Yeriwyn/VoronUsers/printer_mods/BladeScraper-Designs/Horizontal-Spool-Holder/img/Holder-Real.jpg

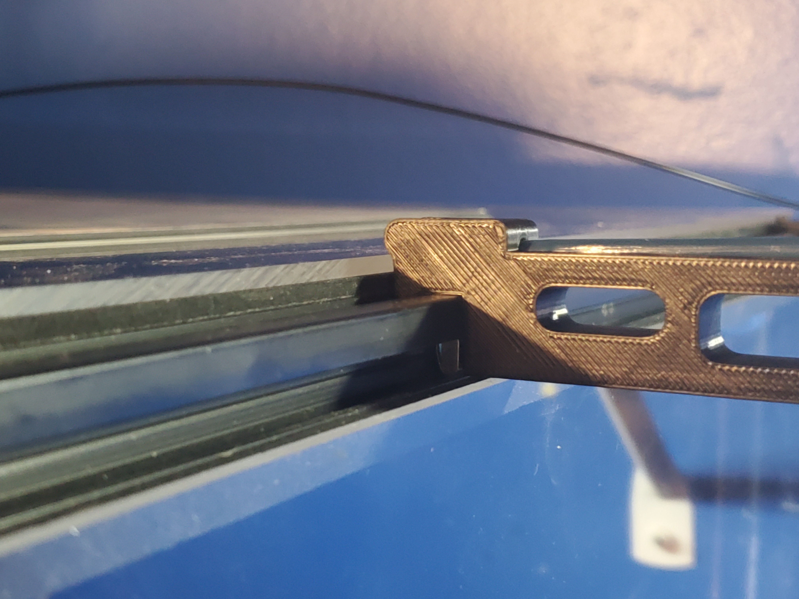
printer_mods/BladeScraper-Designs/Horizontal-Spool-Holder/img/Holder-Real.jpg
