Yeriwyn/VoronUsers/printer_mods/BladeScraper-Designs/Horizontal-Spool-Holder/img/Holder-with-spool.jpg

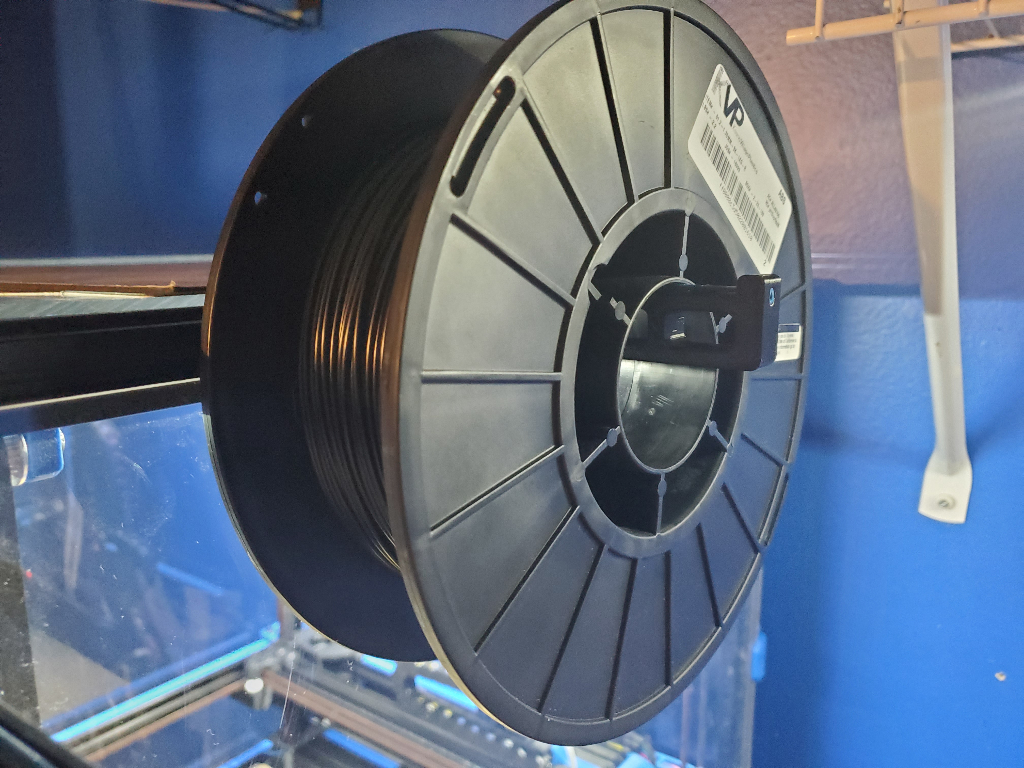
printer_mods/BladeScraper-Designs/Horizontal-Spool-Holder/img/Holder-with-spool.jpg
