Yeriwyn/VoronUsers/printer_mods/BladeScraper-Designs/Horizontal-Spool-Holder/img/Holder.png

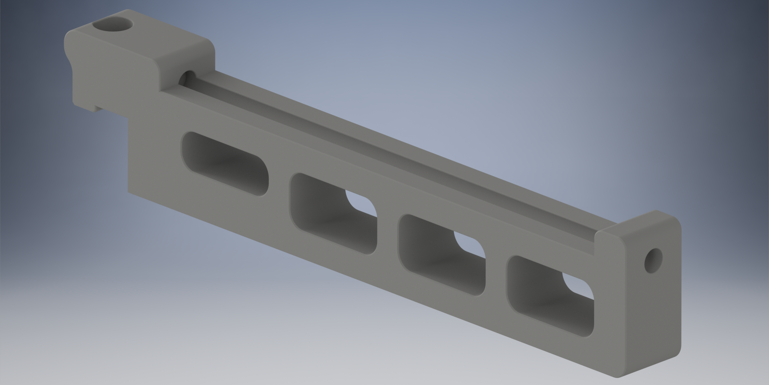
printer_mods/BladeScraper-Designs/Horizontal-Spool-Holder/img/Holder.png
