Yeriwyn/VoronUsers/printer_mods/BladeScraper-Designs/Horizontal-Spool-Holder/img/Holder_1.png

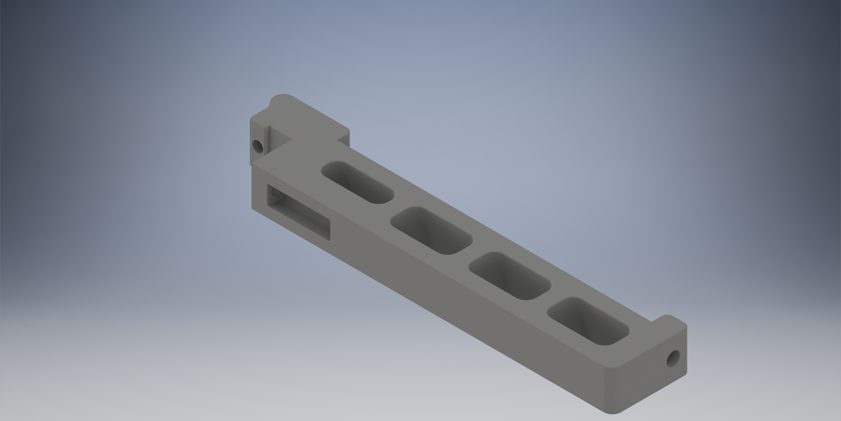
printer_mods/BladeScraper-Designs/Horizontal-Spool-Holder/img/Holder_1.png
