Yeriwyn/VoronUsers/printer_mods/JosAr/Klicky-Probe/Photos/AB_mount_components.jpg

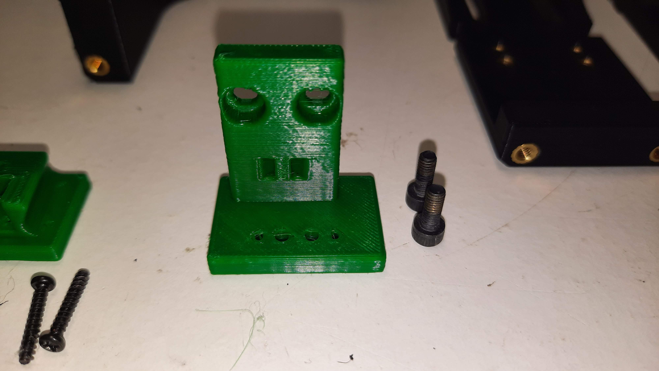
printer_mods/JosAr/Klicky-Probe/Photos/AB_mount_components.jpg
