Yeriwyn/VoronUsers/printer_mods/JosAr/Klicky-Probe/Photos/gantry_fixed_dock_mount_components.jpg

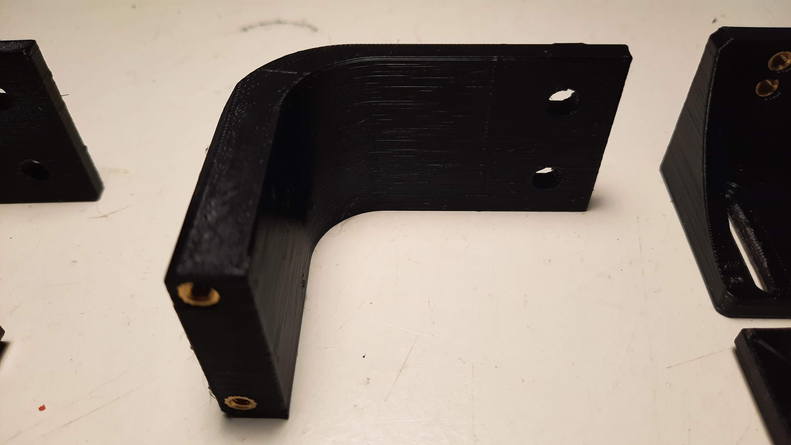
printer_mods/JosAr/Klicky-Probe/Photos/gantry_fixed_dock_mount_components.jpg
