Yeriwyn/VoronUsers/printer_mods/JosAr/Klicky-Probe/Photos/gantry_fixed_dock_sidemount_components.jpg

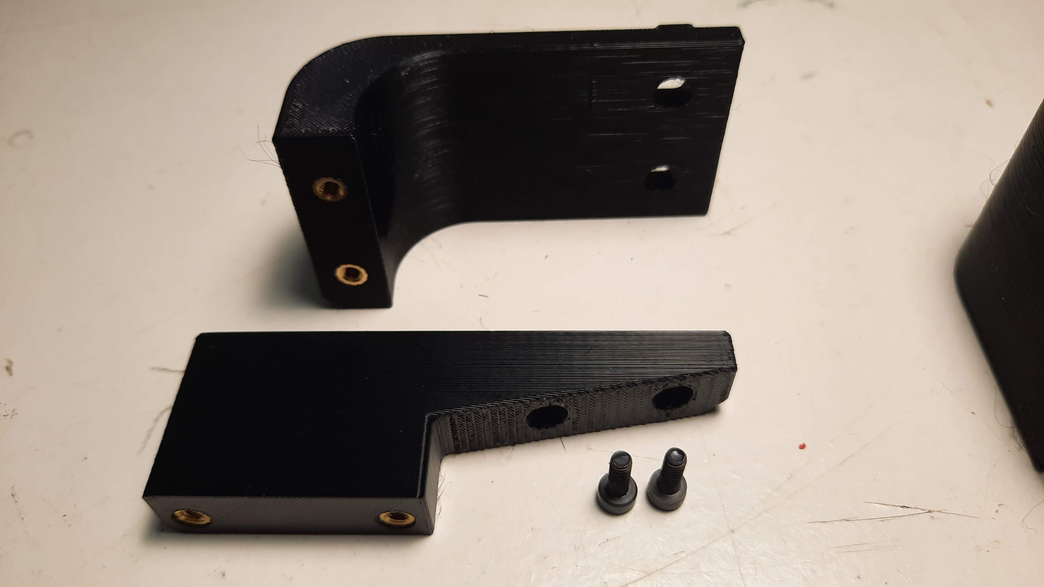
printer_mods/JosAr/Klicky-Probe/Photos/gantry_fixed_dock_sidemount_components.jpg
