Yeriwyn/VoronUsers/printer_mods/JosAr/Klicky-Probe/Photos/gantry_variable_dock_mount_components.jpg

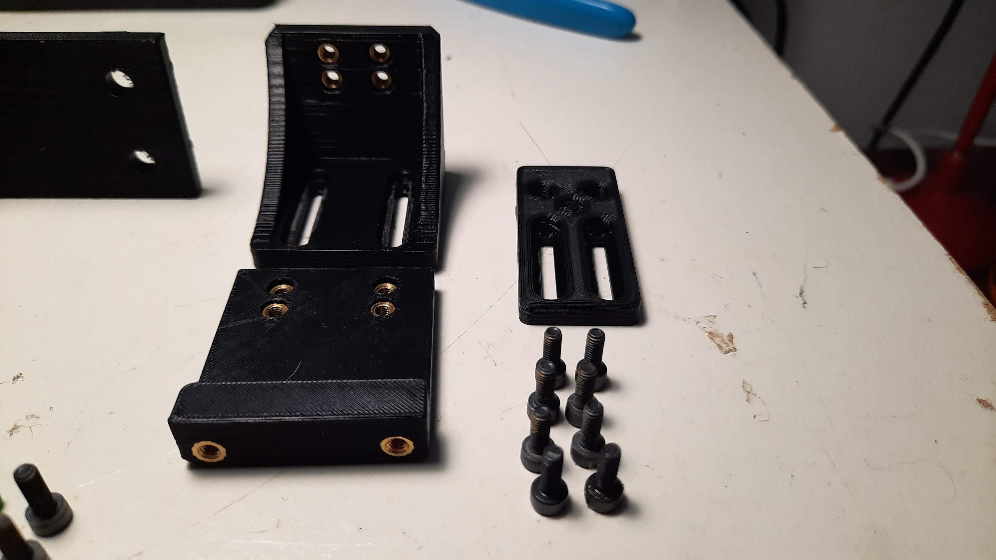
printer_mods/JosAr/Klicky-Probe/Photos/gantry_variable_dock_mount_components.jpg
