Yeriwyn/VoronUsers/printer_mods/Shteeeeeve/V01-LED-Tophat/STLs/LED-Tophat-Main-Body.stl

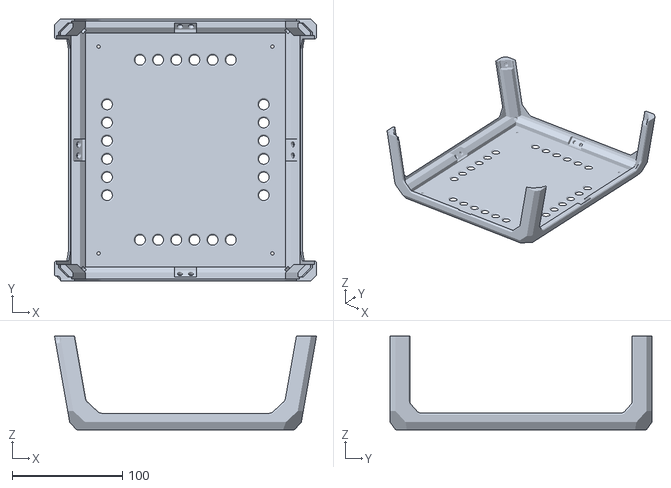
[picture p10: CAD file, 2021-07-27]
printer_mods/Shteeeeeve/V01-LED-Tophat/STLs/LED-Tophat-Main-Body.stl
238.0 x 238.0 x 85.0
