Yeriwyn/VoronUsers/printer_mods/alanho/BTT_PITFT50_v2_Mount/STLs/BTT-PITFT50-v2-Mount.stl

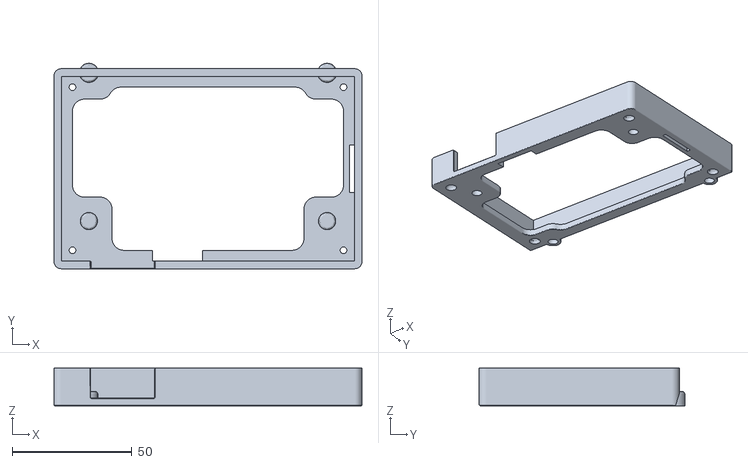
[picture p12: CAD file, 2021-06-30]
printer_mods/alanho/BTT_PITFT50_v2_Mount/STLs/BTT-PITFT50-v2-Mount.stl
128.4 x 85.7 x 15.7
