Yeriwyn/VoronUsers/printer_mods/Andre/Mini_Afterburner_ADXL345_Mount/STL/MiniAB_ADXL345_Mount.stl

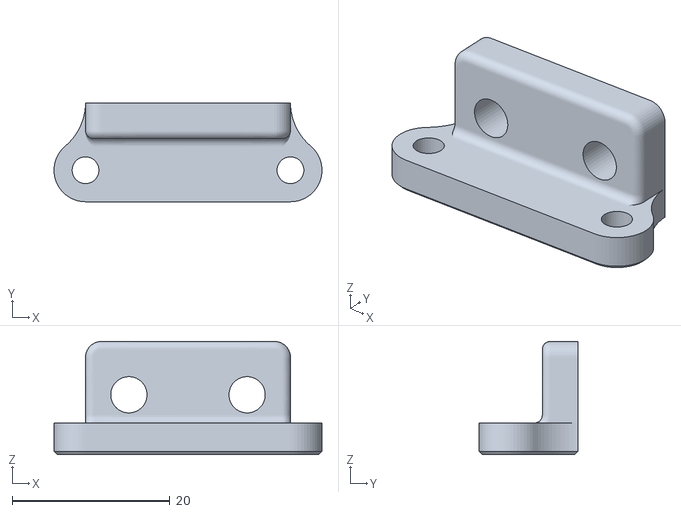
[picture p13: CAD file, 2021-06-30]
printer_mods/Andre/Mini_Afterburner_ADXL345_Mount/STL/MiniAB_ADXL345_Mount.stl
34.0 x 12.5 x 14.3
