Yeriwyn/VoronUsers/printer_mods/Andre/Mini_Afterburner_Strain_Relief/STL/Strain_Relief_Spacer_x2.stl

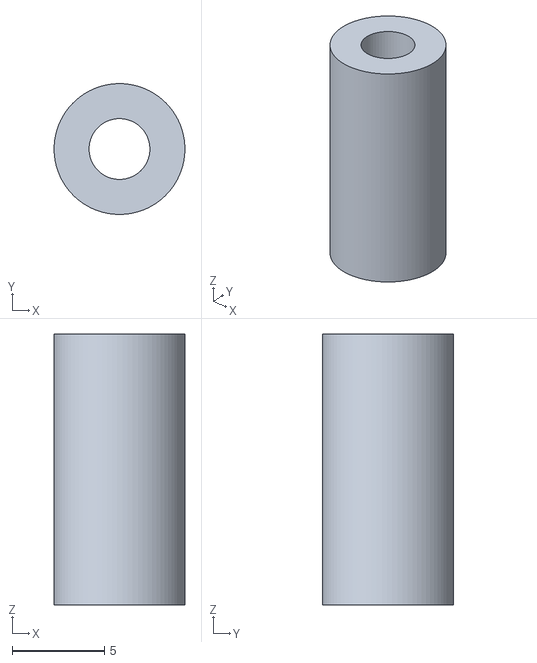
[picture p14: CAD file, 2021-06-30]
printer_mods/Andre/Mini_Afterburner_Strain_Relief/STL/Strain_Relief_Spacer_x2.stl
7.10 x 7.10 x 14.7
