Yeriwyn/VoronUsers/printer_mods/Andre/V0_Neopixel_Front_Bed_Mount/STL/Front_Bed_Mount_x1.stl

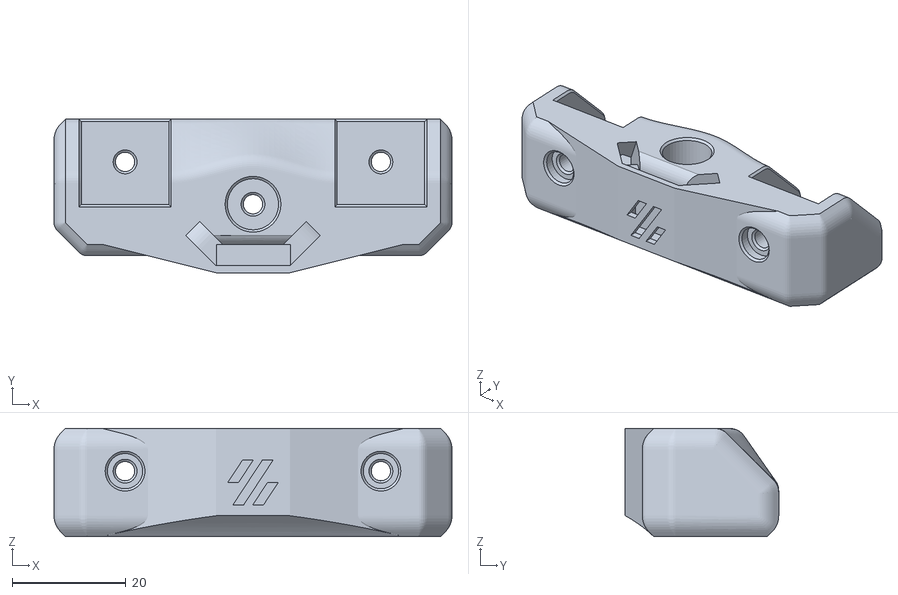
[picture p15: CAD file, 2021-06-30]
printer_mods/Andre/V0_Neopixel_Front_Bed_Mount/STL/Front_Bed_Mount_x1.stl
70.0 x 27.0 x 19.0
