Yeriwyn/VoronUsers/printer_mods/BladeScraper-Designs/Horizontal-Spool-Holder/Holder.stp

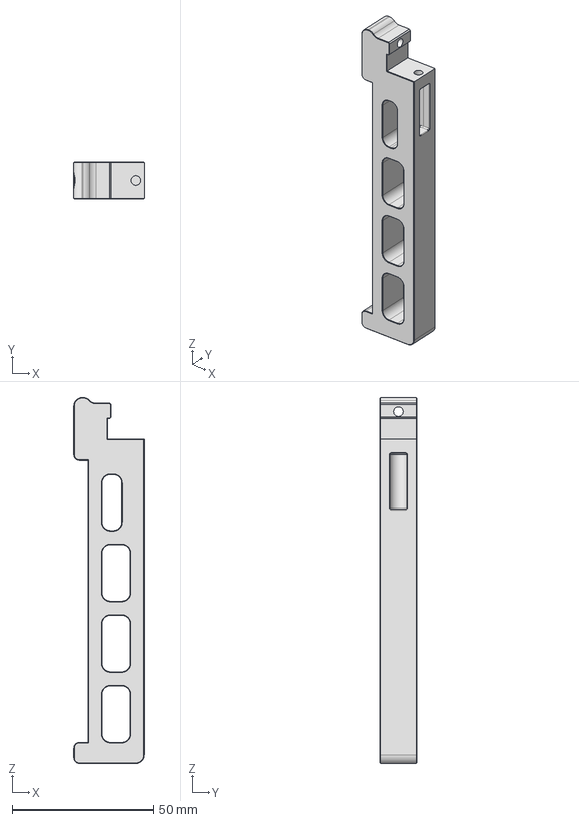
[picture p16: CAD file, 2021-06-30]
printer_mods/BladeScraper-Designs/Horizontal-Spool-Holder/Holder.stp
25.0 x 13.0 x 129.8 mm
