Yeriwyn/VoronUsers/printer_mods/buzzdalf/ytension/STL/hexnut.stl

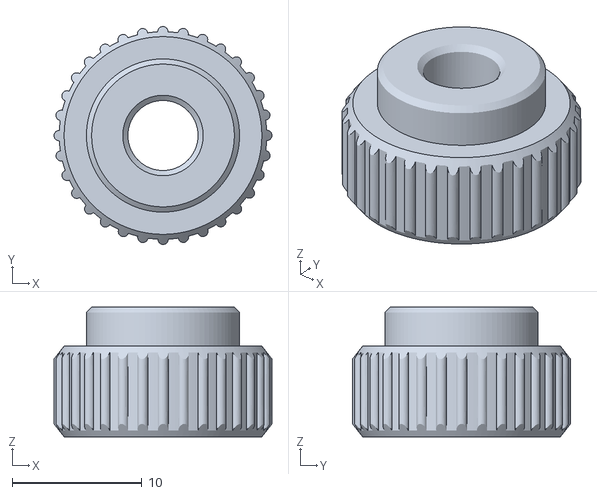
[picture p17: CAD file, 2021-06-30]
printer_mods/buzzdalf/ytension/STL/hexnut.stl
16.8 x 16.8 x 10.0
