Yeriwyn/VoronUsers/printer_mods/Ch4rlesB/V0_Handles_Slim/V0_Handles_Slim_3_Panel_x2.stl

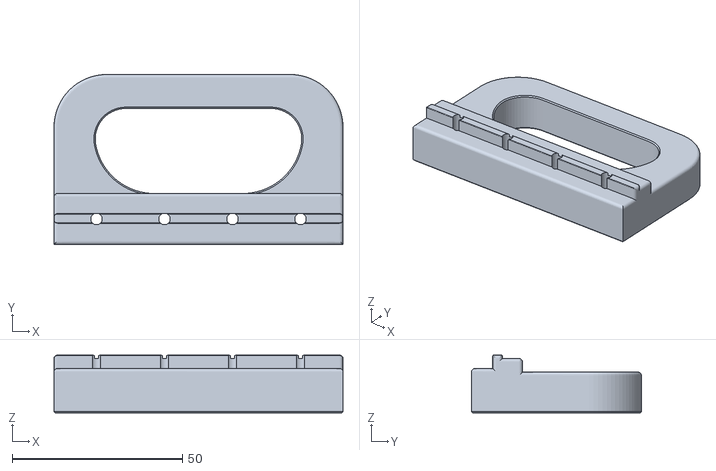
[picture p18: CAD file, 2021-06-30]
printer_mods/Ch4rlesB/V0_Handles_Slim/V0_Handles_Slim_3_Panel_x2.stl
85.0 x 50.0 x 17.0
