Yeriwyn/VoronUsers/printer_mods/DaGlo/Voron_V0_Duet_2_WiFi_Mounting_Brackets/Duet2Wifi_Mounting_Bracket_with_RPi.stl

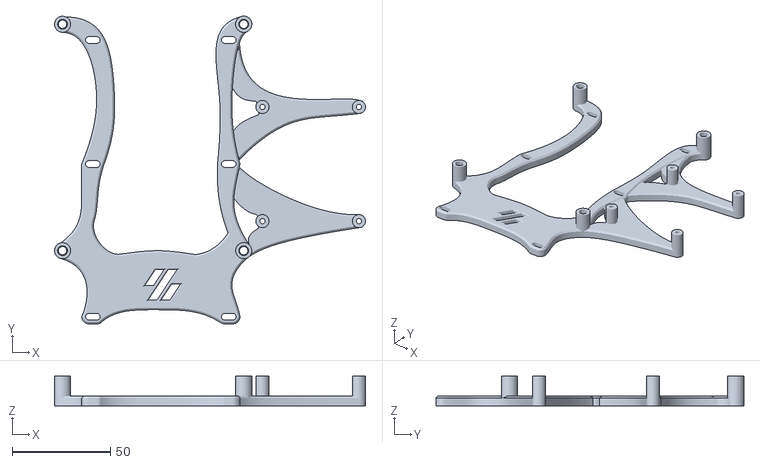
[picture p20: CAD file, 2021-06-30]
printer_mods/DaGlo/Voron_V0_Duet_2_WiFi_Mounting_Brackets/Duet2Wifi_Mounting_Bracket_with_RPi.stl
157.9 x 156.4 x 15.0
