Yeriwyn/VoronUsers/printer_mods/DaGlo/Voron_V0_MW_PS_Bracket/Voron_V0_MW_PS_Bracket.stl

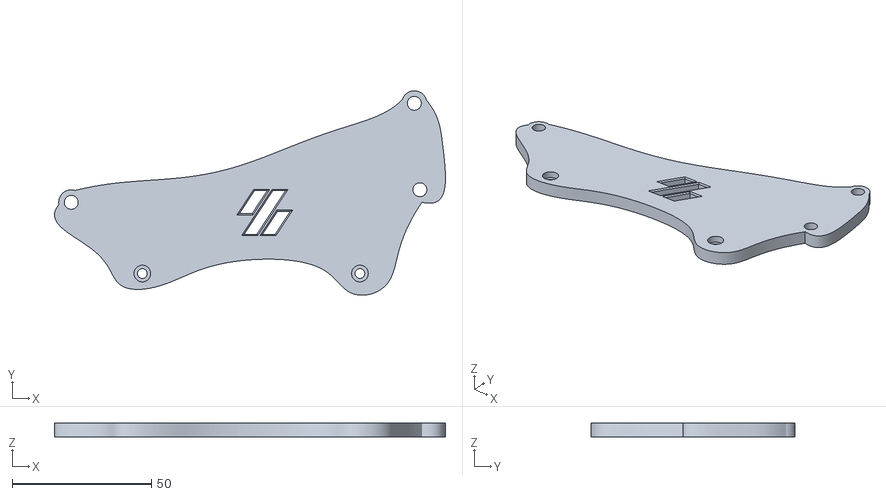
[picture p21: CAD file, 2021-06-30]
printer_mods/DaGlo/Voron_V0_MW_PS_Bracket/Voron_V0_MW_PS_Bracket.stl
140.2 x 73.3 x 5.00
