Yeriwyn/VoronUsers/printer_mods/DaGlo/Voron_V0_SSR_Mount/Voron_V0_SSR_Mount.stl

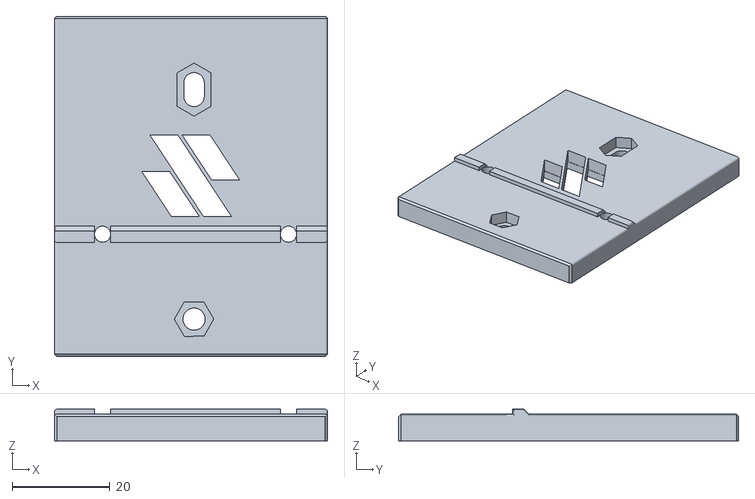
[picture p22: CAD file, 2021-06-30]
printer_mods/DaGlo/Voron_V0_SSR_Mount/Voron_V0_SSR_Mount.stl
55.8 x 69.5 x 6.45
