Yeriwyn/VoronUsers/printer_mods/DoubleT/afterburner_triple_bowden/STLs/Bowden_Triple_Adapter_front_b.stl

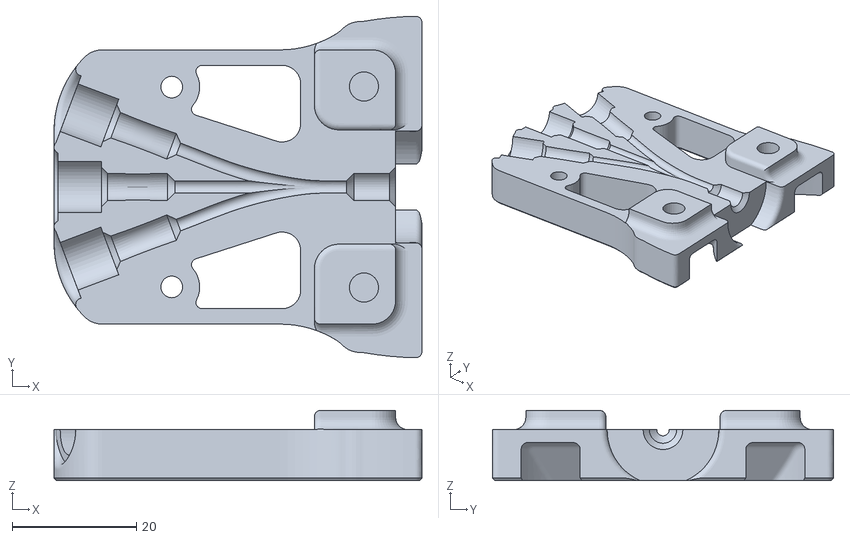
[picture p23: CAD file, 2021-06-30]
printer_mods/DoubleT/afterburner_triple_bowden/STLs/Bowden_Triple_Adapter_front_b.stl
59.3 x 55.0 x 11.3
