Yeriwyn/VoronUsers/printer_mods/DoubleT/fysetc_spider_mount_extrusion/STLs/spider_mount.stl

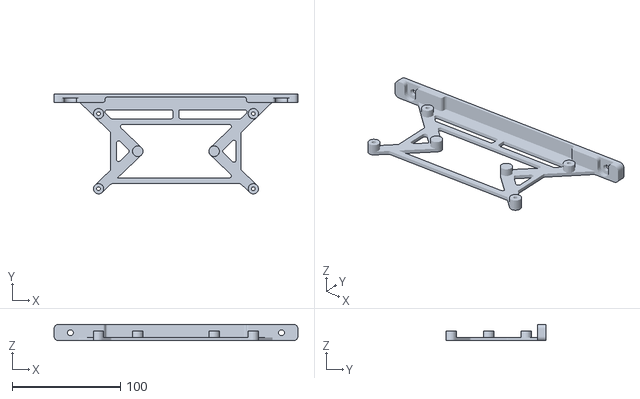
[picture p24: CAD file, 2021-06-30]
printer_mods/DoubleT/fysetc_spider_mount_extrusion/STLs/spider_mount.stl
225.1 x 92.1 x 15.0
