Yeriwyn/VoronUsers/printer_mods/DoubleT/switchwire_tft_display/STLs/Display_Front_Plate.stl

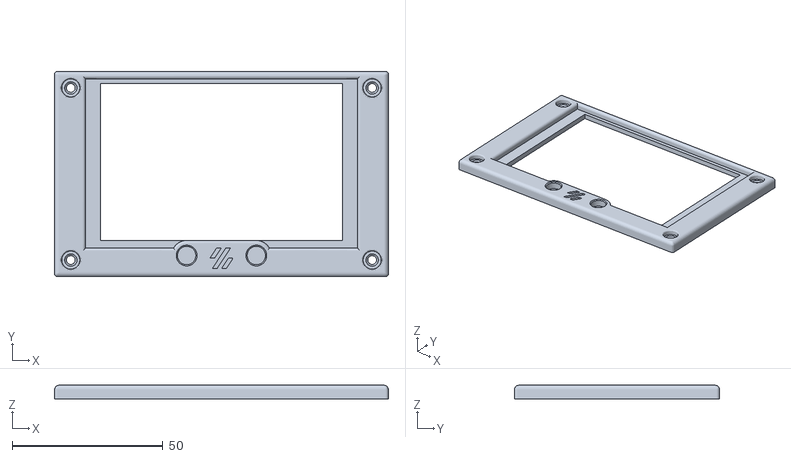
[picture p26: CAD file, 2021-06-30]
printer_mods/DoubleT/switchwire_tft_display/STLs/Display_Front_Plate.stl
110.6 x 68.0 x 4.50
