Yeriwyn/VoronUsers/printer_mods/geoffreyyoung/spider_bracket/STLs/spider_bracket.stl

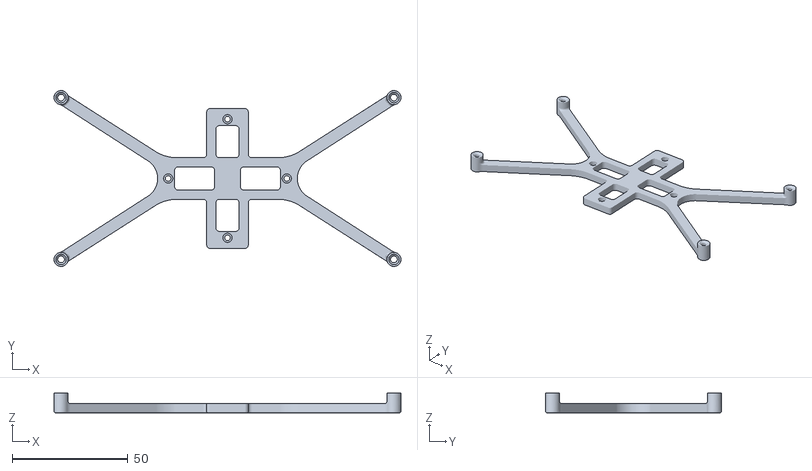
[picture p28: CAD file, 2021-06-30]
printer_mods/geoffreyyoung/spider_bracket/STLs/spider_bracket.stl
150.1 x 76.1 x 8.50
