Yeriwyn/VoronUsers/printer_mods/hartk1213/Voron0_MGN9C_X_Axis/STLs/x_carriage_miniaftb-MGN9C_x1.stl

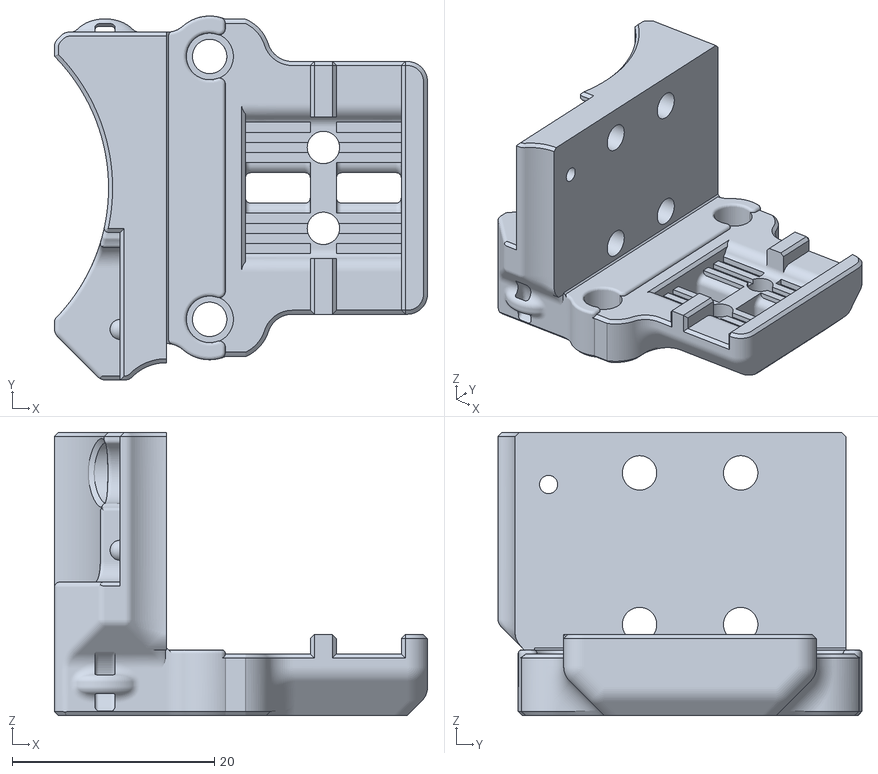
[picture p29: CAD file, 2021-06-30]
printer_mods/hartk1213/Voron0_MGN9C_X_Axis/STLs/x_carriage_miniaftb-MGN9C_x1.stl
36.9 x 36.0 x 28.0
