Yeriwyn/VoronUsers/printer_mods/JosAr/Klicky-Probe/CAD/KlickyProbe_v0_2.step

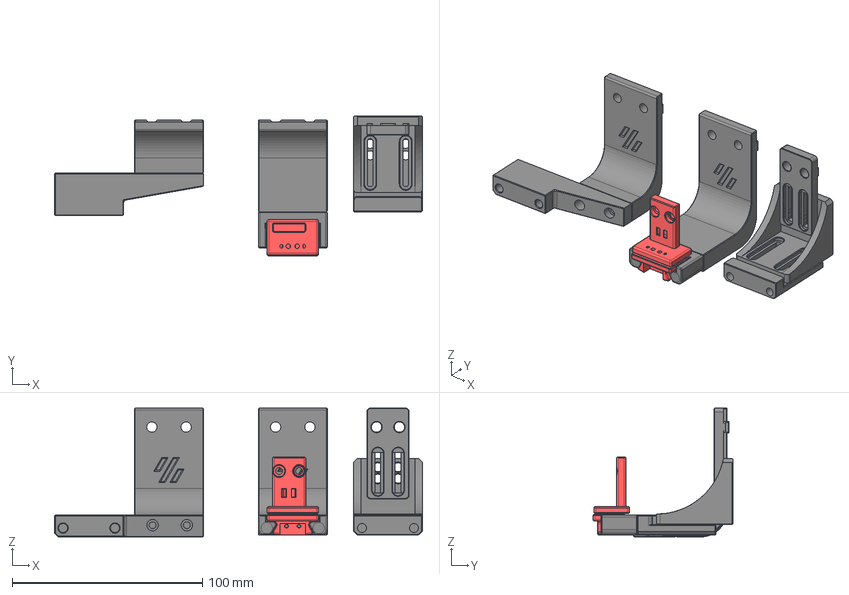
[picture p30: CAD file, 2021-06-30]
printer_mods/JosAr/Klicky-Probe/CAD/KlickyProbe_v0_2.step
193.3 x 73.5 x 67.7 mm
AB mount
Dock Mount variable Assembly
Dock Mount fixed
Dock Sidemount fixed
Probe Dock v0.2
Probe v0.2
