Yeriwyn/VoronUsers/printer_mods/JosAr/Klicky-Probe/STL/KlickyProbe_Dock_Mount_Variable_pt3.stl

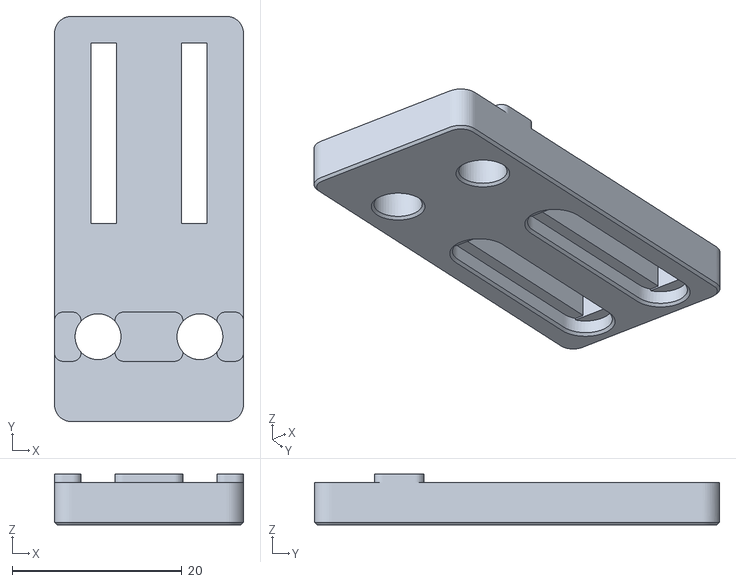
[picture p31: CAD file, 2021-06-30]
printer_mods/JosAr/Klicky-Probe/STL/KlickyProbe_Dock_Mount_Variable_pt3.stl
22.3 x 47.7 x 5.98
