Yeriwyn/VoronUsers/printer_mods/JosAr/Klicky-Probe/Usermods/oc_geek/oc_geek.step

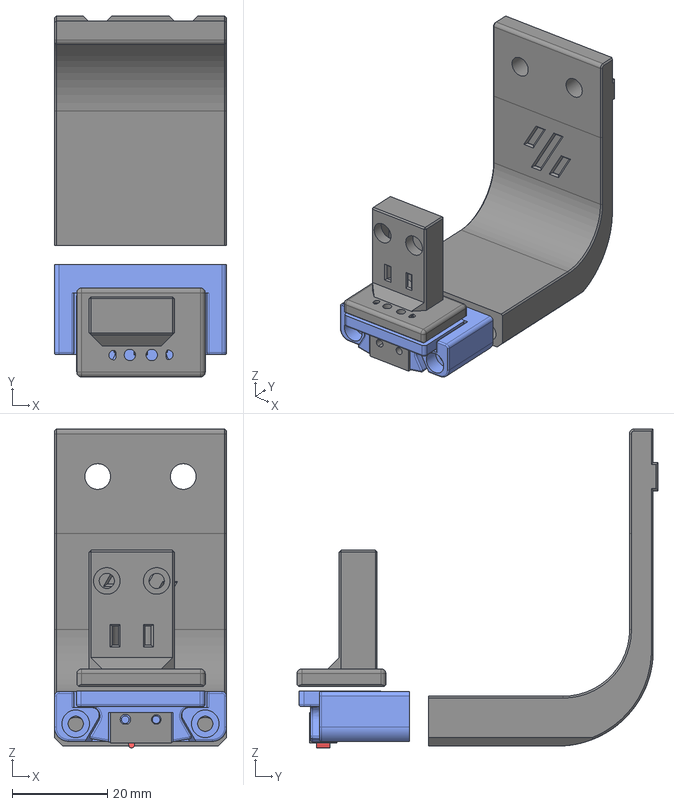
[picture p32: CAD file, 2021-06-30]
printer_mods/JosAr/Klicky-Probe/Usermods/oc_geek/oc_geek.step
36.3 x 76.0 x 67.1 mm
AB mount
Probe Dock v2
Dock Mount fixed
D2F_BASE (1)
D2F_ACTUATOR (1)
