Yeriwyn/VoronUsers/printer_mods/KevinAkaSam/VEFACH/STL_CAD/0_filterdummy_dont_print.stl

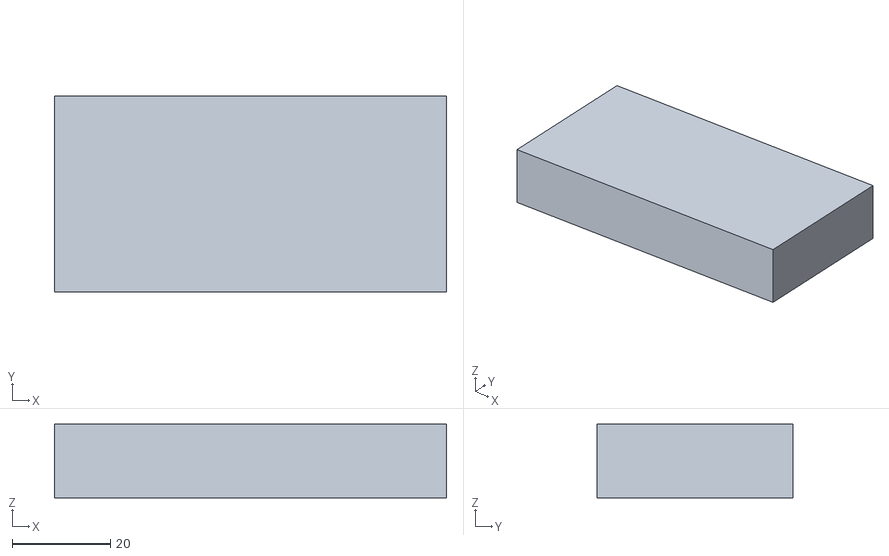
[picture p33: CAD file, 2021-06-30]
printer_mods/KevinAkaSam/VEFACH/STL_CAD/0_filterdummy_dont_print.stl
80.0 x 40.0 x 15.0
