Yeriwyn/VoronUsers/printer_mods/khay/micro_backplate/microback_left.stl

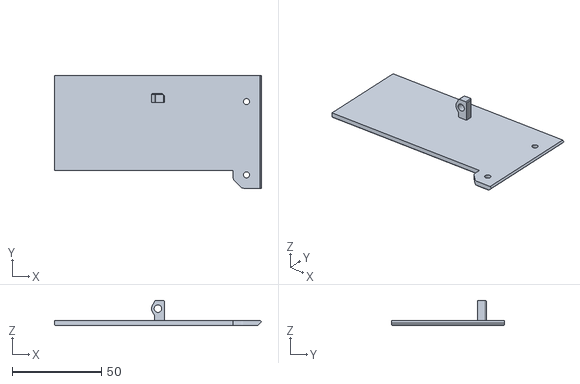
[picture p34: CAD file, 2021-07-27]
printer_mods/khay/micro_backplate/microback_left.stl
115.9 x 63.0 x 14.2
