Yeriwyn/VoronUsers/printer_mods/LoCoCNC/ssr_strap/SSR_STRAP.stl

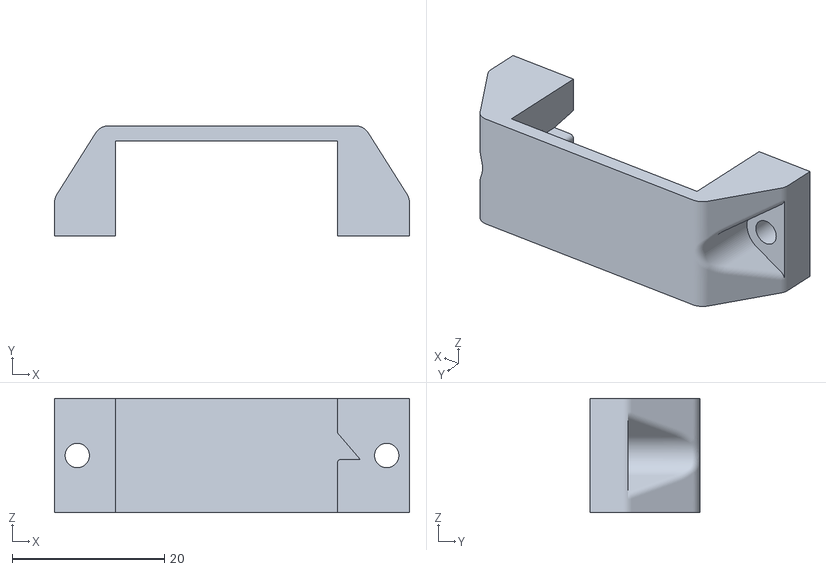
[picture p35: CAD file, 2021-06-30]
printer_mods/LoCoCNC/ssr_strap/SSR_STRAP.stl
46.7 x 14.5 x 15.0
