Yeriwyn/VoronUsers/printer_mods/LoCoCNC/Strain_Relief_w_Microfit/Strain_Relief_Body_MF10_x1.stl

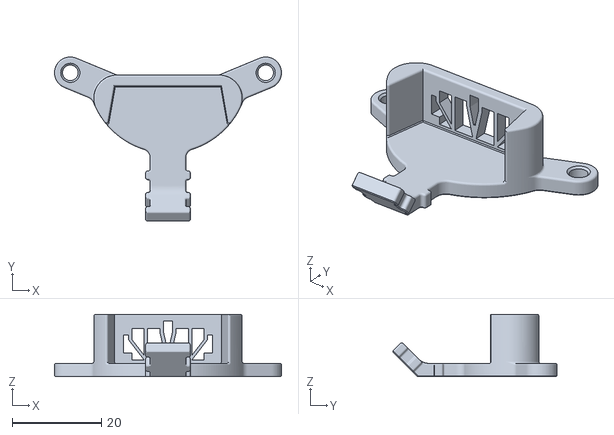
[picture p36: CAD file, 2021-06-30]
printer_mods/LoCoCNC/Strain_Relief_w_Microfit/Strain_Relief_Body_MF10_x1.stl
50.9 x 36.8 x 14.0
