Yeriwyn/VoronUsers/printer_mods/Majarspeed/Hartk_Mount_Galileo/Hartk_optional_spacer_X2.stl

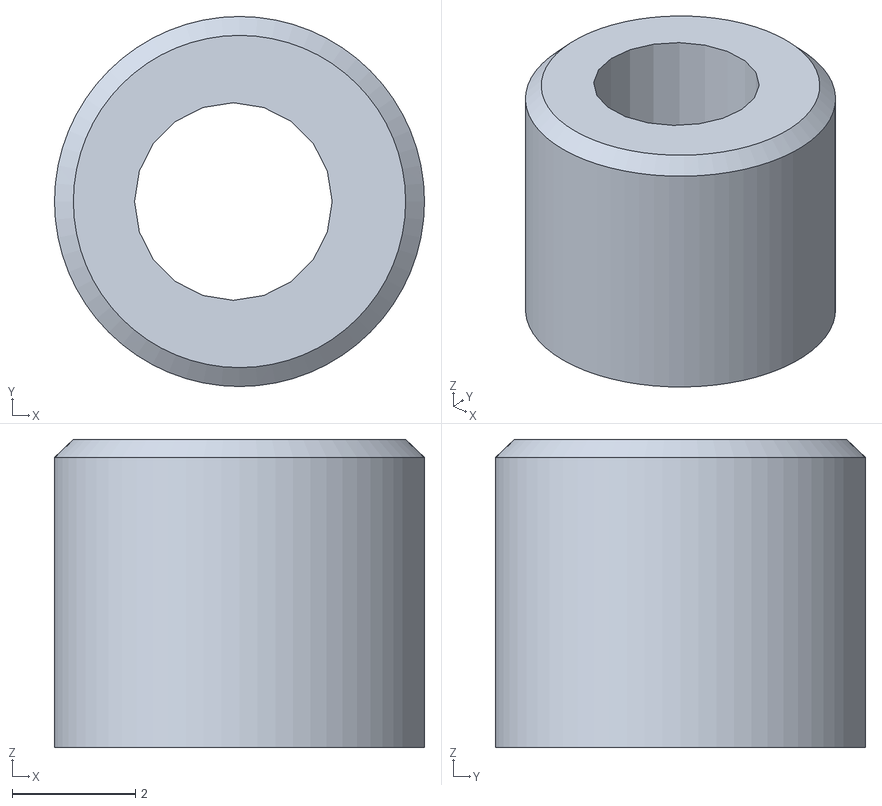
[picture p37: CAD file, 2021-06-30]
printer_mods/Majarspeed/Hartk_Mount_Galileo/Hartk_optional_spacer_X2.stl
6.00 x 6.00 x 5.00
