Yeriwyn/VoronUsers/printer_mods/MathematicalPotato/v0.1_belted_z_drive/STL/V0-zbelt-BEDMOUNT_MODIFIED_V0.1.stl

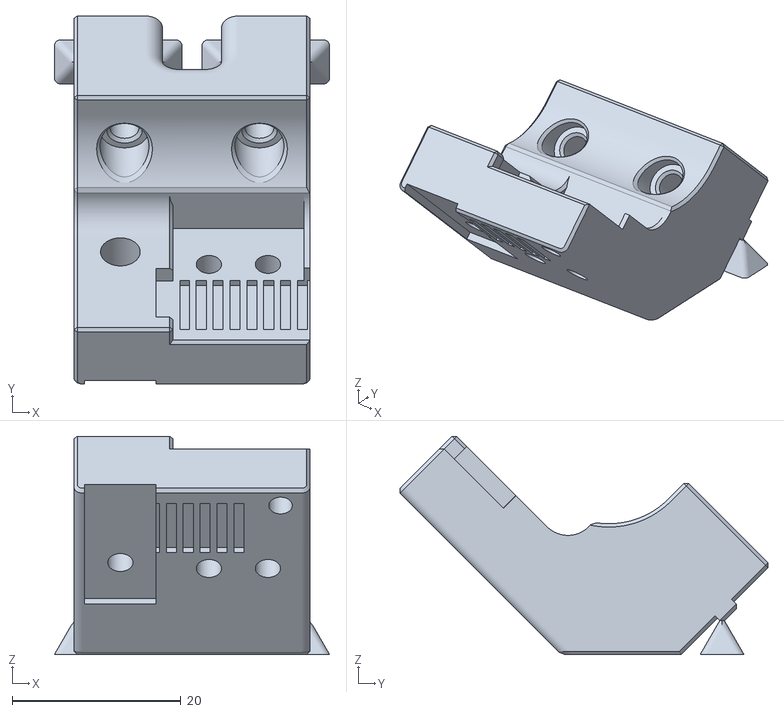
[picture p38: CAD file, 2021-06-30]
printer_mods/MathematicalPotato/v0.1_belted_z_drive/STL/V0-zbelt-BEDMOUNT_MODIFIED_V0.1.stl
32.7 x 43.6 x 25.9
