Yeriwyn/VoronUsers/printer_mods/mpfl/V0.1_skirt_OLED/v0.1-skirt-oled.stl

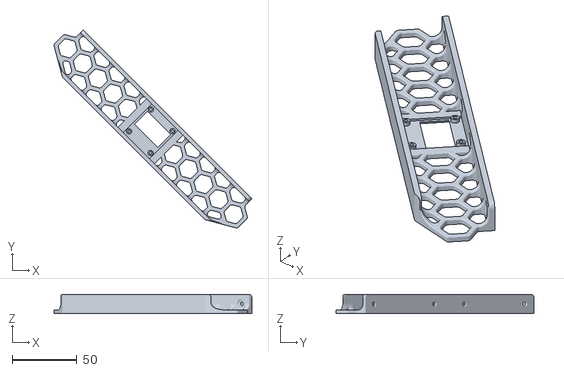
[picture p39: CAD file, 2021-07-27]
printer_mods/mpfl/V0.1_skirt_OLED/v0.1-skirt-oled.stl
152.4 x 152.4 x 15.0
