Yeriwyn/VoronUsers/printer_mods/oxno/rbp_zero_braket/rbp_zero_bracket.stl

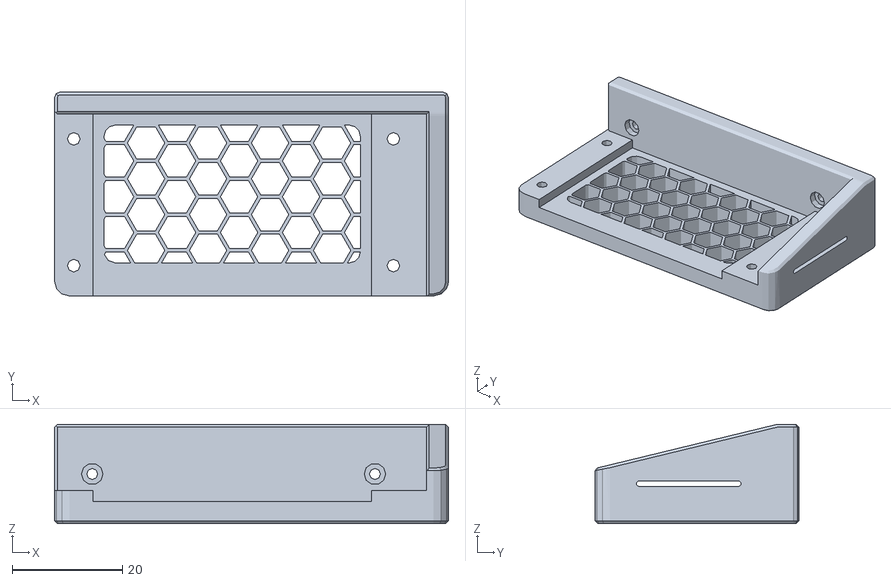
[picture p40: CAD file, 2021-06-30]
printer_mods/oxno/rbp_zero_braket/rbp_zero_bracket.stl
71.5 x 37.0 x 18.0
