Yeriwyn/VoronUsers/printer_mods/Phalanx/Other-V2-Idlers/CAD/Other_Idler_V2.step

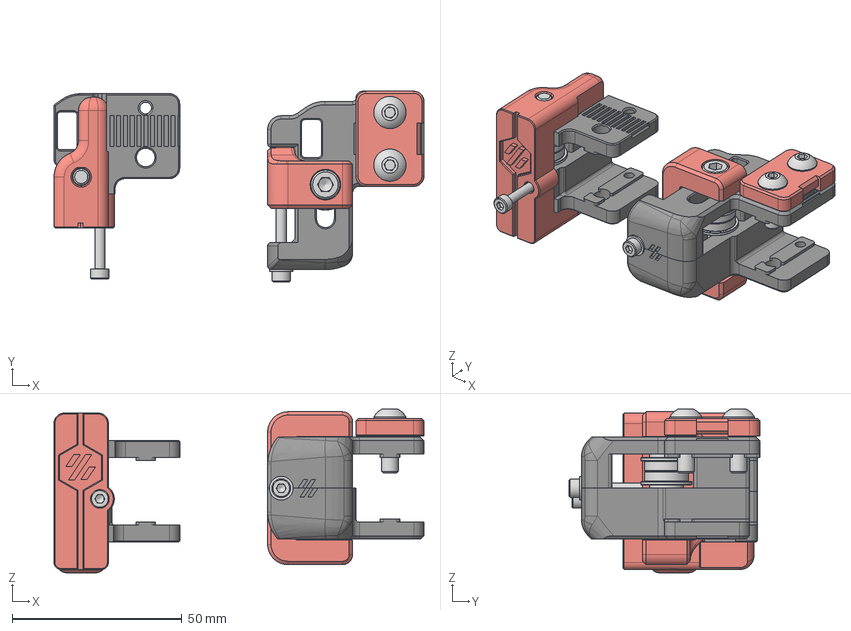
[picture p41: CAD file, 2021-07-27]
printer_mods/Phalanx/Other-V2-Idlers/CAD/Other_Idler_V2.step
108.9 x 56.1 x 48.1 mm
M5 1mm Spacer (1) (1) x 2
F695 ZZ (1) (1) x 2
Front Idler A Bottom (1) (1) (1)
Front Idler A Top (1) (1)
5mmx45mm pin
Idler_Carrier
M5x16 BHCS (1) (1) (1) x 2
Z Belt Clamp Upper (1) (1)
M5x40 SHCS (1)
M5 Hexnut (1)
M5 1mm Spacer (1) (1) (1) x 2
F695 ZZ (1) (1) (1) x 2
M3 Threaded Insert (1)
M3x40 SHCS (1) (1) x 2
M3 Washer (1) (1)
Front Idler A Bottom (1) (1) (1) (1)
Front Idler A Top (1) (1) (1)
M3 Threaded Insert (1) (1)
