Yeriwyn/VoronUsers/printer_mods/Phalanx/Other-V2-Idlers/STL/[a]_Idler_Carrierx2.stl

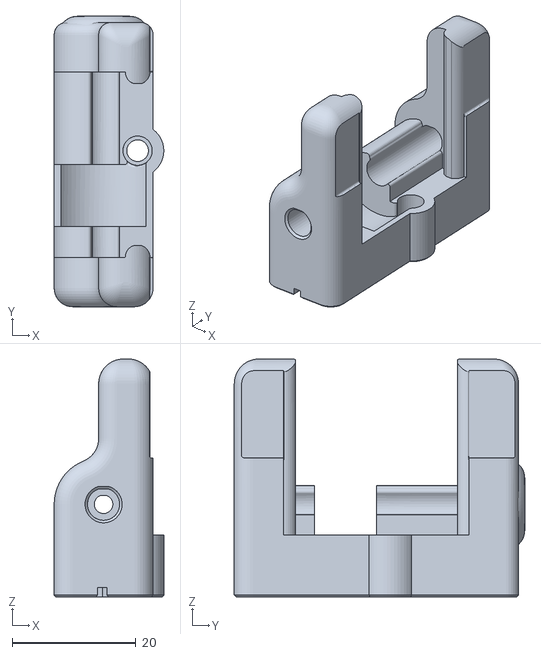
[picture p42: CAD file, 2021-07-27]
printer_mods/Phalanx/Other-V2-Idlers/STL/[a]_Idler_Carrierx2.stl
17.8 x 47.0 x 38.5
