Yeriwyn/VoronUsers/printer_mods/Printopal/Magnetic_top_panel/STEP/350_top_skirt_320.stp

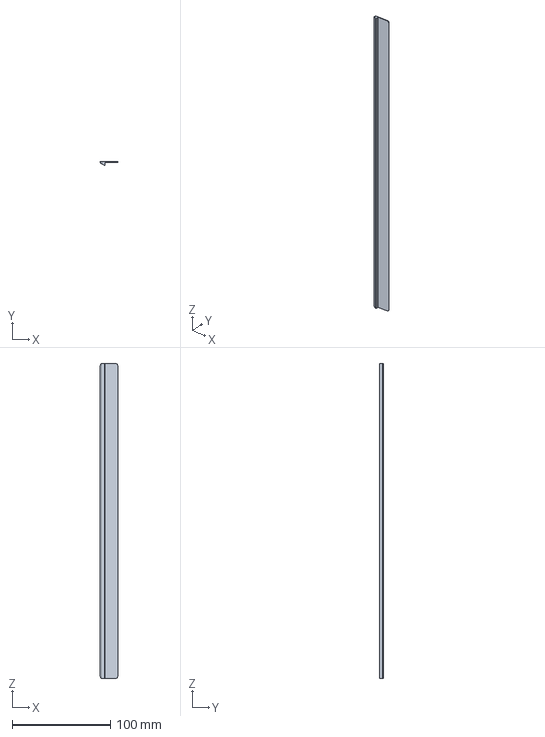
[picture p43: CAD file, 2021-07-27]
printer_mods/Printopal/Magnetic_top_panel/STEP/350_top_skirt_320.stp
17.8 x 4.40 x 320.0 mm
