Yeriwyn/VoronUsers/printer_mods/revnull/rpi_7in_display_mount/STL/swing_arm_lg_a.stl

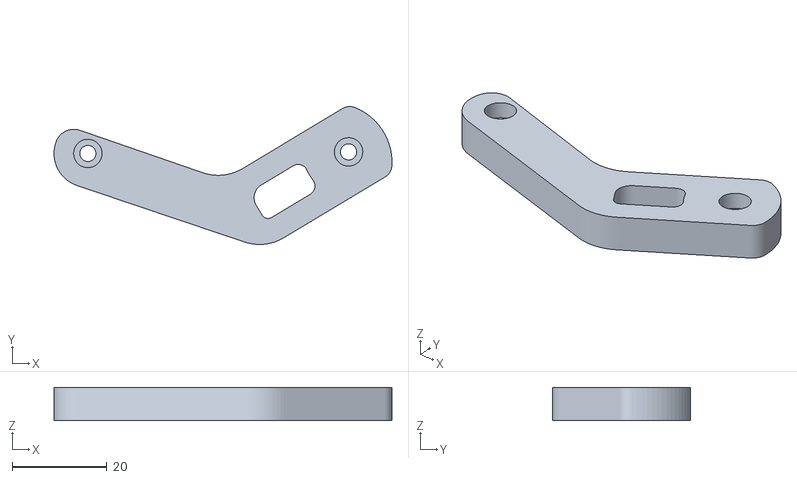
[picture p44: CAD file, 2021-07-27]
printer_mods/revnull/rpi_7in_display_mount/STL/swing_arm_lg_a.stl
71.3 x 29.1 x 7.00
