Yeriwyn/VoronUsers/printer_mods/rsheng118/BTT_octopus_DIN_vertical_mount/STEP/spacer.stp

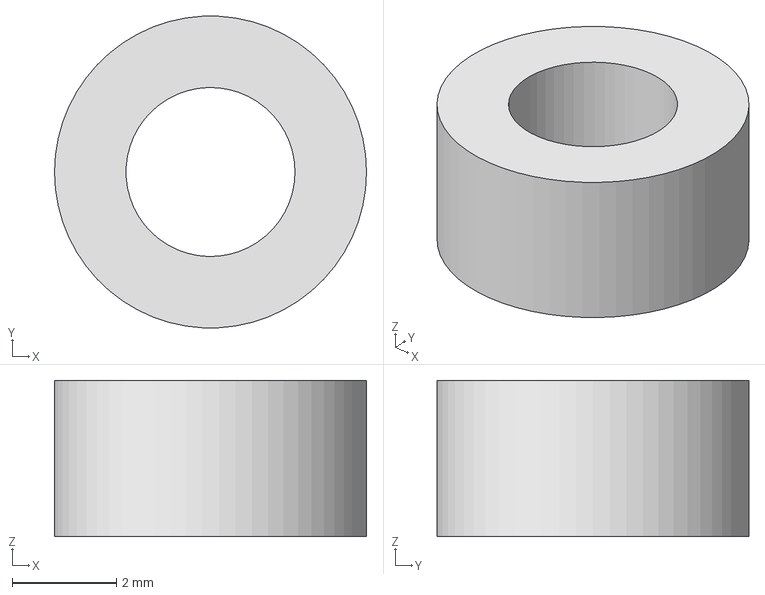
[picture p45: CAD file, 2021-07-27]
printer_mods/rsheng118/BTT_octopus_DIN_vertical_mount/STEP/spacer.stp
6.00 x 5.99 x 3.00 mm
