Yeriwyn/VoronUsers/printer_mods/Shteeeeeve/V01-LED-Tophat/STEP/V01-LED-Tophat.step

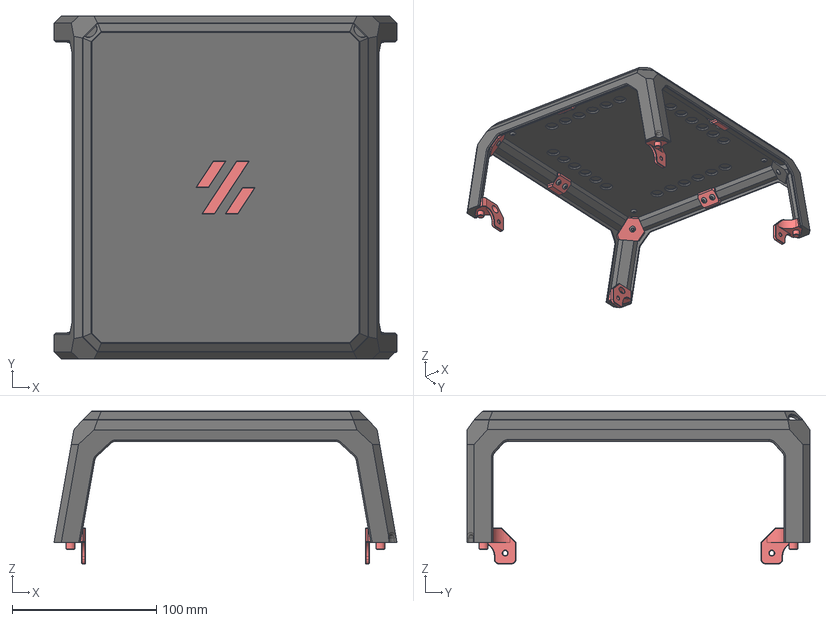
[picture p46: CAD file, 2021-07-27]
printer_mods/Shteeeeeve/V01-LED-Tophat/STEP/V01-LED-Tophat.step
238.0 x 238.0 x 106.0 mm
Tophat (1)
M3x8 BHCS-1 x 8
M3 Threaded Insert x 16
M3x12 BHCS x 8
LED Tophat - Top Cover
LED Tophat - Main Body
LED Tophat - Logo Insert
M3 Threaded Insert (1) x 4
M3x6 BHCS-1 (1) x 4
