Yeriwyn/VoronUsers/printer_mods/sse018/Octopus_DIN_Rail_bracket/STL/Octopus_DIN_bracket_x2.stl

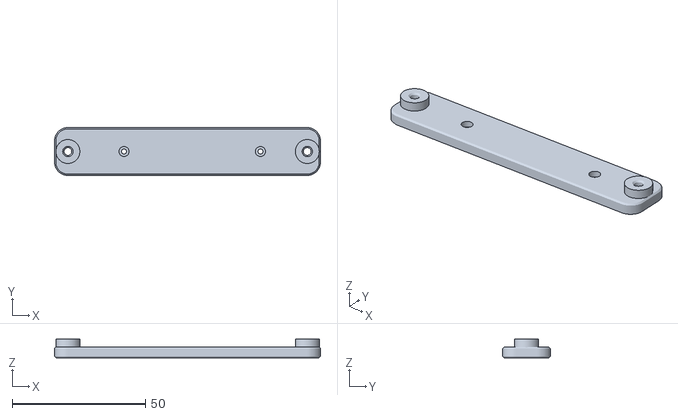
[picture p47: CAD file, 2021-07-27]
printer_mods/sse018/Octopus_DIN_Rail_bracket/STL/Octopus_DIN_bracket_x2.stl
100.0 x 18.0 x 7.00
