Yeriwyn/VoronUsers/printer_mods/Triano/Ender_3Pro_Switchwire/STL/Deck/[a]_deck_y_chain_anchor.stl

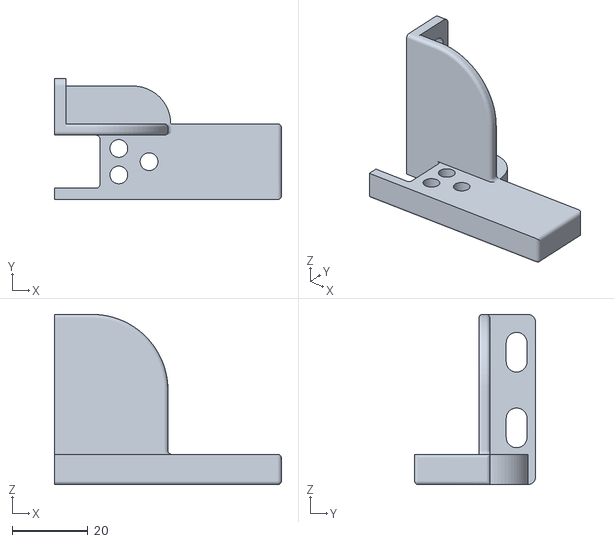
[picture p48: CAD file, 2021-06-30]
printer_mods/Triano/Ender_3Pro_Switchwire/STL/Deck/[a]_deck_y_chain_anchor.stl
60.0 x 32.0 x 45.0
