Yeriwyn/VoronUsers/printer_mods/Triano/Ender_3Pro_Switchwire/STL/Electronics/[a]_ps_hanger.stl

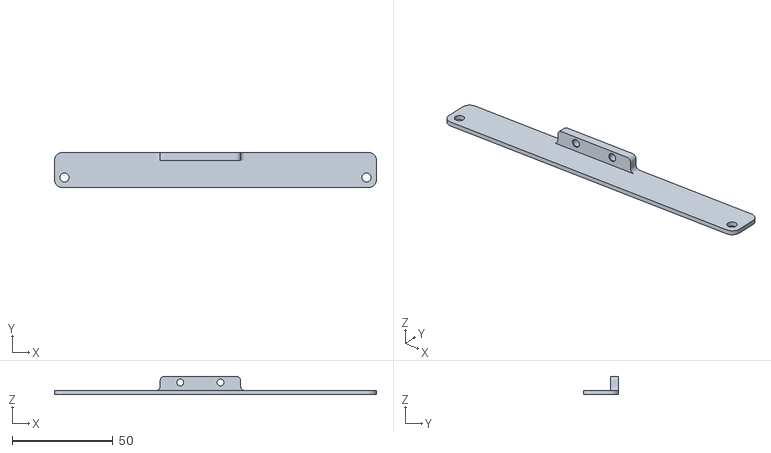
[picture p49: CAD file, 2021-06-30]
printer_mods/Triano/Ender_3Pro_Switchwire/STL/Electronics/[a]_ps_hanger.stl
160.0 x 17.5 x 9.00
