Yeriwyn/VoronUsers/printer_mods/Triano/Ender_3Pro_Switchwire/STL/Grill/[a]_grill_endcap_x4.stl

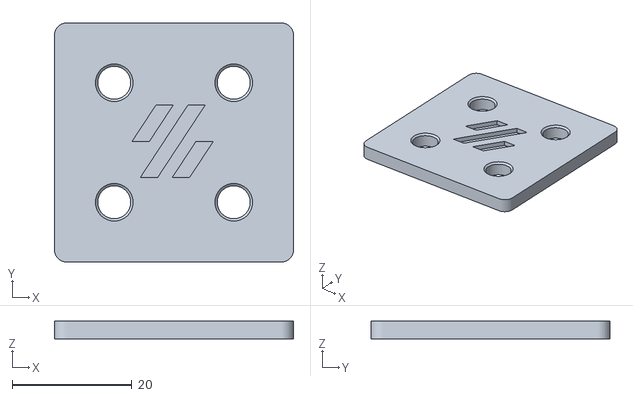
[picture p50: CAD file, 2021-06-30]
printer_mods/Triano/Ender_3Pro_Switchwire/STL/Grill/[a]_grill_endcap_x4.stl
40.0 x 40.0 x 3.00
