Yeriwyn/VoronUsers/printer_mods/Triano/Ender_3Pro_Switchwire/STL/Misc/4040_rail_tool.stl

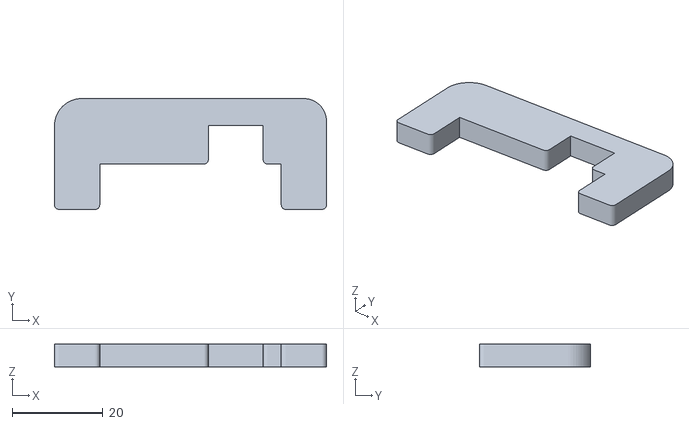
[picture p51: CAD file, 2021-06-30]
printer_mods/Triano/Ender_3Pro_Switchwire/STL/Misc/4040_rail_tool.stl
60.1 x 24.5 x 5.00
