Yeriwyn/VoronUsers/printer_mods/Triano/Ender_3Pro_Switchwire/STL/XZ-Axis/xz_block_right_b.stl

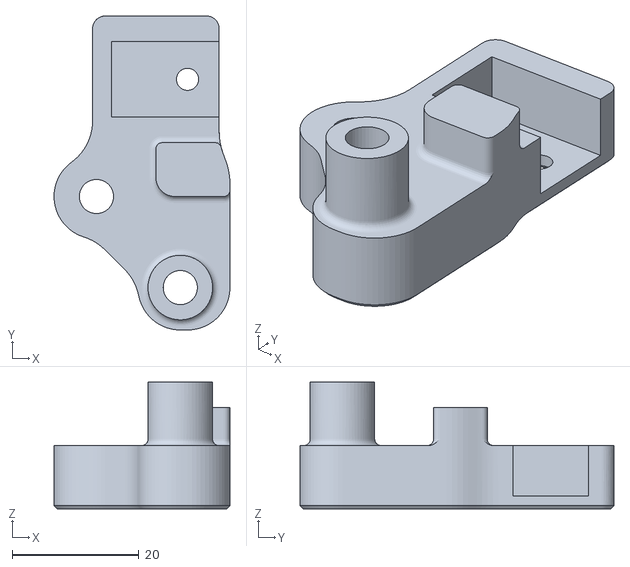
[picture p52: CAD file, 2021-06-30]
printer_mods/Triano/Ender_3Pro_Switchwire/STL/XZ-Axis/xz_block_right_b.stl
27.8 x 49.6 x 20.0
