Yeriwyn/VoronUsers/printer_mods/Triano/Ender_3Pro_Switchwire/STL/Y-Axis/[a]_y_motor_mount_b.stl

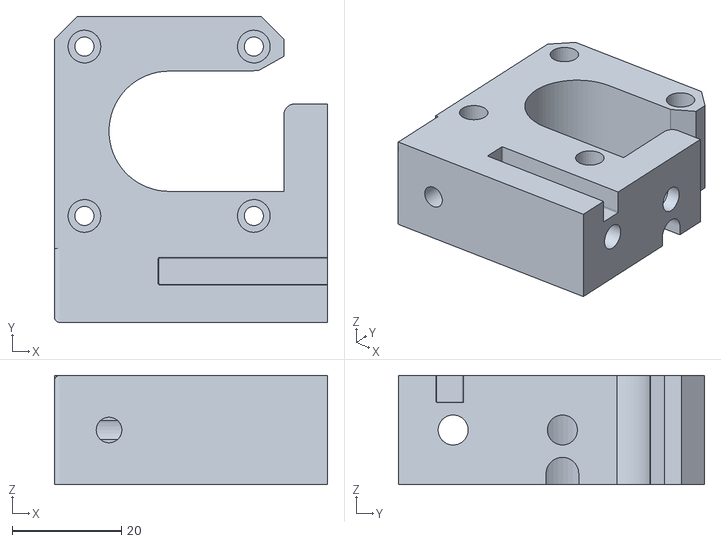
[picture p53: CAD file, 2021-06-30]
printer_mods/Triano/Ender_3Pro_Switchwire/STL/Y-Axis/[a]_y_motor_mount_b.stl
50.0 x 56.0 x 20.0
