Yeriwyn/VoronUsers/printer_mods/Ultrawaffles/Ender_3_to_SW/DXF/left_deck.dxf

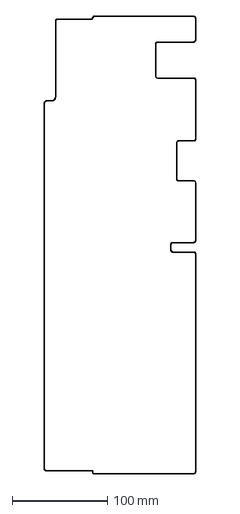
[picture p54: CAD file, 2021-07-27]
printer_mods/Ultrawaffles/Ender_3_to_SW/DXF/left_deck.dxf
159.0 x 481.0 mm
