Yeriwyn/VoronUsers/printer_mods/Ultrawaffles/Ender_3_to_SW/STLs/Electronics/psu_2060_mount_x2_b.stl

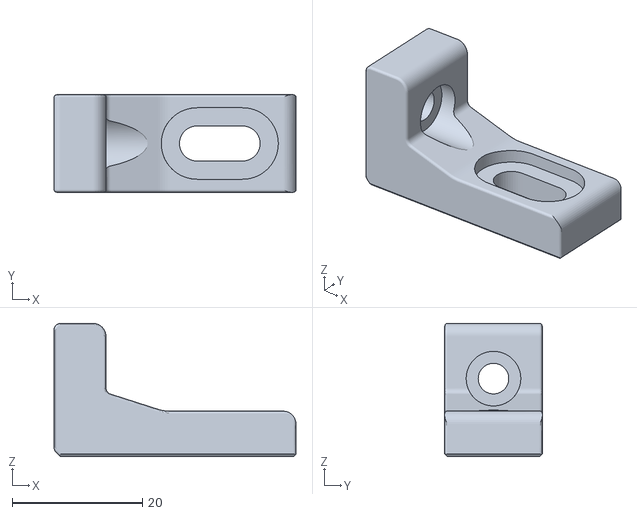
[picture p55: CAD file, 2021-07-27]
printer_mods/Ultrawaffles/Ender_3_to_SW/STLs/Electronics/psu_2060_mount_x2_b.stl
37.2 x 15.0 x 20.5
