Yeriwyn/VoronUsers/printer_mods/Ultrawaffles/Ender_3_to_SW/STLs/Electronics/screen_(ender3_original)_wip/screen_rear.stl

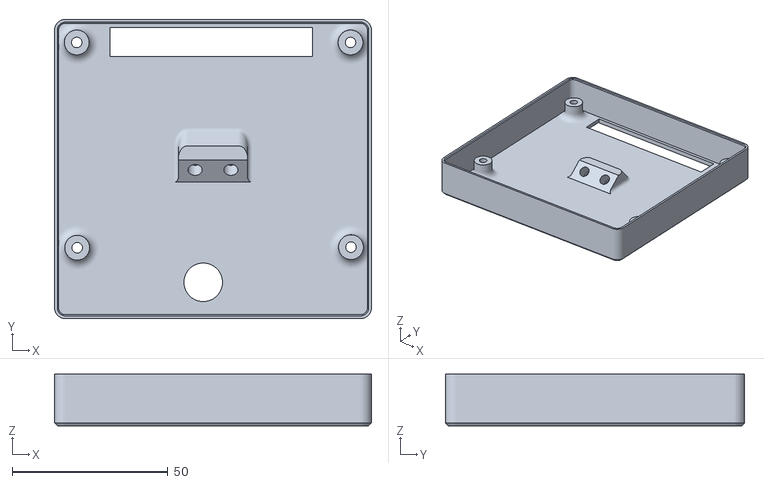
[picture p56: CAD file, 2021-07-27]
printer_mods/Ultrawaffles/Ender_3_to_SW/STLs/Electronics/screen_(ender3_original)_wip/screen_rear.stl
101.9 x 96.2 x 16.7
