Yeriwyn/VoronUsers/printer_mods/Ultrawaffles/Ender_3_to_SW/STLs/Gantry/2040_Alignment_tool_x2.stl

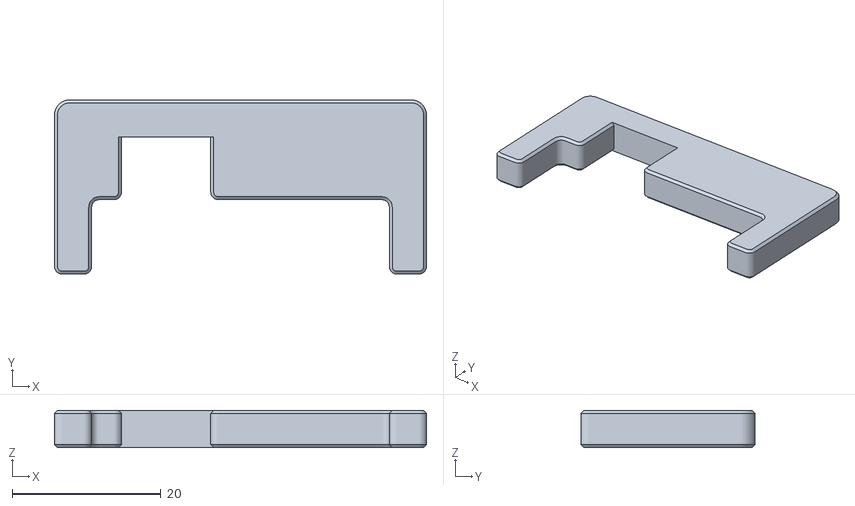
[picture p57: CAD file, 2021-07-27]
printer_mods/Ultrawaffles/Ender_3_to_SW/STLs/Gantry/2040_Alignment_tool_x2.stl
50.0 x 23.4 x 5.00
