Yeriwyn/VoronUsers/printer_mods/Ultrawaffles/Ender_3_to_SW/STLs/Gantry/XZ_axis/[a]_upper_idler_support_b_left.stl

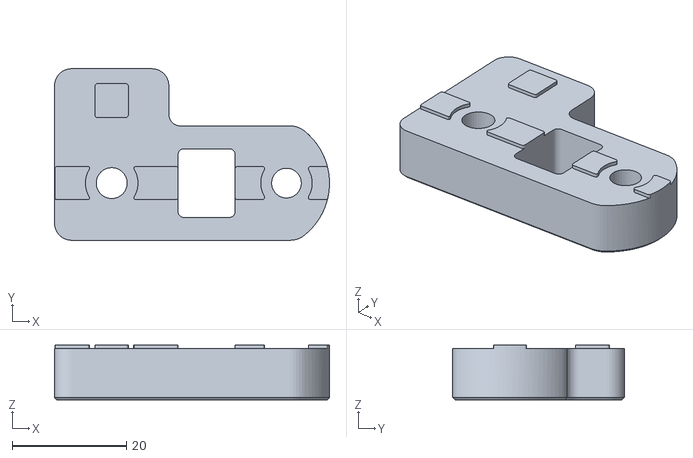
[picture p58: CAD file, 2021-07-27]
printer_mods/Ultrawaffles/Ender_3_to_SW/STLs/Gantry/XZ_axis/[a]_upper_idler_support_b_left.stl
48.1 x 30.0 x 9.60
