Yeriwyn/VoronUsers/printer_mods/Ultrawaffles/Ender_3_to_SW/STLs/Gantry/XZ_axis/x_carriage/x_carriage_frame_right.stl

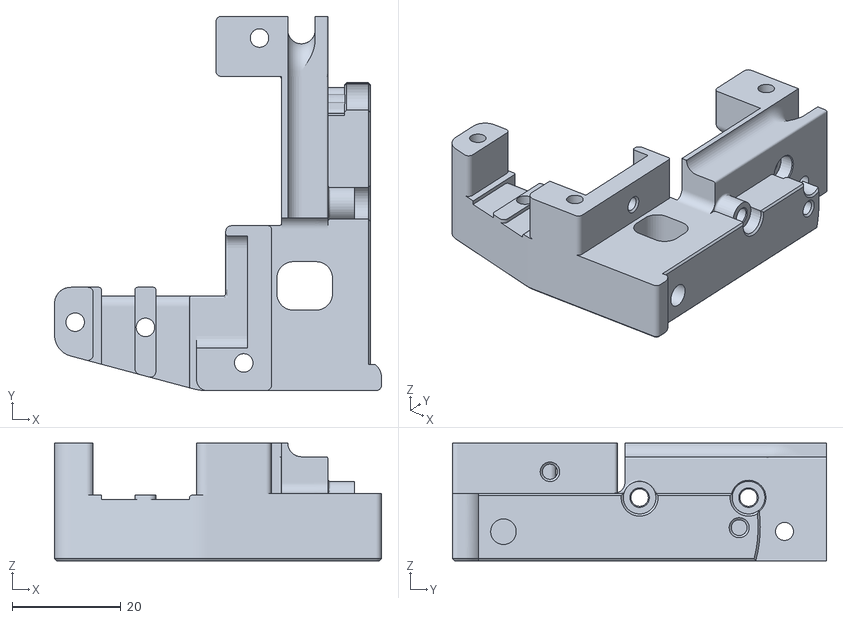
[picture p59: CAD file, 2021-07-27]
printer_mods/Ultrawaffles/Ender_3_to_SW/STLs/Gantry/XZ_axis/x_carriage/x_carriage_frame_right.stl
60.0 x 68.8 x 21.6
