Yeriwyn/VoronUsers/printer_mods/Ultrawaffles/Ender_3_to_SW/STLs/Gantry/Y_axis/[a]_y_chain_frame_mount.stl

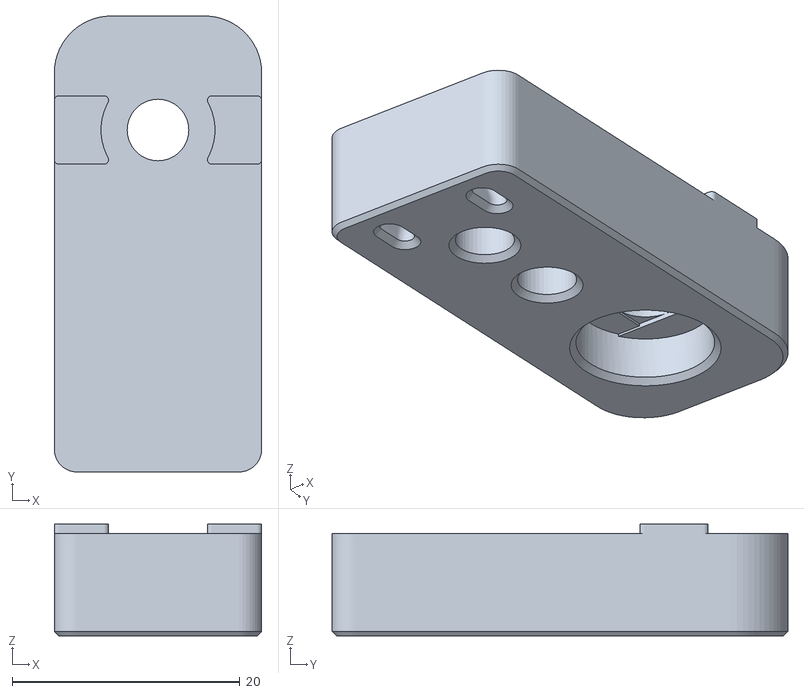
[picture p60: CAD file, 2021-07-27]
printer_mods/Ultrawaffles/Ender_3_to_SW/STLs/Gantry/Y_axis/[a]_y_chain_frame_mount.stl
18.2 x 40.0 x 9.80
