Yeriwyn/VoronUsers/printer_mods/Ultrawaffles/Ender_3_to_SW/STLs/Grill/grill_front_middle.stl

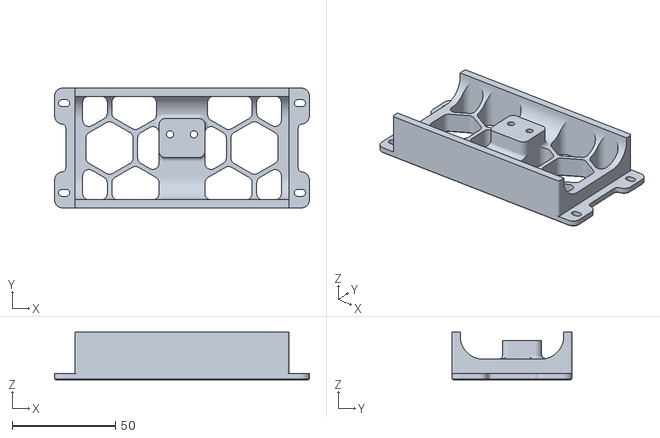
[picture p61: CAD file, 2021-07-27]
printer_mods/Ultrawaffles/Ender_3_to_SW/STLs/Grill/grill_front_middle.stl
123.2 x 58.0 x 23.0
