Yeriwyn/VoronUsers/printer_mods/Ultrawaffles/Ender_3_to_SW/STLs/Panel_Mounting/panel_clip_x10.stl

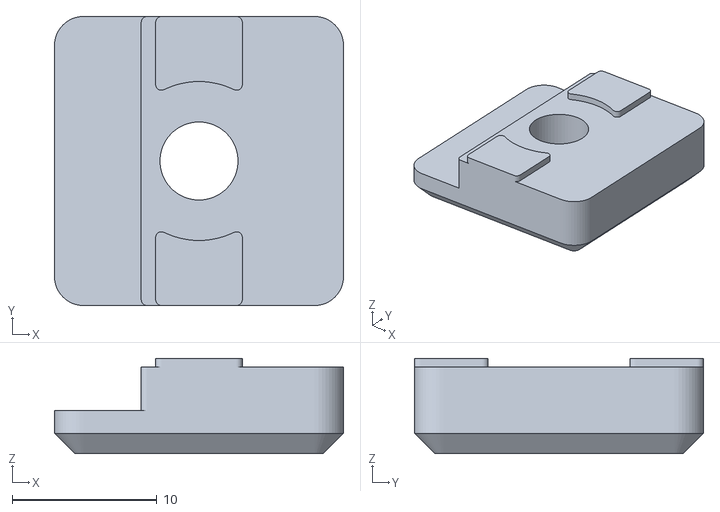
[picture p62: CAD file, 2021-07-27]
printer_mods/Ultrawaffles/Ender_3_to_SW/STLs/Panel_Mounting/panel_clip_x10.stl
20.0 x 20.0 x 6.60
