Yeriwyn/VoronUsers/printer_mods/Ultrawaffles/Ender_3_to_SW/STLs/TPU_FEET_x4.stl

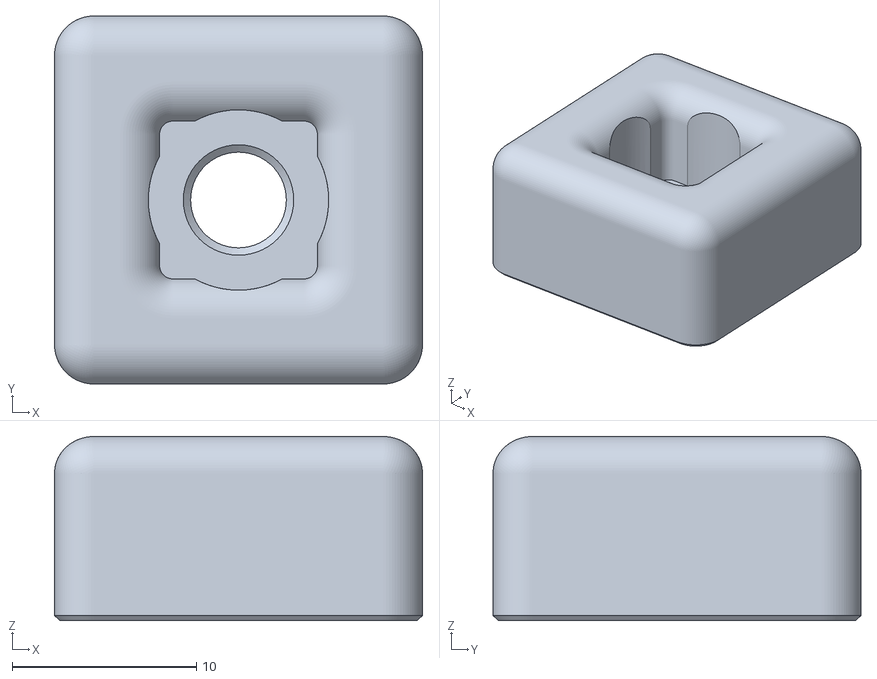
[picture p63: CAD file, 2021-07-27]
printer_mods/Ultrawaffles/Ender_3_to_SW/STLs/TPU_FEET_x4.stl
20.0 x 20.0 x 10.0
