Yeriwyn/VoronUsers/printer_mods/wile-e1/Deck_Panel_Support_Clips/wile.e-deck_panel_support_lower_4mm.stp

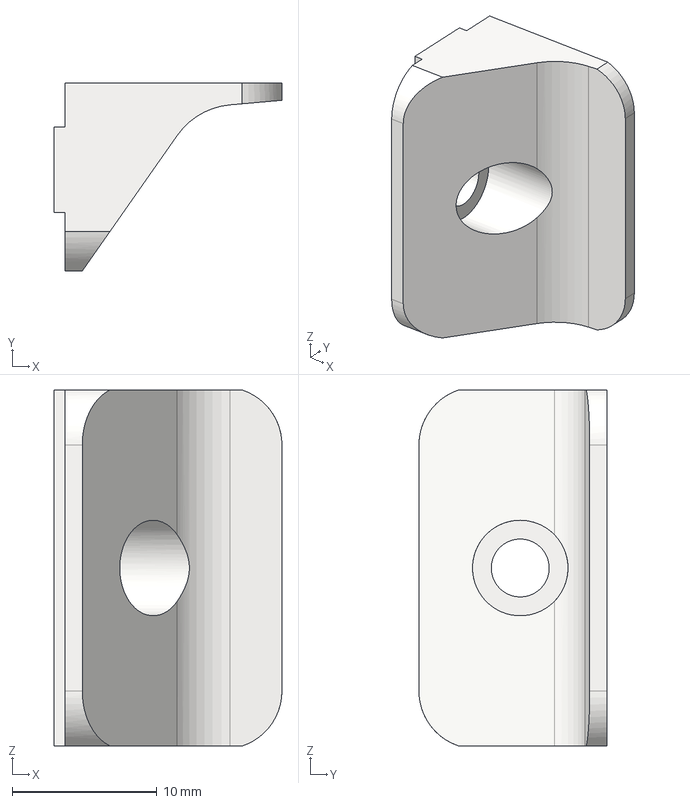
[picture p64: CAD file, 2021-06-30]
printer_mods/wile-e1/Deck_Panel_Support_Clips/wile.e-deck_panel_support_lower_4mm.stp
15.8 x 13.0 x 24.6 mm
