Yeriwyn/VoronUsers/printer_mods/wrez/astrodyne-inlet/CAD/power-inlet-astrodyne.step

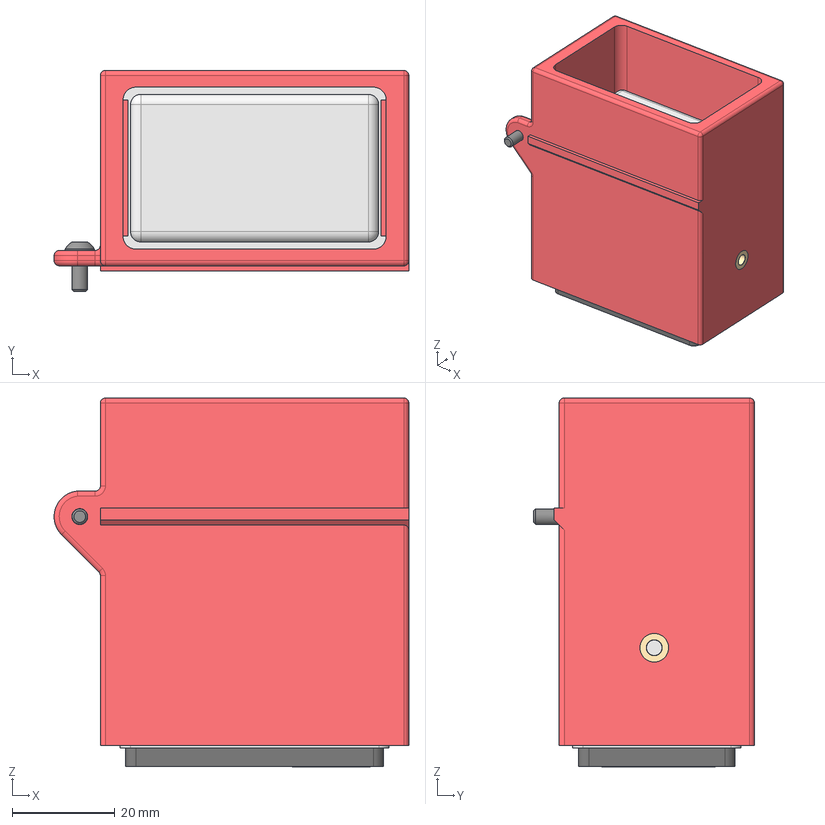
[picture p65: CAD file, 2021-06-30]
printer_mods/wrez/astrodyne-inlet/CAD/power-inlet-astrodyne.step
69.0 x 43.0 x 71.8 mm
case
M3 Threaded Insert.step (1)
M3x8 BHCS-1.step (1)
