Yeriwyn/VoronUsers/printer_mods/wrez/astrodyne-inlet/STLs/astrodyne-inlet.stl

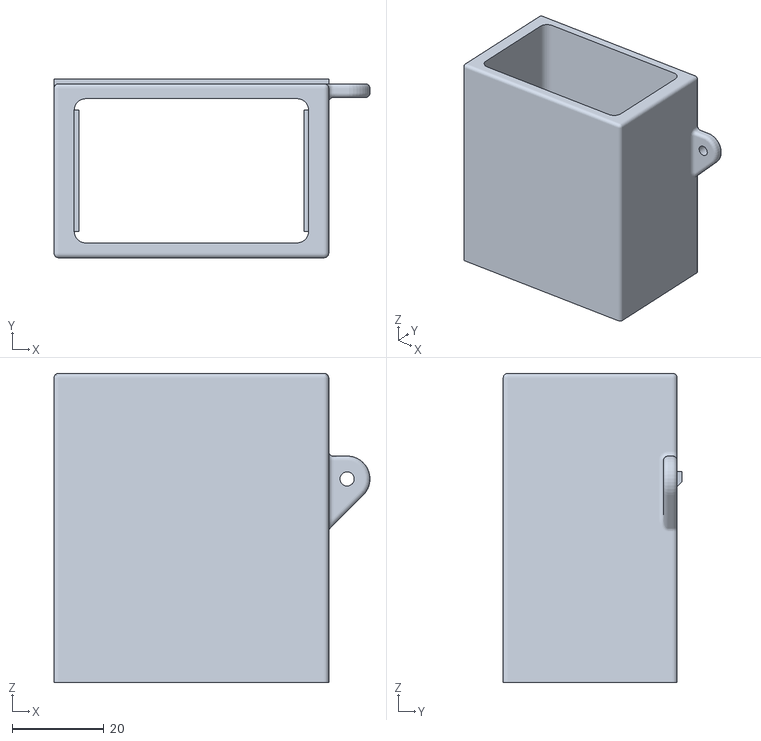
[picture p66: CAD file, 2021-06-30]
printer_mods/wrez/astrodyne-inlet/STLs/astrodyne-inlet.stl
69.0 x 39.0 x 67.6
