Yeriwyn/VoronUsers/printer_mods/yeri/V0_Magnetic_Panels/Mounting_Plate_v2.stl

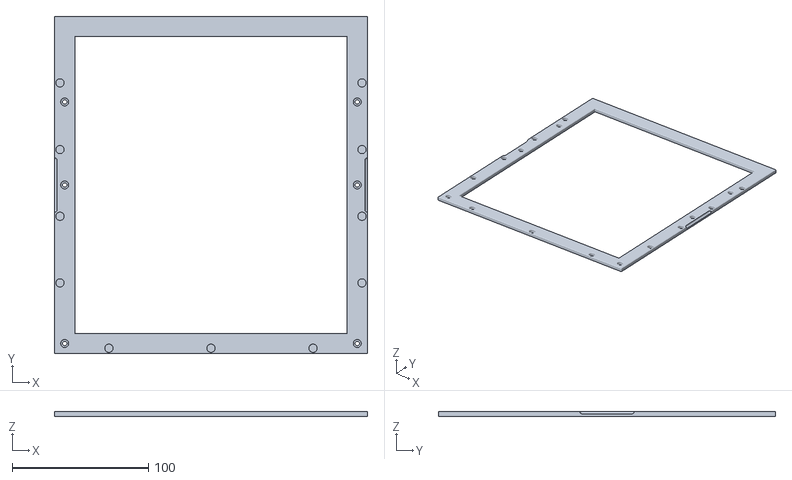
[picture p67: CAD file, 2021-06-30]
printer_mods/yeri/V0_Magnetic_Panels/Mounting_Plate_v2.stl
230.0 x 248.0 x 4.00
