Yeriwyn/VoronUsers/printer_mods/yeri/V0_Magnetic_Panels/STL/Split/Plate_Horizontal_Middle_x5.stl

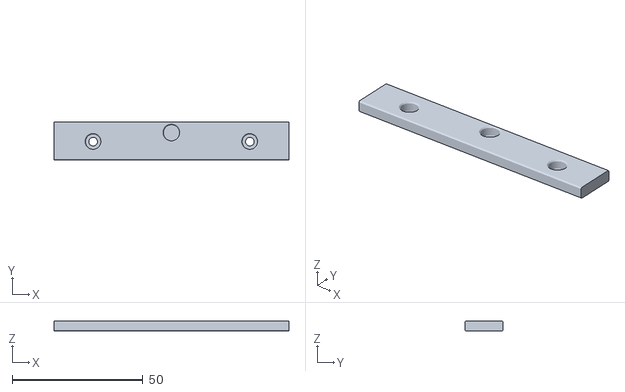
[picture p68: CAD file, 2021-05-28]
printer_mods/yeri/V0_Magnetic_Panels/STL/Split/Plate_Horizontal_Middle_x5.stl
90.0 x 14.5 x 4.00
