Yeriwyn/VoronUsers/printer_mods/yeri/V1_V2_Magnetic_Panels/STL/V1/300/Side_Panel/Top_Right_and_Bottom_Left_x2_Side_Panel.stl

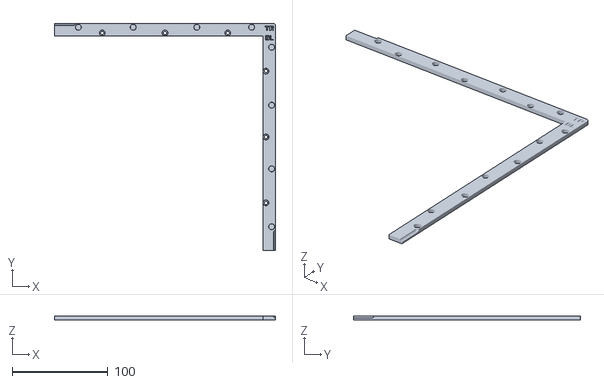
[picture p69: CAD file, 2021-06-30]
printer_mods/yeri/V1_V2_Magnetic_Panels/STL/V1/300/Side_Panel/Top_Right_and_Bottom_Left_x2_Side_Panel.stl
231.4 x 238.0 x 4.00
