Yeriwyn/VoronUsers/printer_mods/yeri/V1_V2_Magnetic_Panels/STL/V1/300/Top_Panel/Top_Right_and_Bottom_Left_x2.stl

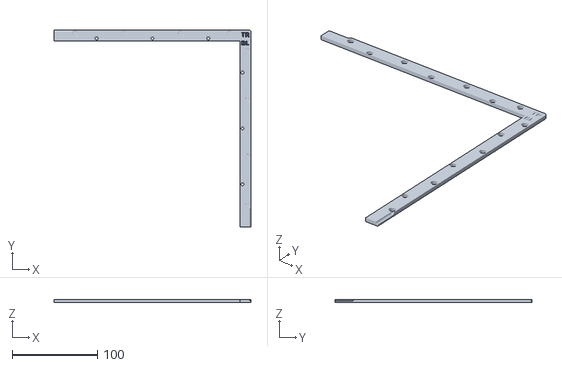
[picture p70: CAD file, 2021-06-30]
printer_mods/yeri/V1_V2_Magnetic_Panels/STL/V1/300/Top_Panel/Top_Right_and_Bottom_Left_x2.stl
231.4 x 231.4 x 4.00
