Yeriwyn/VoronUsers/printer_mods/yeri/V1_V2_Magnetic_Panels/STL/V1/300/Top_Panel_for_Handle_Mod/Panel_Top_Left_and_Bottom_Right_x2.stl

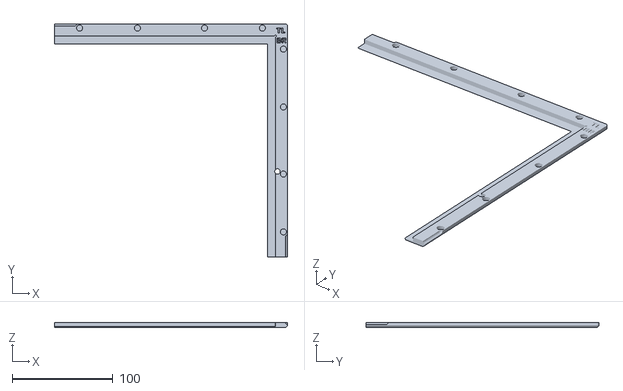
[picture p71: CAD file, 2021-06-30]
printer_mods/yeri/V1_V2_Magnetic_Panels/STL/V1/300/Top_Panel_for_Handle_Mod/Panel_Top_Left_and_Bottom_Right_x2.stl
231.4 x 231.4 x 5.00
