Yeriwyn/VoronUsers/printer_mods/Andre/Mini_Afterburner_Strain_Relief/STL/Strain_Relief_Body_x1.stl

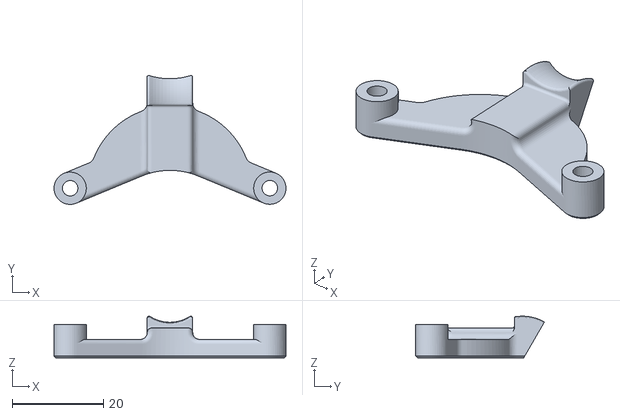
[picture p72: CAD file, 2021-06-30]
printer_mods/Andre/Mini_Afterburner_Strain_Relief/STL/Strain_Relief_Body_x1.stl
50.9 x 28.3 x 9.15
