Yeriwyn/VoronUsers/printer_mods/Andre/V0_Neopixel_Front_Bed_Mount/STL/Diffuser_x1.stl

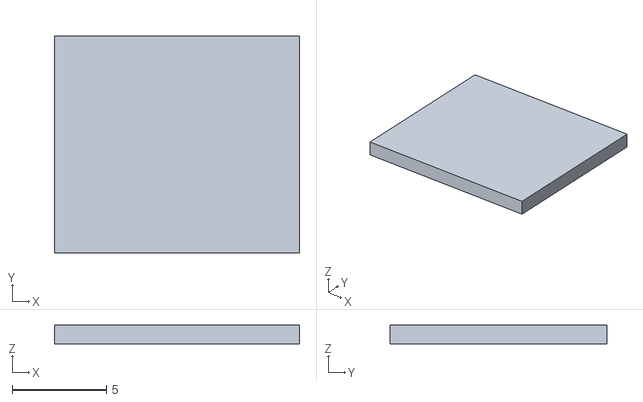
[picture p73: CAD file, 2021-06-30]
printer_mods/Andre/V0_Neopixel_Front_Bed_Mount/STL/Diffuser_x1.stl
13.0 x 11.5 x 1.00
