Yeriwyn/VoronUsers/printer_mods/DaGlo/Voron_V0_Duet_2_WiFi_Mounting_Brackets/Duet2Wifi_Mounting_Bracket.stl

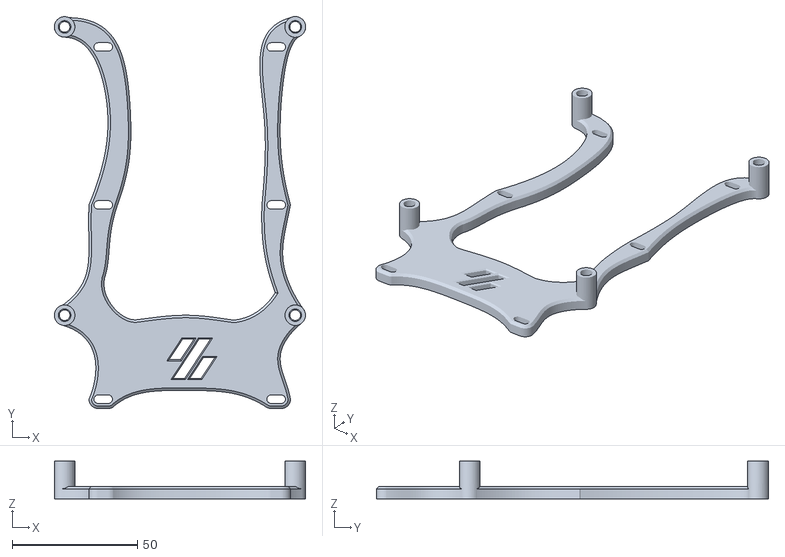
[picture p74: CAD file, 2021-06-30]
printer_mods/DaGlo/Voron_V0_Duet_2_WiFi_Mounting_Brackets/Duet2Wifi_Mounting_Bracket.stl
100.2 x 156.4 x 15.0
