Yeriwyn/VoronUsers/printer_mods/DoubleT/afterburner_triple_bowden/STLs/Bowden_Triple_Adapter_generic.stl

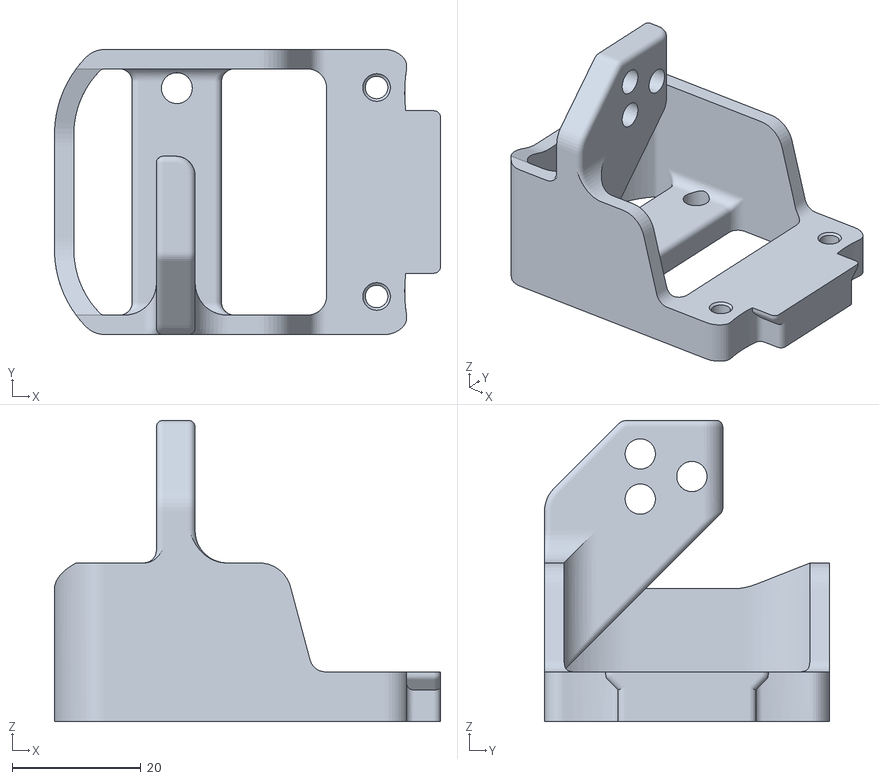
[picture p75: CAD file, 2021-06-30]
printer_mods/DoubleT/afterburner_triple_bowden/STLs/Bowden_Triple_Adapter_generic.stl
59.9 x 44.2 x 46.7
