Yeriwyn/VoronUsers/printer_mods/DoubleT/switchwire_tft_display/STLs/Display_Body.stl

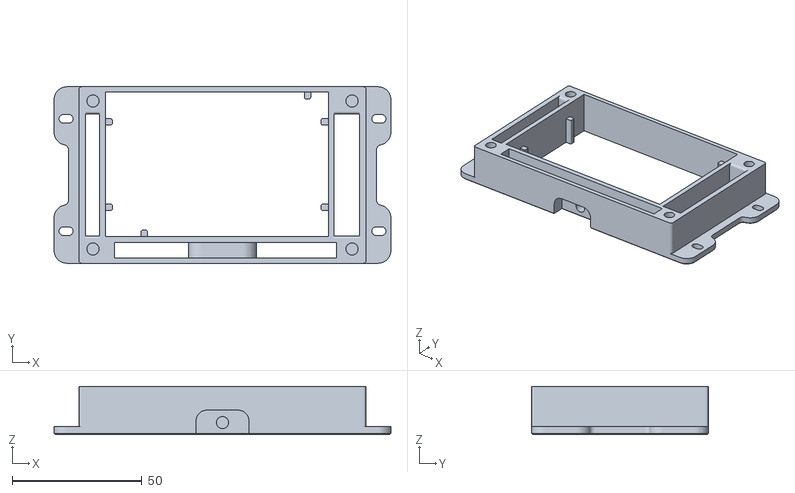
[picture p76: CAD file, 2021-06-30]
printer_mods/DoubleT/switchwire_tft_display/STLs/Display_Body.stl
129.8 x 68.0 x 18.5
