Yeriwyn/VoronUsers/printer_mods/hartk1213/Voron0_MGN9C_X_Axis/STLs/MGN9_1515_rail_guide_x2.stl

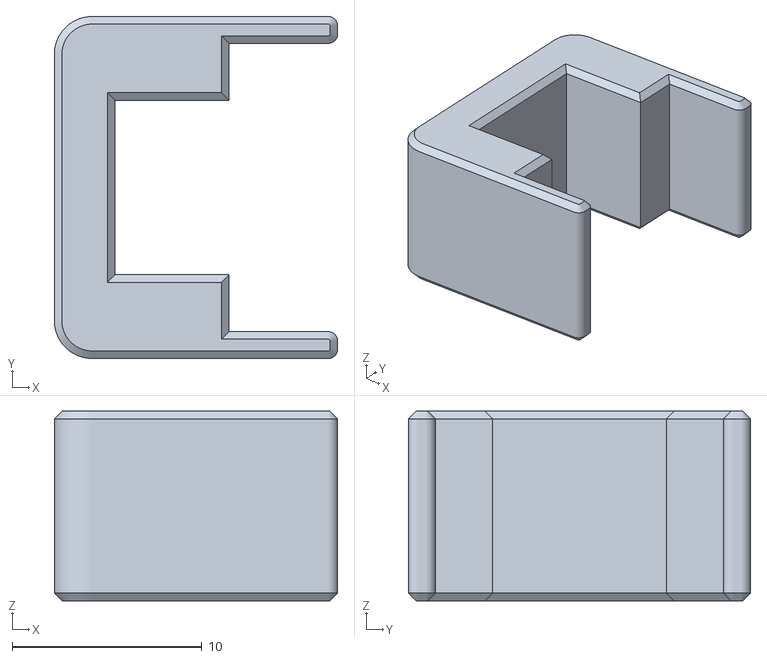
[picture p77: CAD file, 2021-06-30]
printer_mods/hartk1213/Voron0_MGN9C_X_Axis/STLs/MGN9_1515_rail_guide_x2.stl
14.9 x 18.0 x 10.0
