Yeriwyn/VoronUsers/printer_mods/JosAr/Klicky-Probe/STL/KlickyProbe_Dock_Side_Mount_Fixed_pt2.stl

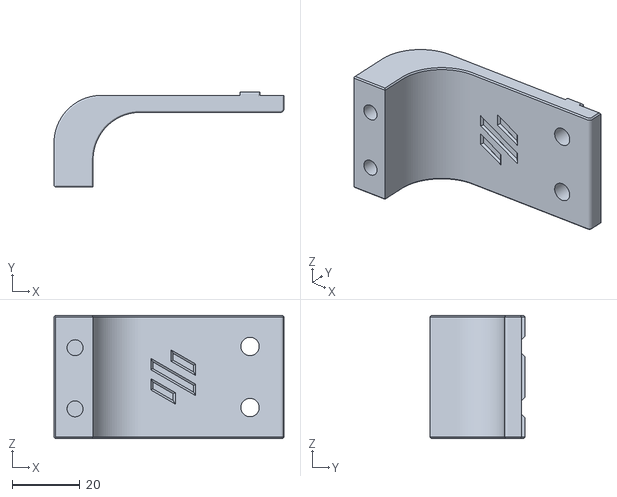
[picture p78: CAD file, 2021-06-30]
printer_mods/JosAr/Klicky-Probe/STL/KlickyProbe_Dock_Side_Mount_Fixed_pt2.stl
67.7 x 28.0 x 36.3
