Yeriwyn/VoronUsers/printer_mods/JosAr/Klicky-Probe/Usermods/oc_geek/Robust_AB_mount.stl

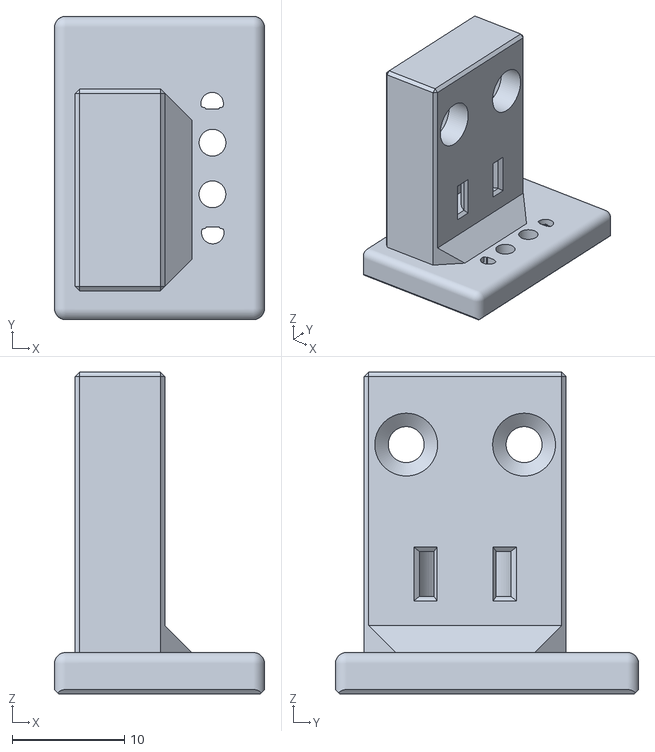
[picture p79: CAD file, 2021-06-30]
printer_mods/JosAr/Klicky-Probe/Usermods/oc_geek/Robust_AB_mount.stl
18.7 x 27.0 x 28.7
