Yeriwyn/VoronUsers/printer_mods/Majarspeed/Hartk_Mount_Galileo/Hartk_board_mount_galileo.stl

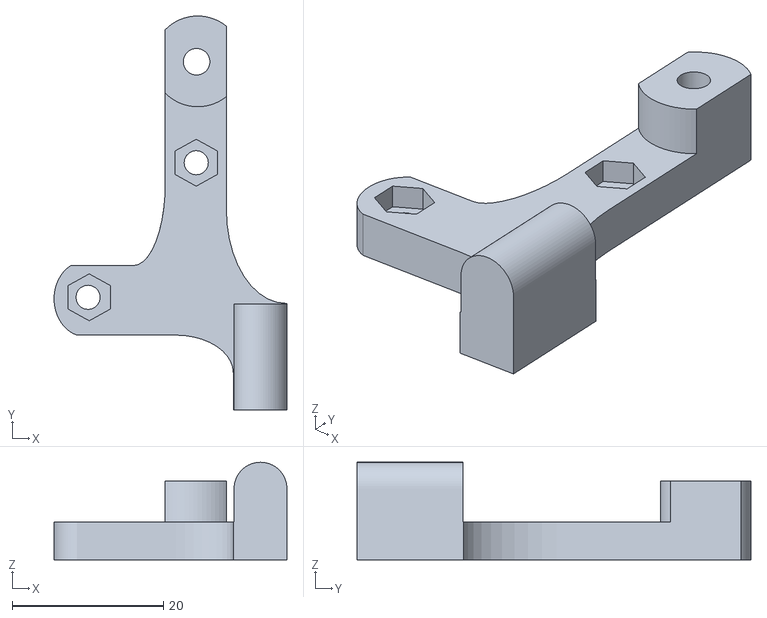
[picture p81: CAD file, 2021-06-30]
printer_mods/Majarspeed/Hartk_Mount_Galileo/Hartk_board_mount_galileo.stl
30.8 x 52.1 x 12.9
