Yeriwyn/VoronUsers/printer_mods/MathematicalPotato/v0.1_belted_z_drive/STL/V0-ZBelt-Pancake-Stepper-Bracket.stl

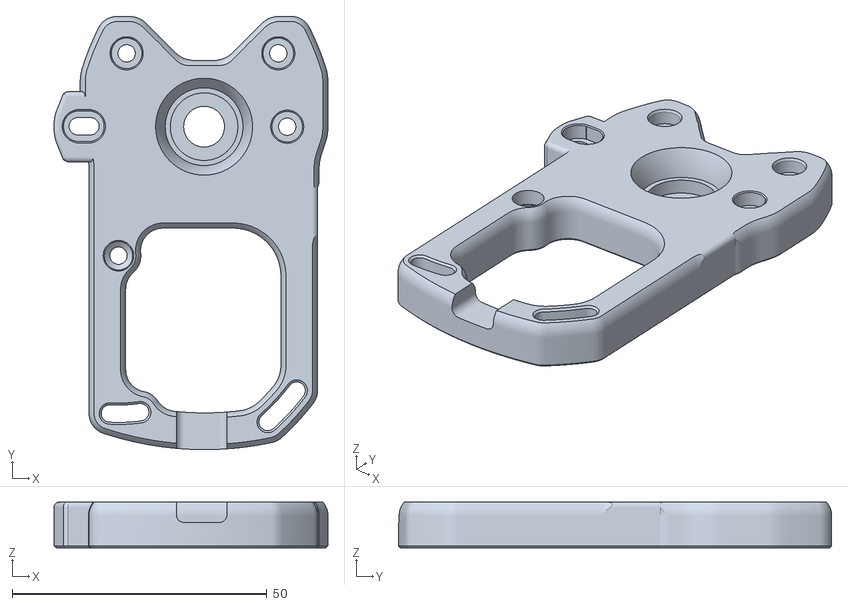
[picture p82: CAD file, 2021-06-30]
printer_mods/MathematicalPotato/v0.1_belted_z_drive/STL/V0-ZBelt-Pancake-Stepper-Bracket.stl
53.7 x 85.0 x 9.00
