Yeriwyn/VoronUsers/printer_mods/Phalanx/Other-V2-Idlers/STL/Front_Idler_Bottomx2.stl

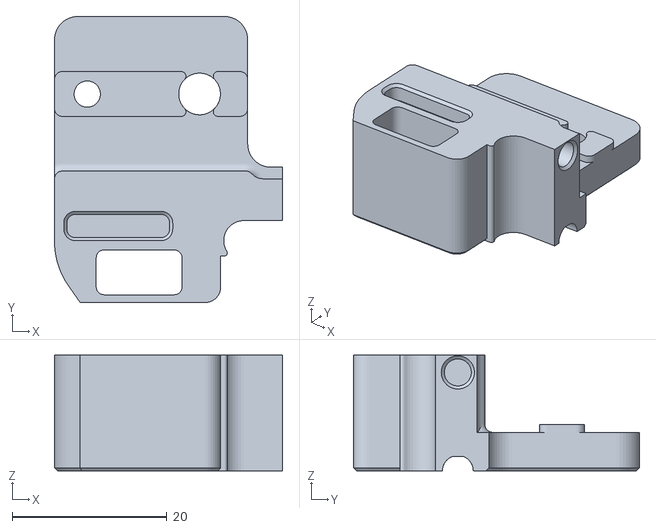
[picture p83: CAD file, 2021-07-27]
printer_mods/Phalanx/Other-V2-Idlers/STL/Front_Idler_Bottomx2.stl
29.5 x 37.0 x 15.0
