Yeriwyn/VoronUsers/printer_mods/Printopal/Magnetic_top_panel/STEP/250_top_skirt_220.stp

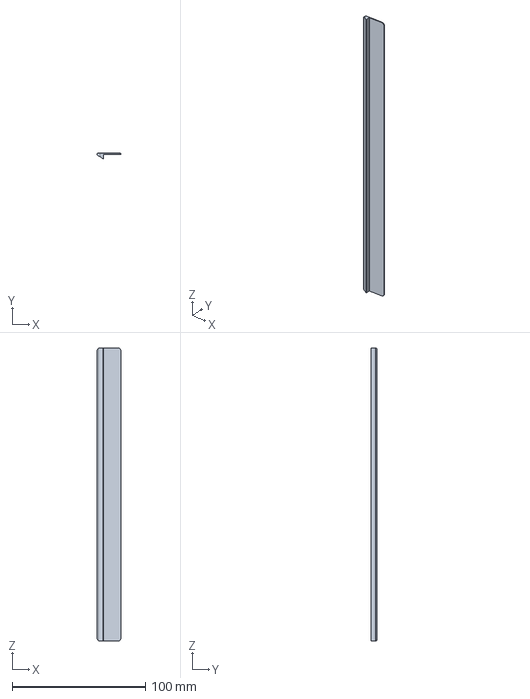
[picture p84: CAD file, 2021-07-27]
printer_mods/Printopal/Magnetic_top_panel/STEP/250_top_skirt_220.stp
17.8 x 4.40 x 220.0 mm
