Yeriwyn/VoronUsers/printer_mods/revnull/rpi_7in_display_mount/STL/voron_2.4_7in_pi_base.stl

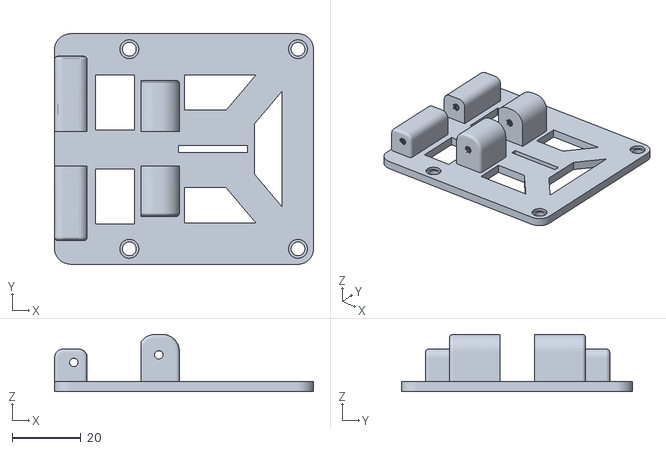
[picture p85: CAD file, 2021-07-27]
printer_mods/revnull/rpi_7in_display_mount/STL/voron_2.4_7in_pi_base.stl
75.2 x 67.0 x 16.7
