Yeriwyn/VoronUsers/printer_mods/rsheng118/BTT_octopus_DIN_vertical_mount/STEP/BTT_octopus_DIN_mount_B.stp

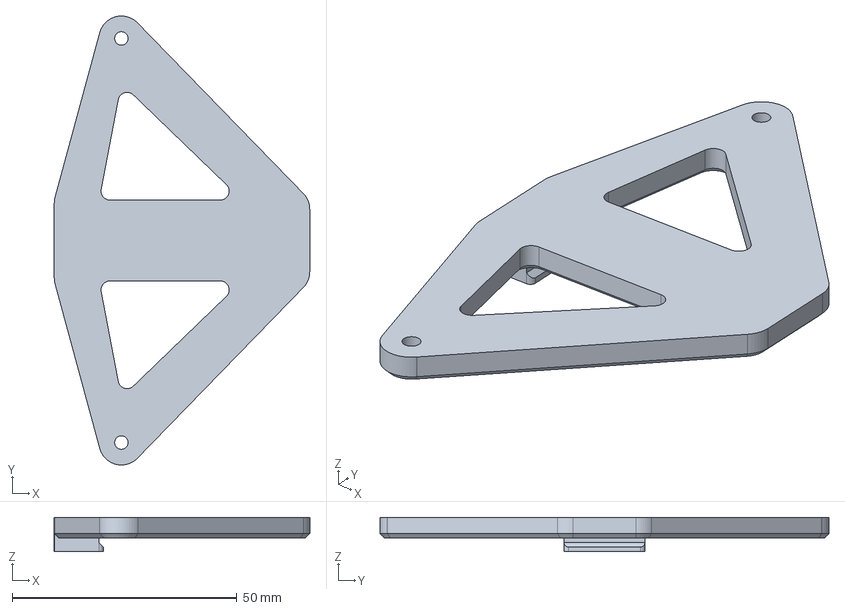
[picture p86: CAD file, 2021-07-27]
printer_mods/rsheng118/BTT_octopus_DIN_vertical_mount/STEP/BTT_octopus_DIN_mount_B.stp
56.9 x 100.0 x 7.60 mm
