Yeriwyn/VoronUsers/printer_mods/Shteeeeeve/V01-LED-Tophat/STLs/LED-Tophat-Logo-Insert.stl

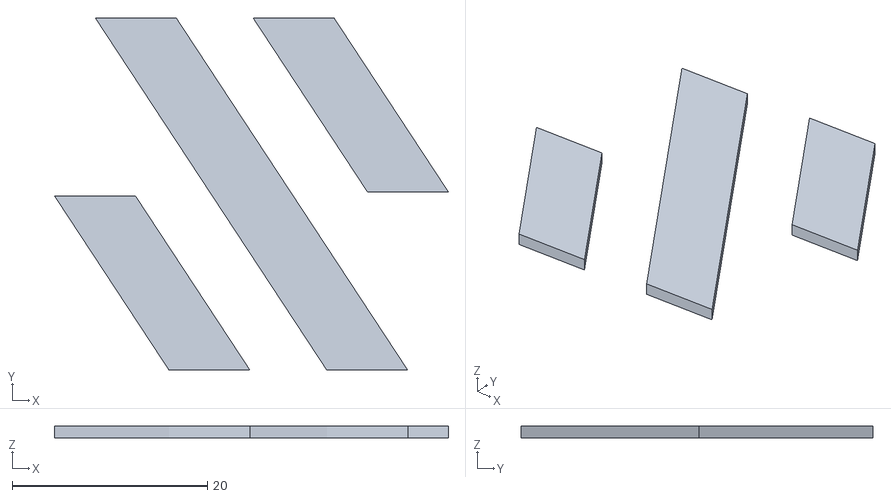
[picture p87: CAD file, 2021-07-27]
printer_mods/Shteeeeeve/V01-LED-Tophat/STLs/LED-Tophat-Logo-Insert.stl
40.4 x 36.1 x 1.20
