Yeriwyn/VoronUsers/printer_mods/Triano/Ender_3Pro_Switchwire/STL/Deck/deck_rear_left.stl

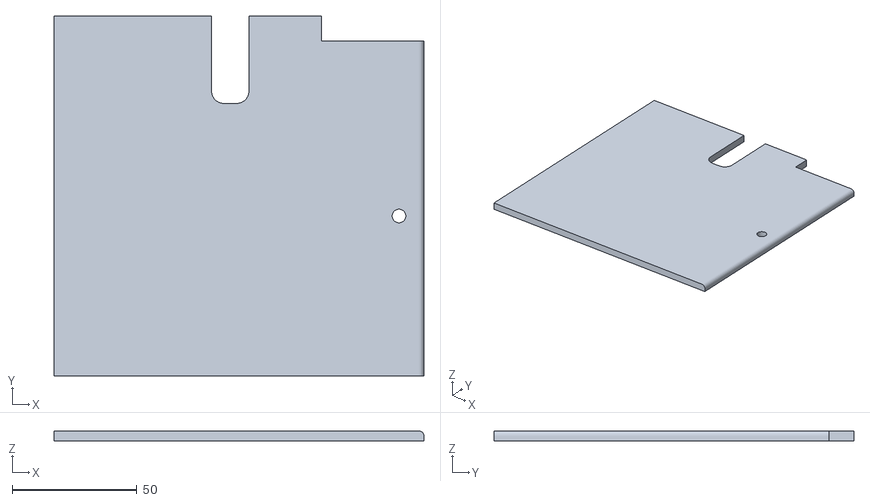
[picture p88: CAD file, 2021-06-30]
printer_mods/Triano/Ender_3Pro_Switchwire/STL/Deck/deck_rear_left.stl
148.0 x 144.0 x 4.00
