Yeriwyn/VoronUsers/printer_mods/Triano/Ender_3Pro_Switchwire/STL/Electronics/[a]_rpi3_shelf.stl

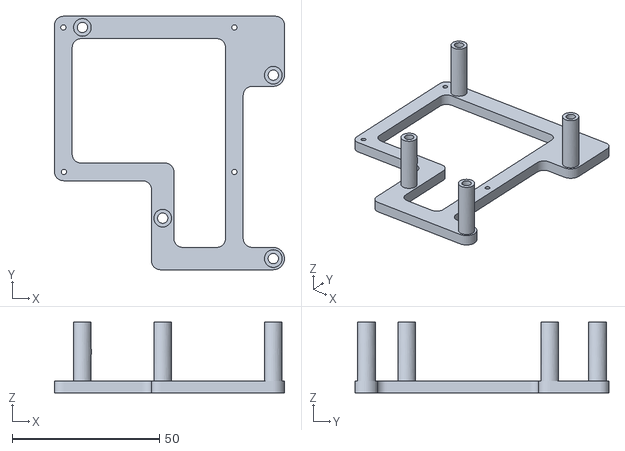
[picture p89: CAD file, 2021-06-30]
printer_mods/Triano/Ender_3Pro_Switchwire/STL/Electronics/[a]_rpi3_shelf.stl
78.0 x 86.0 x 24.0
