Yeriwyn/VoronUsers/printer_mods/Triano/Ender_3Pro_Switchwire/STL/XZ-Axis/z_bearing_block_right_generic.stl

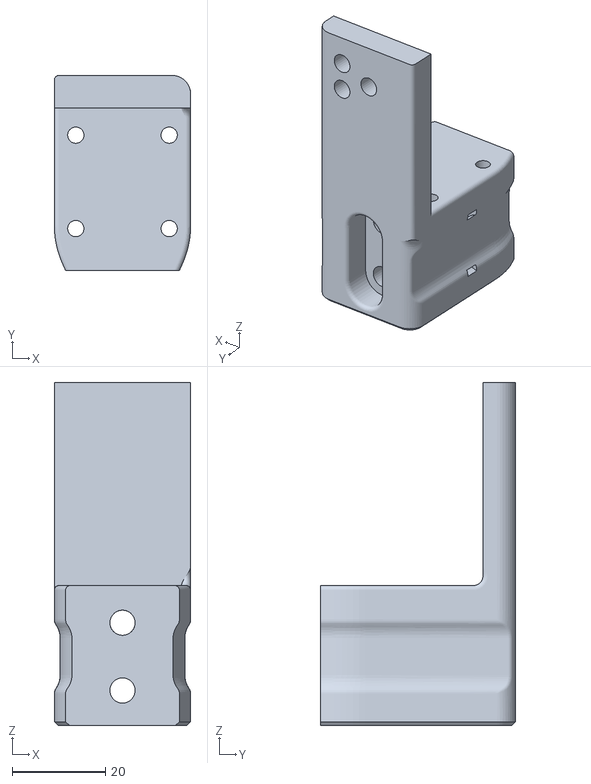
[picture p91: CAD file, 2021-06-30]
printer_mods/Triano/Ender_3Pro_Switchwire/STL/XZ-Axis/z_bearing_block_right_generic.stl
29.2 x 41.8 x 73.4
