Yeriwyn/VoronUsers/printer_mods/Triano/Ender_3Pro_Switchwire/STL/Y-Axis/[a]_y_front_belt_slider.stl

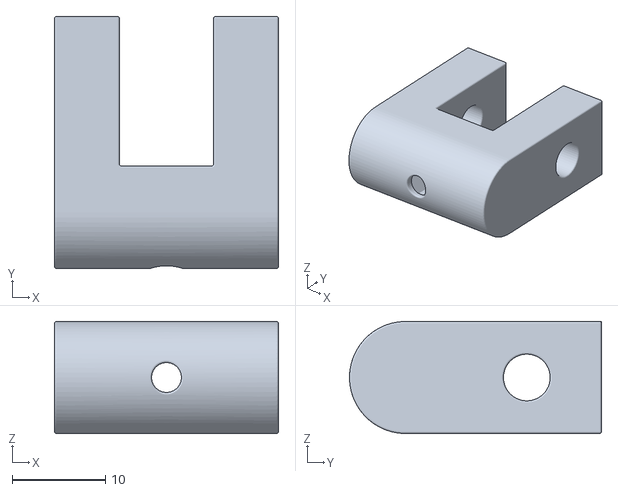
[picture p92: CAD file, 2021-06-30]
printer_mods/Triano/Ender_3Pro_Switchwire/STL/Y-Axis/[a]_y_front_belt_slider.stl
24.0 x 27.0 x 12.0
