Yeriwyn/VoronUsers/printer_mods/Ultrawaffles/Ender_3_to_SW/DXF/top_panel.dxf

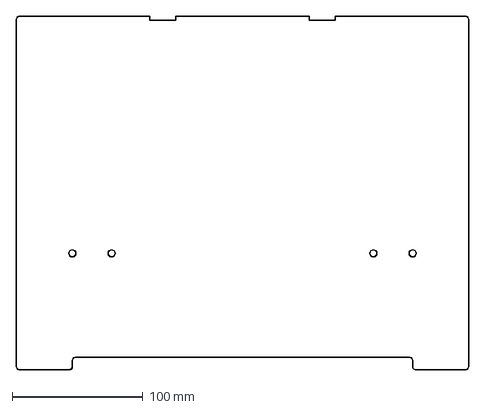
[picture p93: CAD file, 2021-07-27]
printer_mods/Ultrawaffles/Ender_3_to_SW/DXF/top_panel.dxf
346.0 x 270.0 mm
