Yeriwyn/VoronUsers/printer_mods/Ultrawaffles/Ender_3_to_SW/STLs/Electronics/psu_2060_mount_x2_a.stl

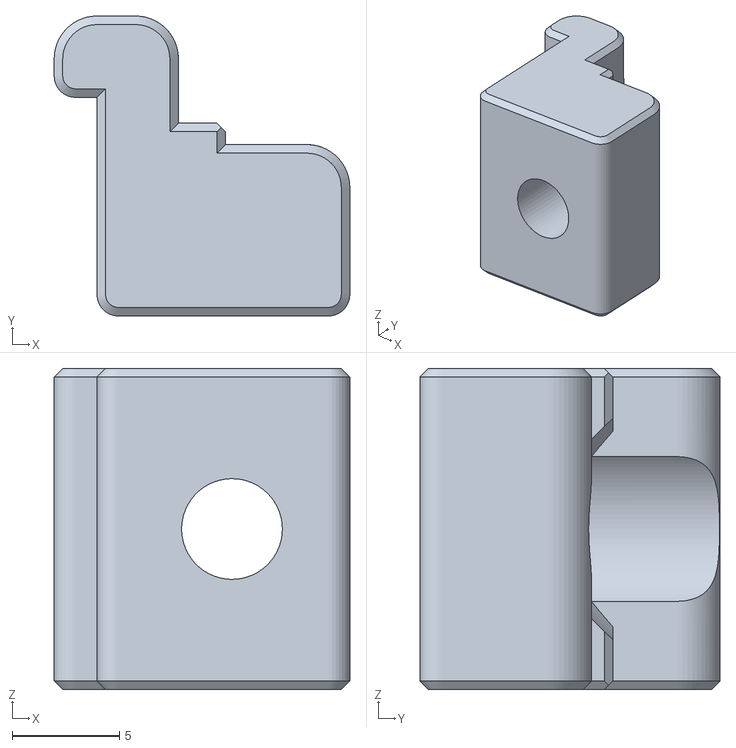
[picture p94: CAD file, 2021-07-27]
printer_mods/Ultrawaffles/Ender_3_to_SW/STLs/Electronics/psu_2060_mount_x2_a.stl
13.8 x 14.0 x 15.0
