Yeriwyn/VoronUsers/printer_mods/Ultrawaffles/Ender_3_to_SW/STLs/Electronics/screen_(ender3_original)_wip/peg.stl

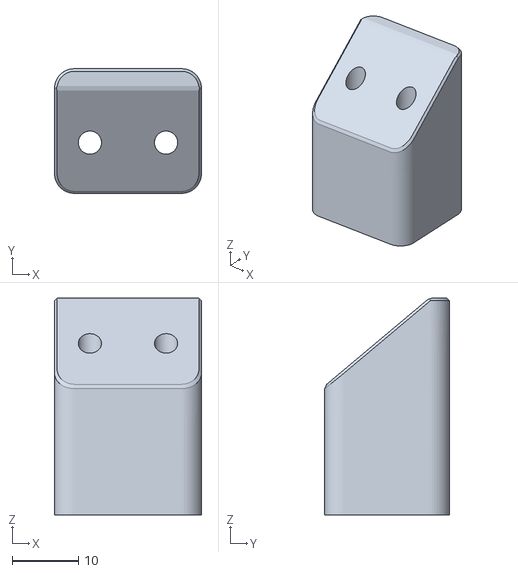
[picture p95: CAD file, 2021-07-27]
printer_mods/Ultrawaffles/Ender_3_to_SW/STLs/Electronics/screen_(ender3_original)_wip/peg.stl
22.2 x 18.8 x 32.8
