Yeriwyn/VoronUsers/printer_mods/Ultrawaffles/Ender_3_to_SW/STLs/Gantry/XZ_axis/xz_block_right_a.stl

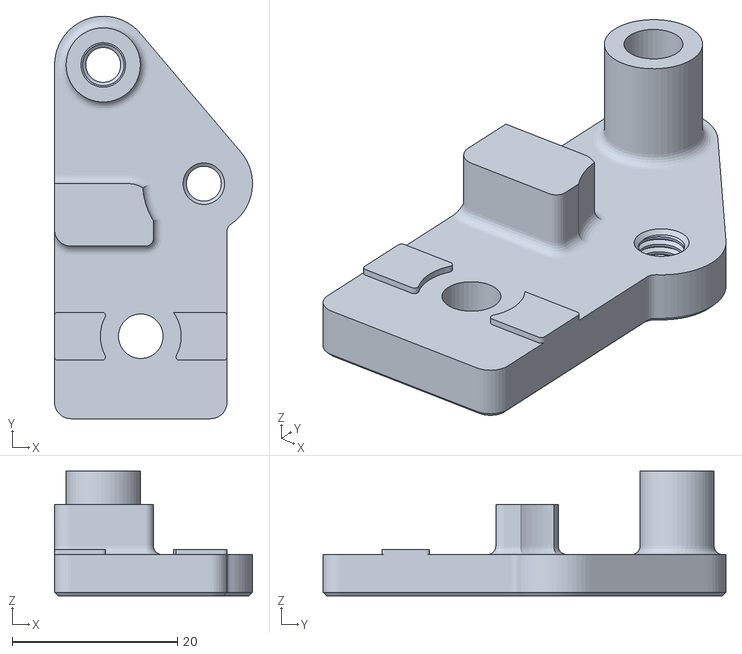
[picture p96: CAD file, 2021-07-27]
printer_mods/Ultrawaffles/Ender_3_to_SW/STLs/Gantry/XZ_axis/xz_block_right_a.stl
24.0 x 48.8 x 15.1
