Yeriwyn/VoronUsers/printer_mods/Ultrawaffles/Ender_3_to_SW/STLs/Gantry/Y_axis/bed_mount.stl

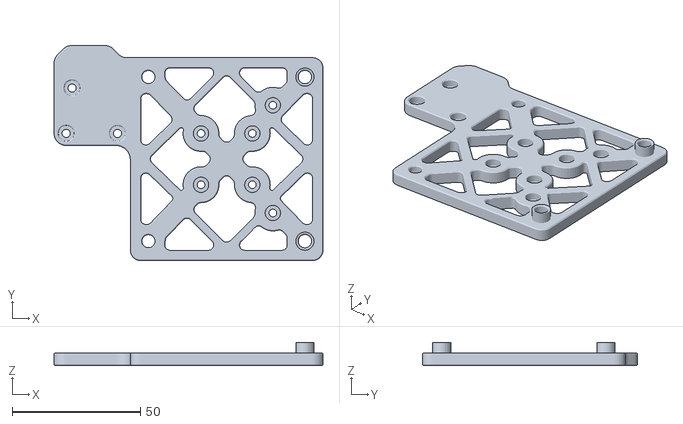
[picture p97: CAD file, 2021-07-27]
printer_mods/Ultrawaffles/Ender_3_to_SW/STLs/Gantry/Y_axis/bed_mount.stl
104.9 x 83.9 x 9.10
