Yeriwyn/VoronUsers/printer_mods/Ultrawaffles/Ender_3_to_SW/STLs/Grill/grill_front_left.stl

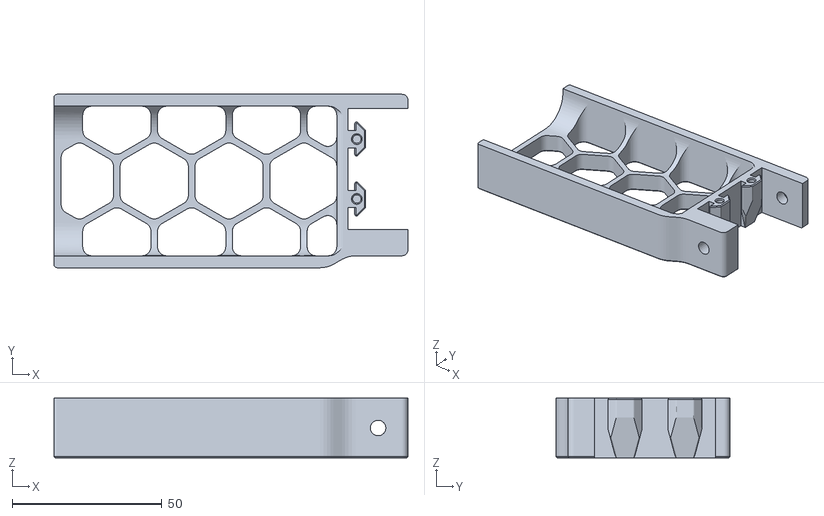
[picture p98: CAD file, 2021-07-27]
printer_mods/Ultrawaffles/Ender_3_to_SW/STLs/Grill/grill_front_left.stl
118.3 x 58.0 x 20.0
