Yeriwyn/VoronUsers/printer_mods/wile-e1/Deck_Panel_Support_Clips/wile.e-deck_panel_support_upper.stp

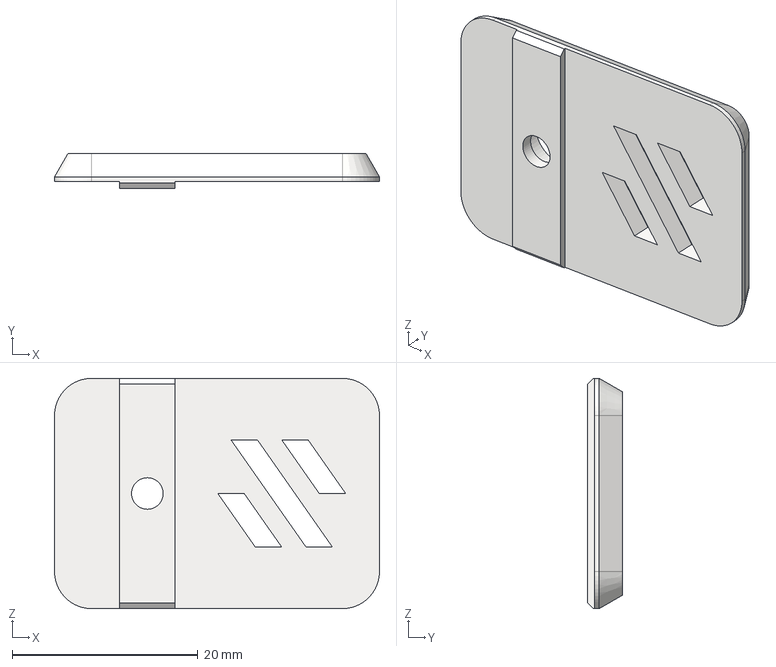
[picture p99: CAD file, 2021-06-30]
printer_mods/wile-e1/Deck_Panel_Support_Clips/wile.e-deck_panel_support_upper.stp
35.0 x 3.75 x 24.8 mm
