Yeriwyn/VoronUsers/printer_mods/yeri/V0_Magnetic_Panels/Side_Panel_Mount.stl

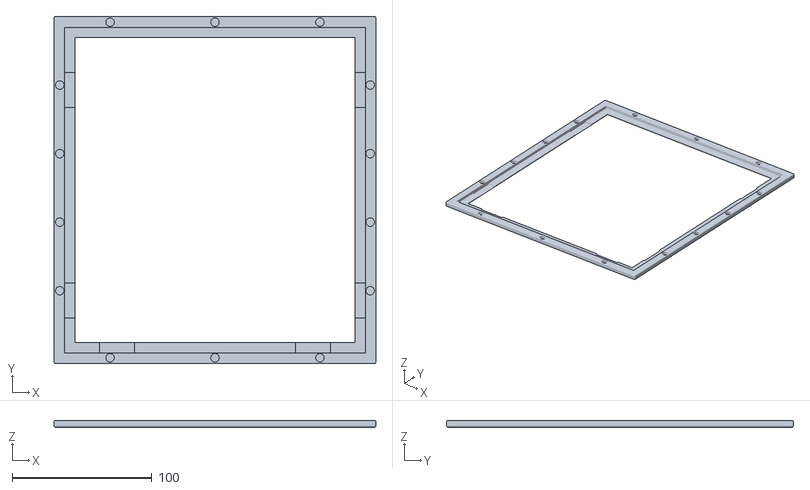
[picture p100: CAD file, 2021-06-30]
printer_mods/yeri/V0_Magnetic_Panels/Side_Panel_Mount.stl
230.0 x 248.0 x 5.00
