Yeriwyn/VoronUsers/printer_mods/yeri/V0_Magnetic_Panels/STL/One_Piece/Front Panel Mount.stl

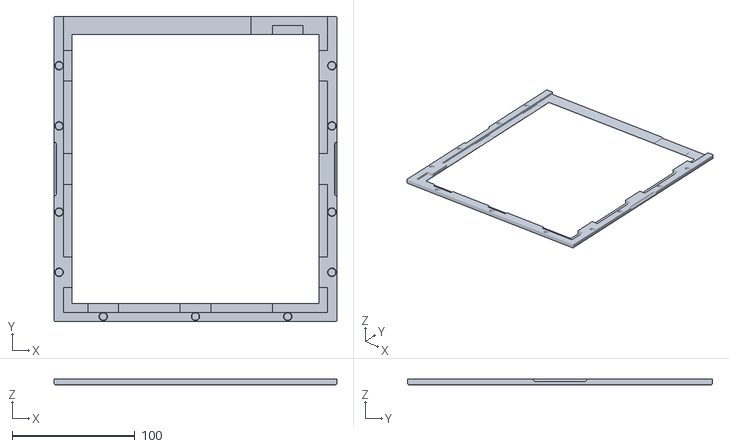
[picture p101: CAD file, 2021-05-28]
printer_mods/yeri/V0_Magnetic_Panels/STL/One_Piece/Front Panel Mount.stl
230.0 x 248.0 x 5.00
