Yeriwyn/VoronUsers/printer_mods/yeri/V0_Magnetic_Panels/STL/Split/Mount_Horizontal_Middle_x5.stl

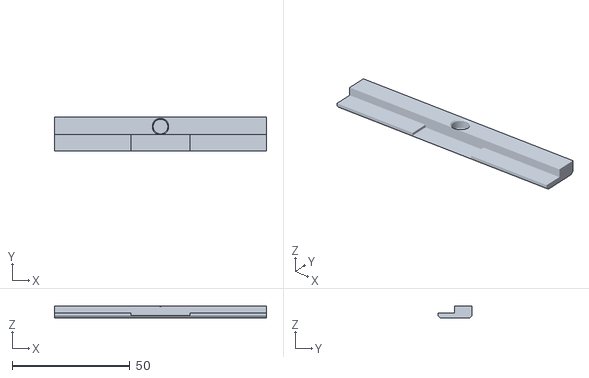
[picture p102: CAD file, 2021-05-28]
printer_mods/yeri/V0_Magnetic_Panels/STL/Split/Mount_Horizontal_Middle_x5.stl
90.0 x 14.5 x 5.00
