Yeriwyn/VoronUsers/printer_mods/yeri/V1_V2_Magnetic_Panels/STL/V1/300/Side_Panel/Panel_Top_Left_and_Bottom_Right_x2_Side_Panel.stl

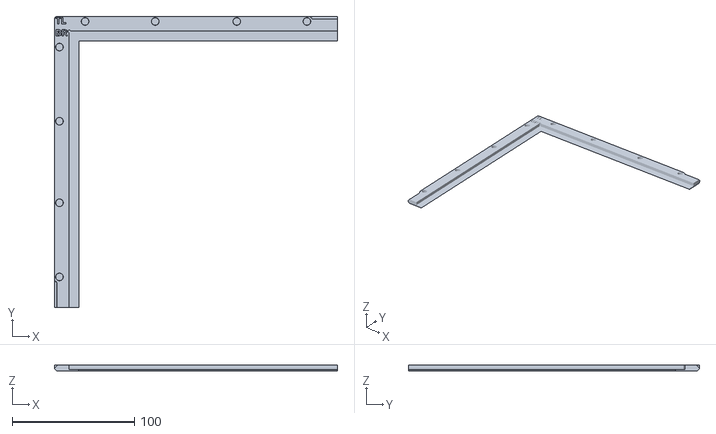
[picture p103: CAD file, 2021-06-30]
printer_mods/yeri/V1_V2_Magnetic_Panels/STL/V1/300/Side_Panel/Panel_Top_Left_and_Bottom_Right_x2_Side_Panel.stl
231.4 x 238.0 x 5.00
