Yeriwyn/VoronUsers/printer_mods/yeri/V1_V2_Magnetic_Panels/STL/V1/300/Side_Panel_for_270_Hinges/Top_Right_and_Bottom_Left_with_Hinge_x1.stl

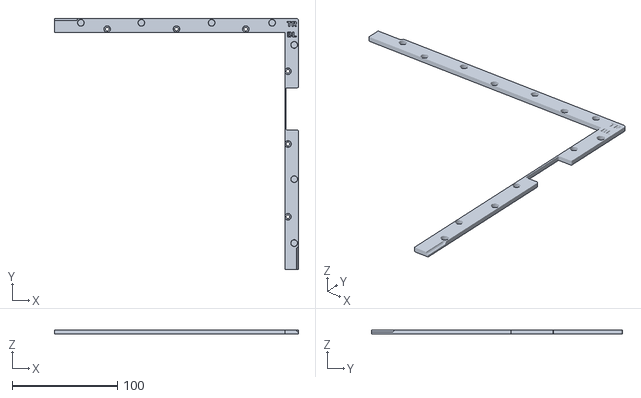
[picture p104: CAD file, 2021-06-30]
printer_mods/yeri/V1_V2_Magnetic_Panels/STL/V1/300/Side_Panel_for_270_Hinges/Top_Right_and_Bottom_Left_with_Hinge_x1.stl
231.4 x 238.0 x 4.00
