Yeriwyn/VoronUsers/printer_mods/yeri/V1_V2_Magnetic_Panels/STL/V1/300/Top_Panel_for_Handle_Mod/Handle_x2.stl

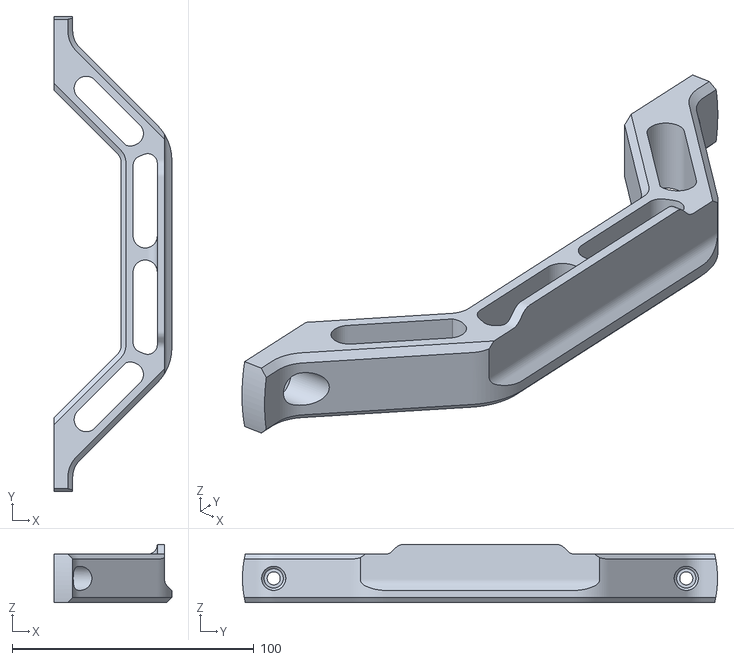
[picture p105: CAD file, 2021-06-30]
printer_mods/yeri/V1_V2_Magnetic_Panels/STL/V1/300/Top_Panel_for_Handle_Mod/Handle_x2.stl
48.7 x 196.6 x 24.0
