Yeriwyn/VoronUsers/printer_mods/Andre/Mini_Afterburner_Strain_Relief/STL/Strain_Relief_Body_Top_x1.stl

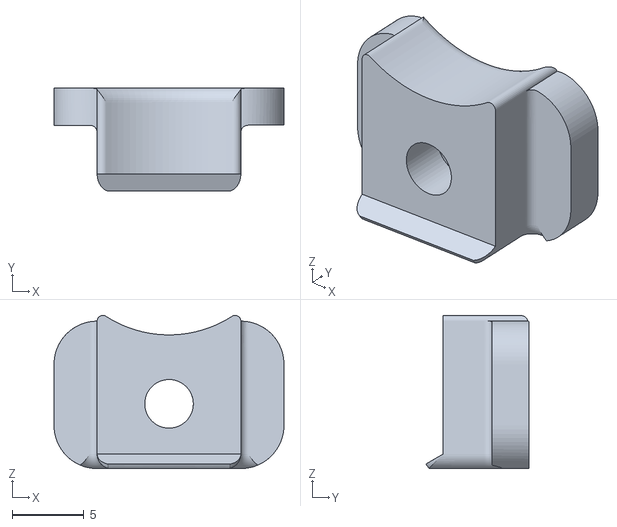
[picture p106: CAD file, 2021-06-30]
printer_mods/Andre/Mini_Afterburner_Strain_Relief/STL/Strain_Relief_Body_Top_x1.stl
16.0 x 7.19 x 10.7
