Yeriwyn/VoronUsers/printer_mods/buzzdalf/ytension/STL/shell.stl

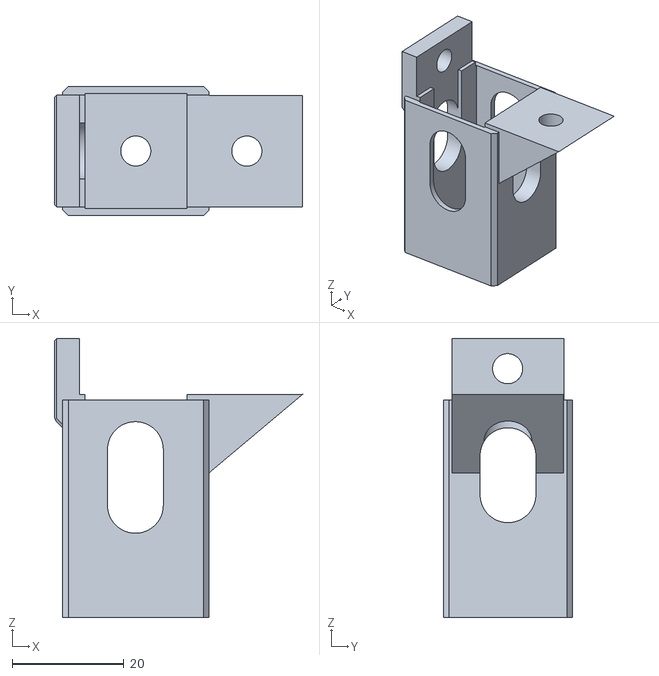
[picture p107: CAD file, 2021-06-30]
printer_mods/buzzdalf/ytension/STL/shell.stl
44.5 x 23.2 x 50.0
