Yeriwyn/VoronUsers/printer_mods/hartk1213/Voron0_MGN9C_X_Axis/STLs/[a]_X_Endstop_Bumper_MGN9C_x1.stl

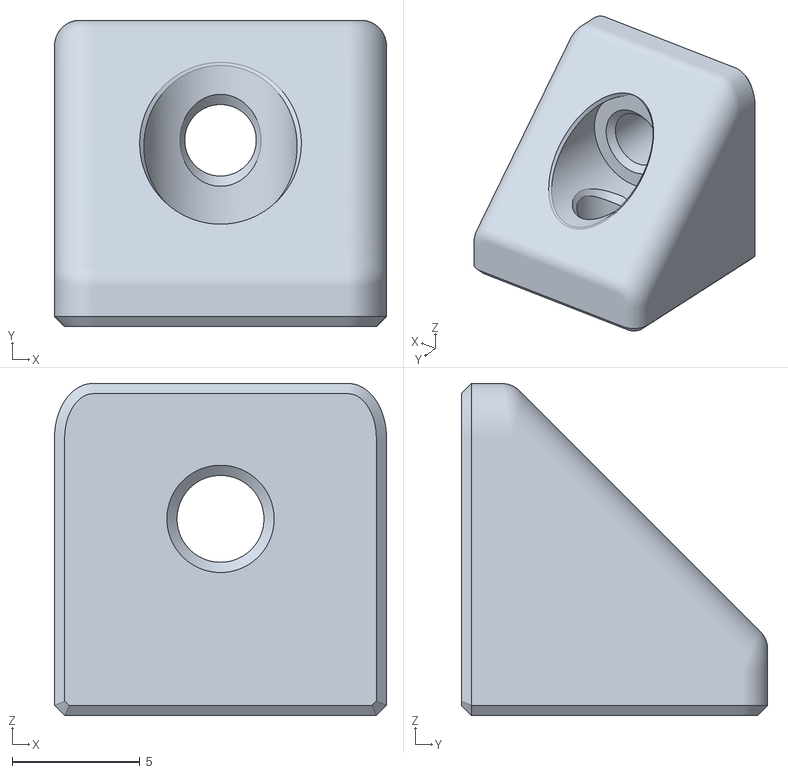
[picture p108: CAD file, 2021-06-30]
printer_mods/hartk1213/Voron0_MGN9C_X_Axis/STLs/[a]_X_Endstop_Bumper_MGN9C_x1.stl
13.0 x 12.0 x 13.0
