Yeriwyn/VoronUsers/printer_mods/JosAr/Klicky-Probe/STL/KlickyProbe_Probe_Dock_v0_2.stl

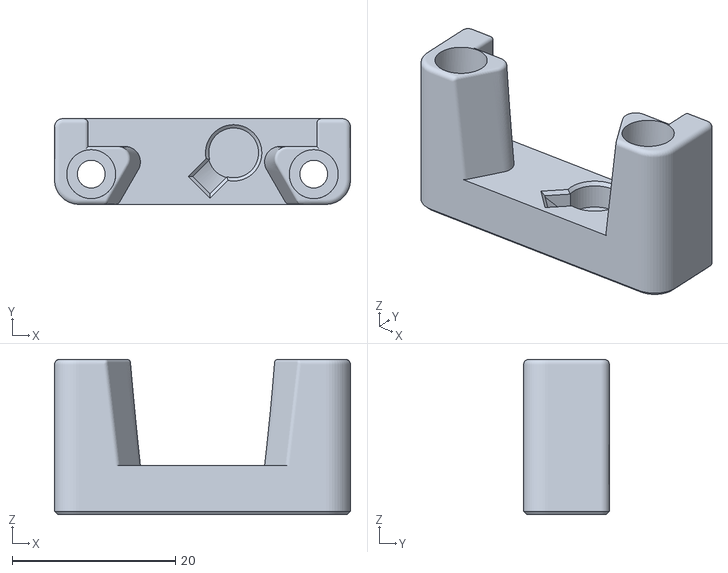
[picture p109: CAD file, 2021-06-30]
printer_mods/JosAr/Klicky-Probe/STL/KlickyProbe_Probe_Dock_v0_2.stl
36.3 x 10.5 x 19.0
