Yeriwyn/VoronUsers/printer_mods/KevinAkaSam/VEFACH/STL_CAD/1_hepa.stl

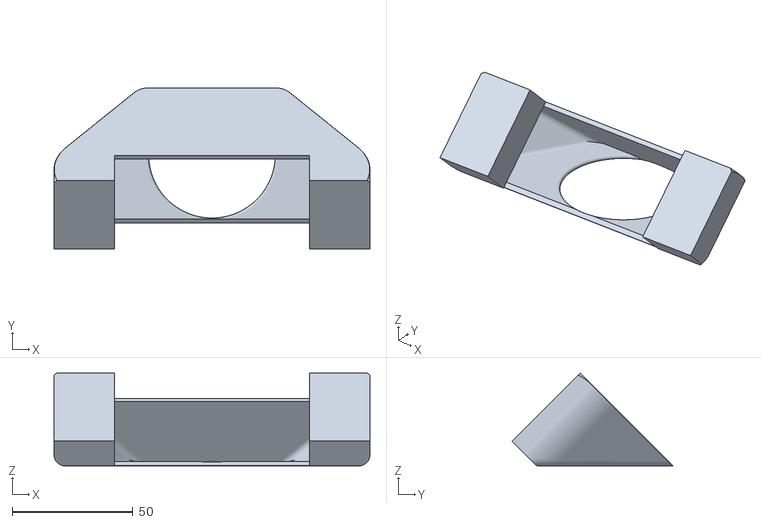
[picture p110: CAD file, 2021-06-30]
printer_mods/KevinAkaSam/VEFACH/STL_CAD/1_hepa.stl
131.1 x 66.7 x 38.5
