Yeriwyn/VoronUsers/printer_mods/MathematicalPotato/v0.1_belted_z_drive/STL/V0-ZBelt-BeltClip-Bottom_MODIFIED_V0.1.stl

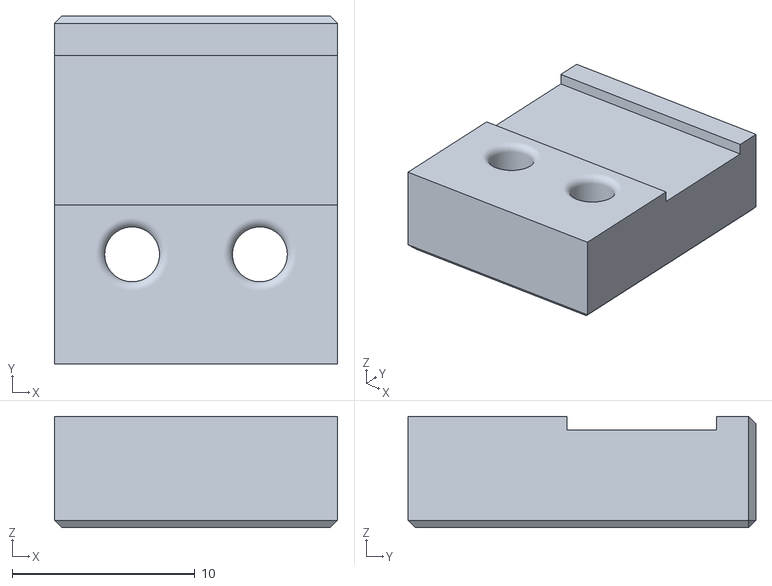
[picture p111: CAD file, 2021-06-30]
printer_mods/MathematicalPotato/v0.1_belted_z_drive/STL/V0-ZBelt-BeltClip-Bottom_MODIFIED_V0.1.stl
15.5 x 19.1 x 6.10
