Yeriwyn/VoronUsers/printer_mods/Phalanx/Other-V2-Idlers/STL/Front_Idler_Topx2.stl

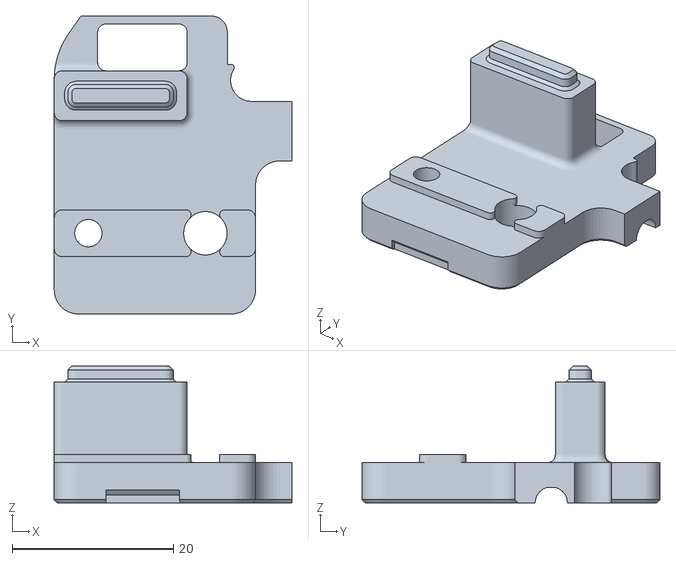
[picture p112: CAD file, 2021-07-27]
printer_mods/Phalanx/Other-V2-Idlers/STL/Front_Idler_Topx2.stl
29.5 x 37.0 x 17.0
