Yeriwyn/VoronUsers/printer_mods/Printopal/Magnetic_top_panel/STEP/frame_corner.stp

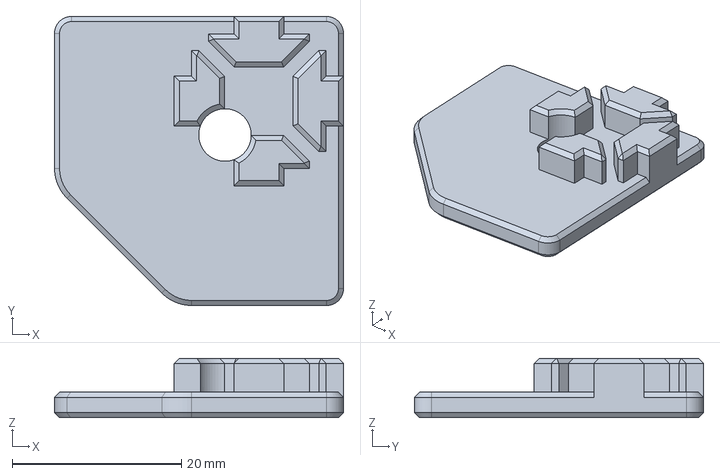
[picture p113: CAD file, 2021-07-27]
printer_mods/Printopal/Magnetic_top_panel/STEP/frame_corner.stp
34.1 x 34.1 x 7.00 mm
