Yeriwyn/VoronUsers/printer_mods/revnull/rpi_7in_display_mount/STL/voron_2.4_lcd_mount_foot_b.stl

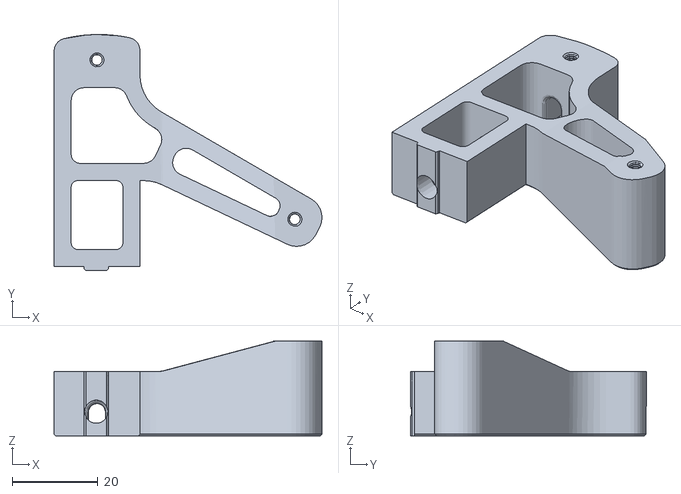
[picture p114: CAD file, 2021-07-27]
printer_mods/revnull/rpi_7in_display_mount/STL/voron_2.4_lcd_mount_foot_b.stl
62.3 x 54.9 x 22.0
