Yeriwyn/VoronUsers/printer_mods/Shteeeeeve/V01-LED-Tophat/STLs/LED-Tophat-Top-Cover.stl

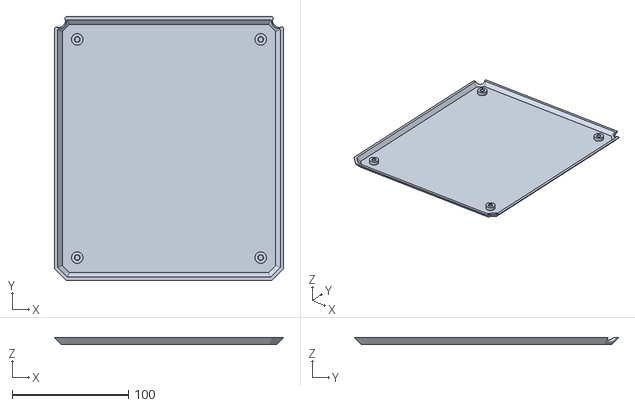
[picture p116: CAD file, 2021-07-27]
printer_mods/Shteeeeeve/V01-LED-Tophat/STLs/LED-Tophat-Top-Cover.stl
197.5 x 227.4 x 6.00
