Yeriwyn/VoronUsers/printer_mods/Triano/Ender_3Pro_Switchwire/STL/Deck/deck_front_left.stl

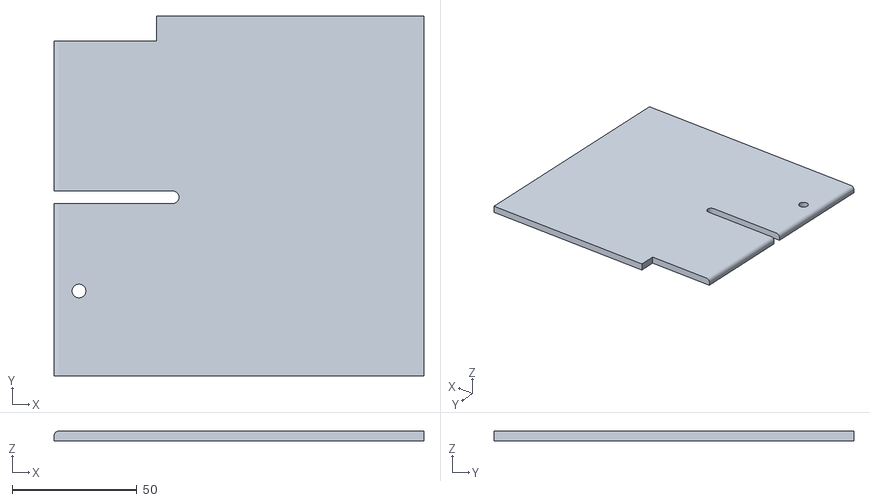
[picture p117: CAD file, 2021-06-30]
printer_mods/Triano/Ender_3Pro_Switchwire/STL/Deck/deck_front_left.stl
148.0 x 144.0 x 4.00
