Yeriwyn/VoronUsers/printer_mods/Triano/Ender_3Pro_Switchwire/STL/Electronics/[a]_rpi3_mount.stl

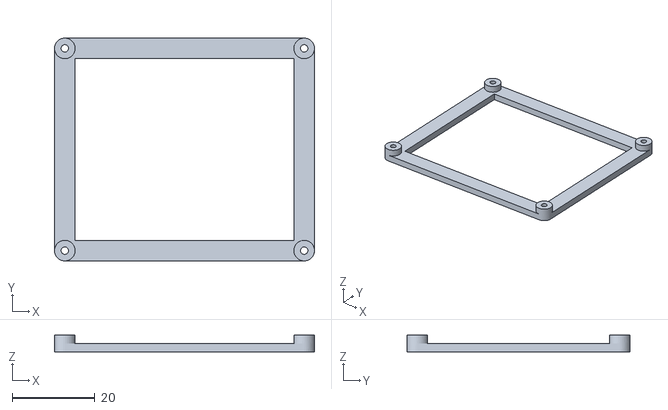
[picture p118: CAD file, 2021-06-30]
printer_mods/Triano/Ender_3Pro_Switchwire/STL/Electronics/[a]_rpi3_mount.stl
63.0 x 54.0 x 4.00
