Yeriwyn/VoronUsers/printer_mods/Triano/Ender_3Pro_Switchwire/STL/XZ-Axis/z_carriage_stop_x2.stl

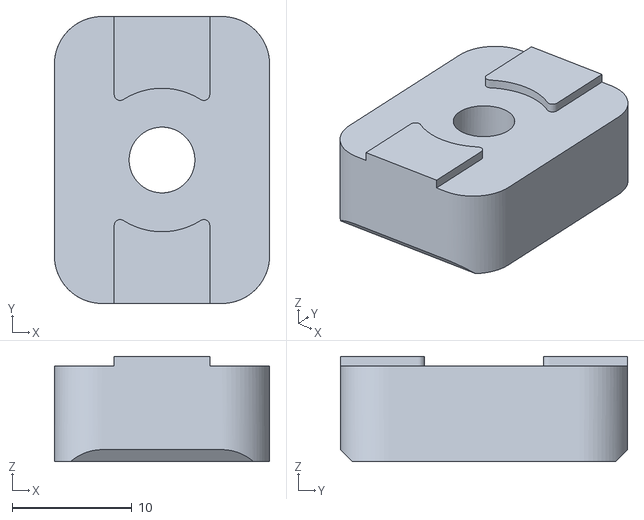
[picture p119: CAD file, 2021-06-30]
printer_mods/Triano/Ender_3Pro_Switchwire/STL/XZ-Axis/z_carriage_stop_x2.stl
18.0 x 24.0 x 8.80
