Yeriwyn/VoronUsers/printer_mods/Triano/Ender_3Pro_Switchwire/STL/Y-Axis/y_axis_bed_carriage.stl

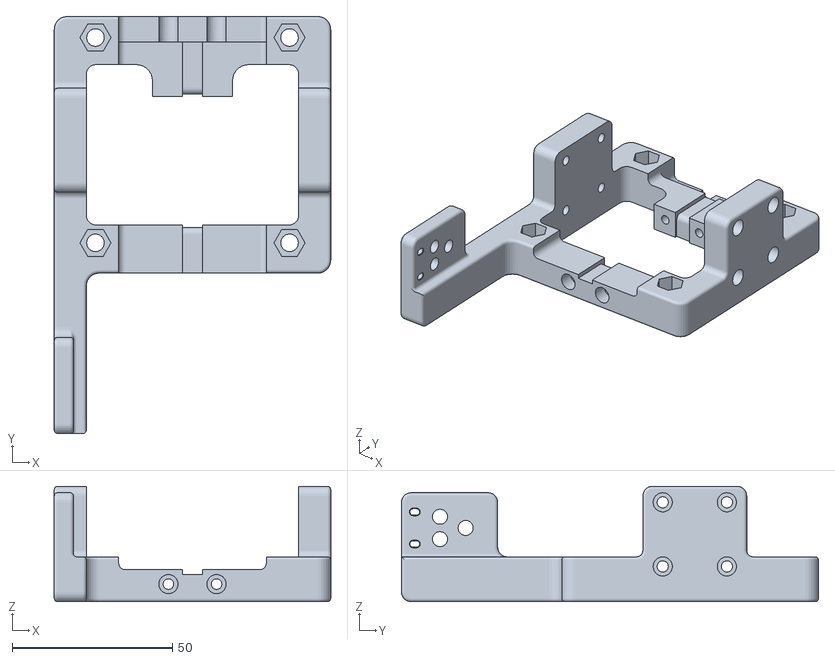
[picture p120: CAD file, 2021-06-30]
printer_mods/Triano/Ender_3Pro_Switchwire/STL/Y-Axis/y_axis_bed_carriage.stl
86.2 x 130.0 x 36.0
