Yeriwyn/VoronUsers/printer_mods/Ultrawaffles/Ender_3_to_SW/DXF/side_rear_panel_L.dxf

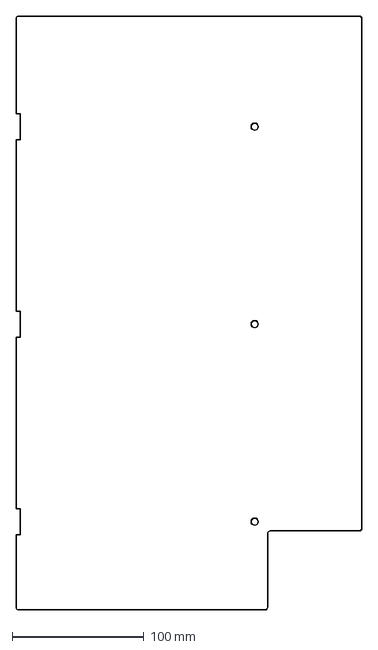
[picture p121: CAD file, 2021-07-27]
printer_mods/Ultrawaffles/Ender_3_to_SW/DXF/side_rear_panel_L.dxf
262.5 x 451.0 mm
