Yeriwyn/VoronUsers/printer_mods/Ultrawaffles/Ender_3_to_SW/STLs/Electronics/screen_(ender3_original)_wip/front_display.stl

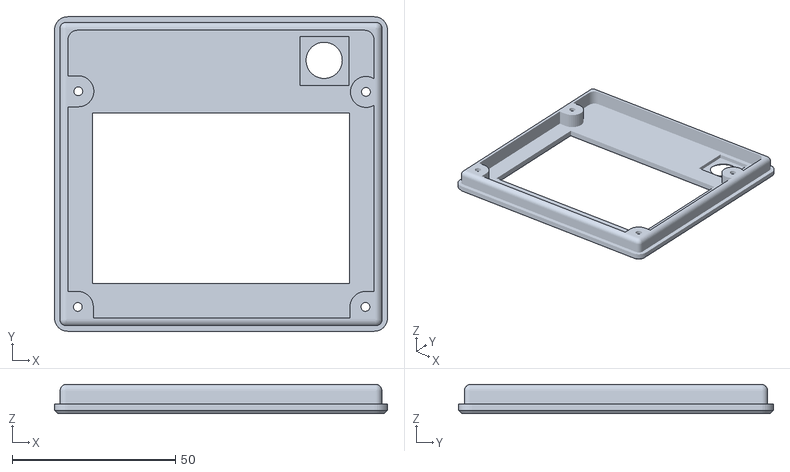
[picture p122: CAD file, 2021-07-27]
printer_mods/Ultrawaffles/Ender_3_to_SW/STLs/Electronics/screen_(ender3_original)_wip/front_display.stl
101.9 x 96.2 x 9.00
