Yeriwyn/VoronUsers/printer_mods/Ultrawaffles/Ender_3_to_SW/STLs/Gantry/XZ_axis/keyback_mount.stl

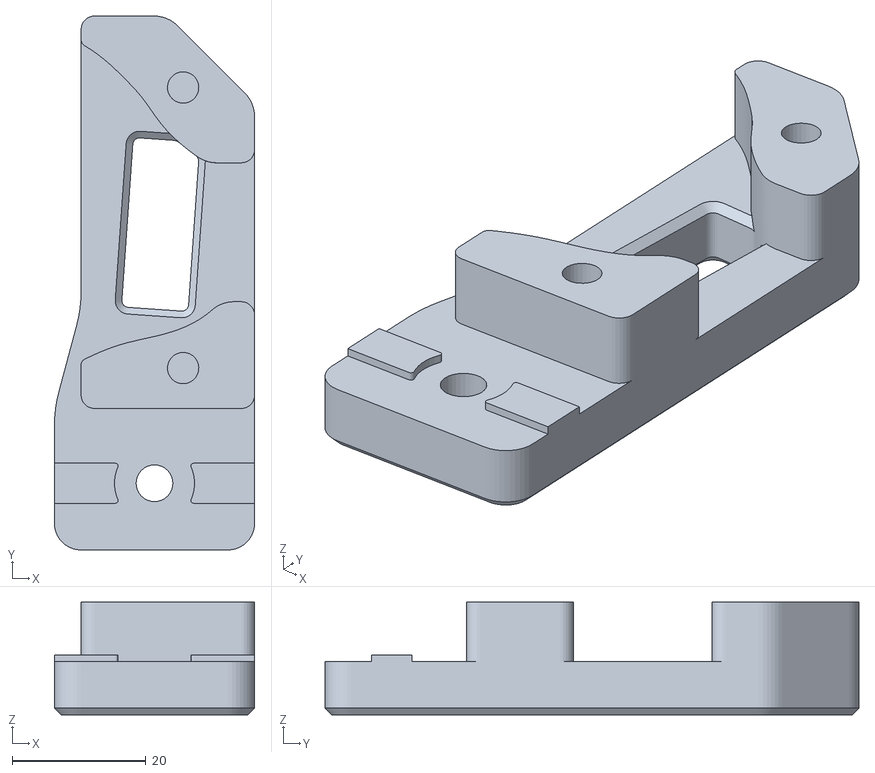
[picture p123: CAD file, 2021-07-27]
printer_mods/Ultrawaffles/Ender_3_to_SW/STLs/Gantry/XZ_axis/keyback_mount.stl
30.0 x 80.0 x 16.9
