Yeriwyn/VoronUsers/printer_mods/Ultrawaffles/Ender_3_to_SW/STLs/Gantry/Y_axis/y_belt_anchor.stl

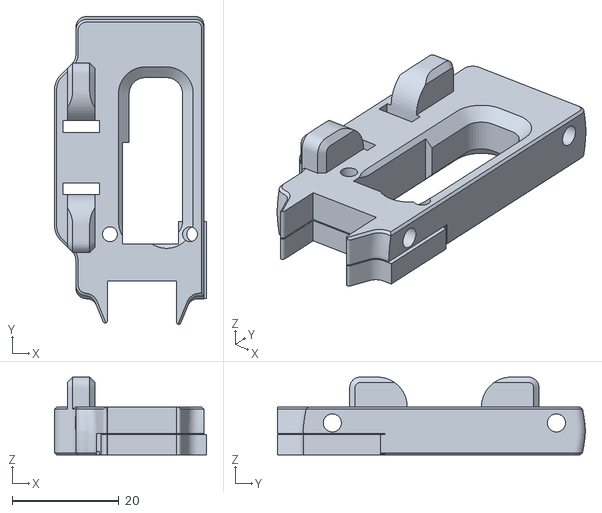
[picture p124: CAD file, 2021-07-27]
printer_mods/Ultrawaffles/Ender_3_to_SW/STLs/Gantry/Y_axis/y_belt_anchor.stl
28.5 x 57.7 x 14.6
