Yeriwyn/VoronUsers/printer_mods/yeri/V0_Magnetic_Panels/STL/Split/Mount_Corner_frameless_x6.stl

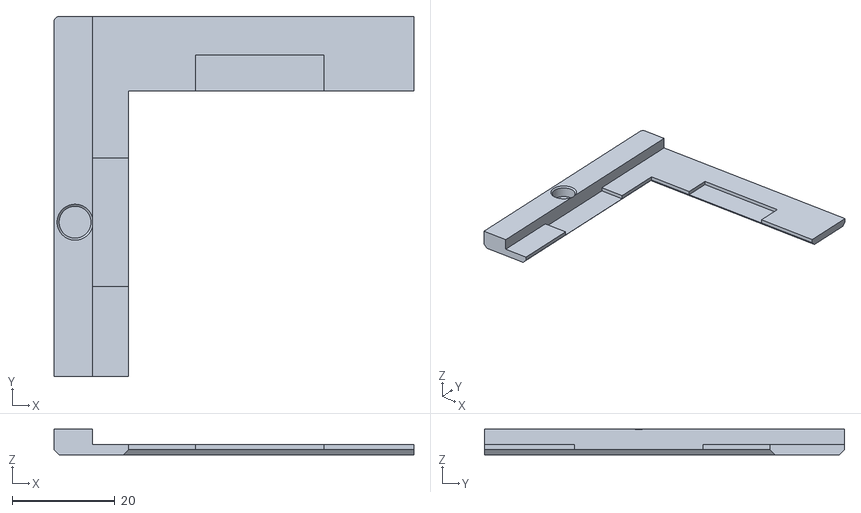
[picture p125: CAD file, 2021-05-28]
printer_mods/yeri/V0_Magnetic_Panels/STL/Split/Mount_Corner_frameless_x6.stl
70.0 x 70.0 x 5.00
