Yeriwyn/VoronUsers/printer_mods/buzzdalf/ytension/STL/insert.stl

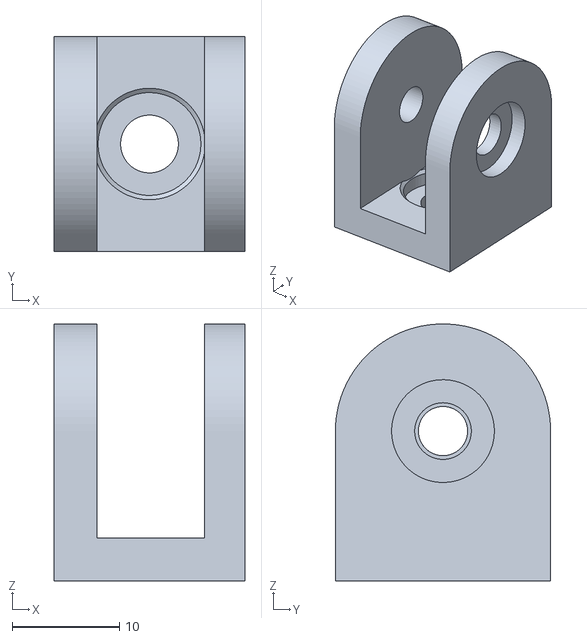
[picture p126: CAD file, 2021-06-30]
printer_mods/buzzdalf/ytension/STL/insert.stl
17.8 x 20.1 x 24.0
