Yeriwyn/VoronUsers/printer_mods/DoubleT/afterburner_triple_bowden/STLs/Bowden_Triple_Adapter_front_a.stl

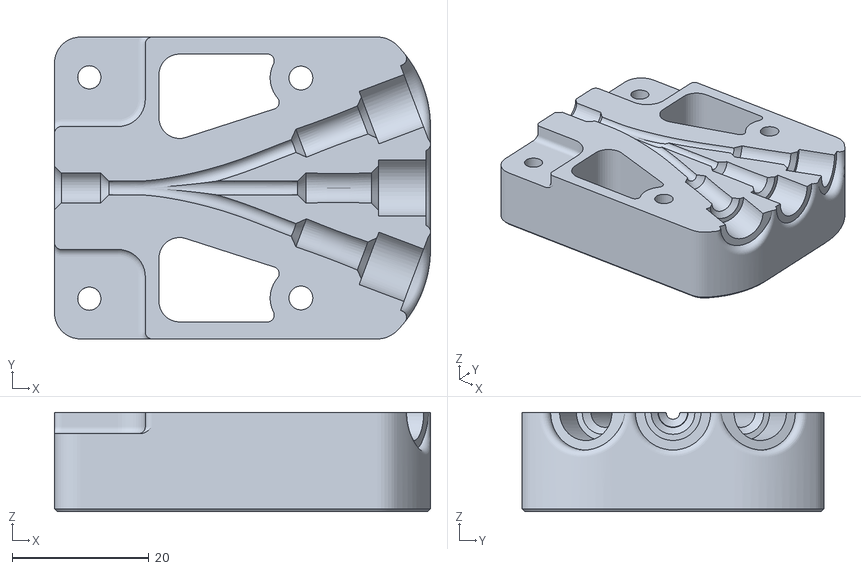
[picture p127: CAD file, 2021-06-30]
printer_mods/DoubleT/afterburner_triple_bowden/STLs/Bowden_Triple_Adapter_front_a.stl
55.0 x 44.2 x 14.5
