Yeriwyn/VoronUsers/printer_mods/JosAr/Klicky-Probe/STL/KlickyProbe_Probe_v0_2.stl

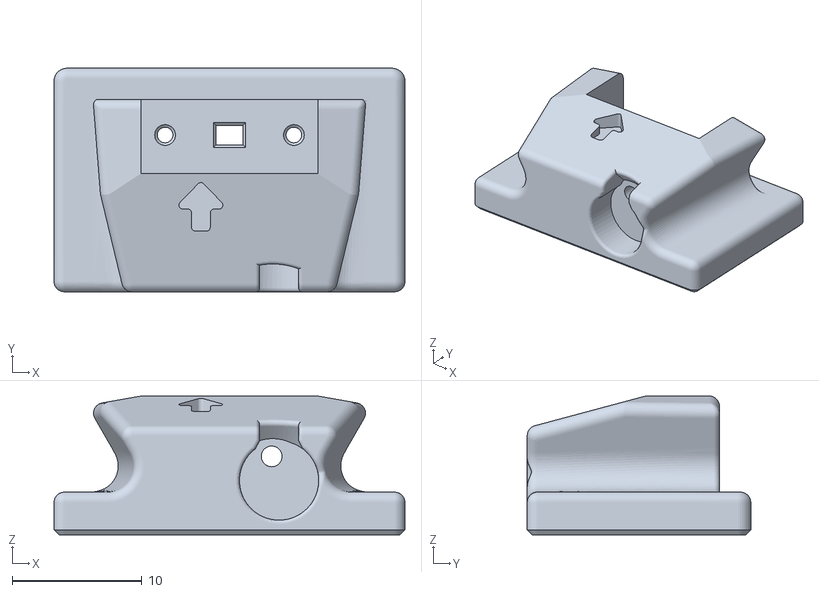
[picture p128: CAD file, 2021-06-30]
printer_mods/JosAr/Klicky-Probe/STL/KlickyProbe_Probe_v0_2.stl
27.0 x 17.2 x 10.7
