Yeriwyn/VoronUsers/printer_mods/KevinAkaSam/VEFACH/STL_CAD/1_coal_for_infill_mesh.stl

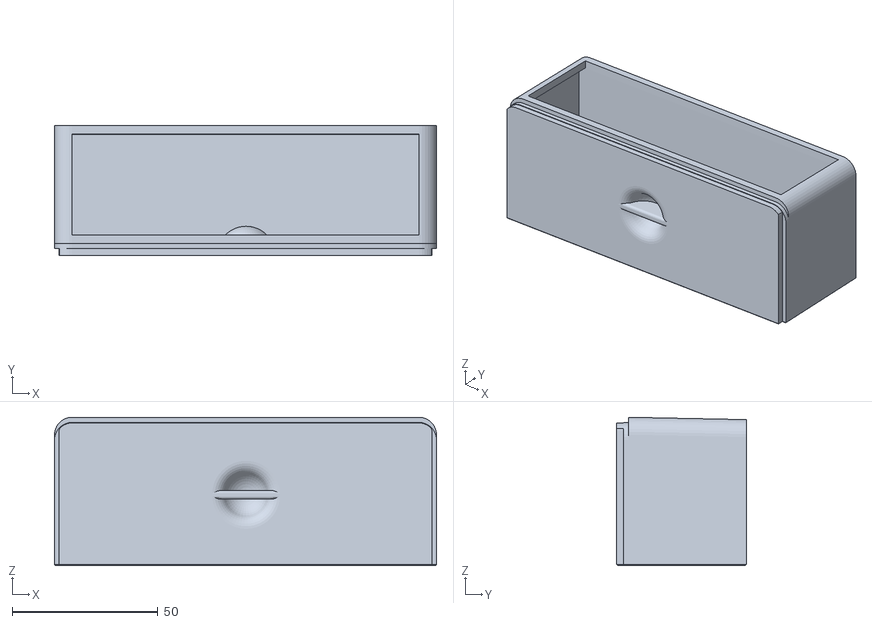
[picture p129: CAD file, 2021-06-30]
printer_mods/KevinAkaSam/VEFACH/STL_CAD/1_coal_for_infill_mesh.stl
131.0 x 44.5 x 50.9
