Yeriwyn/VoronUsers/printer_mods/MathematicalPotato/v0.1_belted_z_drive/STL/V0-ZBelt-Top-Idler-Back.stl

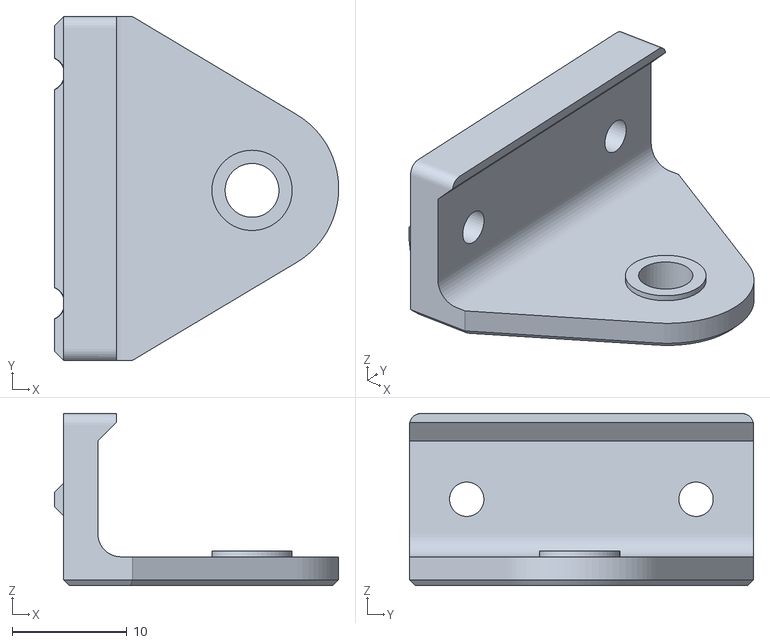
[picture p130: CAD file, 2021-06-30]
printer_mods/MathematicalPotato/v0.1_belted_z_drive/STL/V0-ZBelt-Top-Idler-Back.stl
24.8 x 30.0 x 15.0
