Yeriwyn/VoronUsers/printer_mods/Triano/Ender_3Pro_Switchwire/STL/Electronics/[a]_ps_clamp.stl

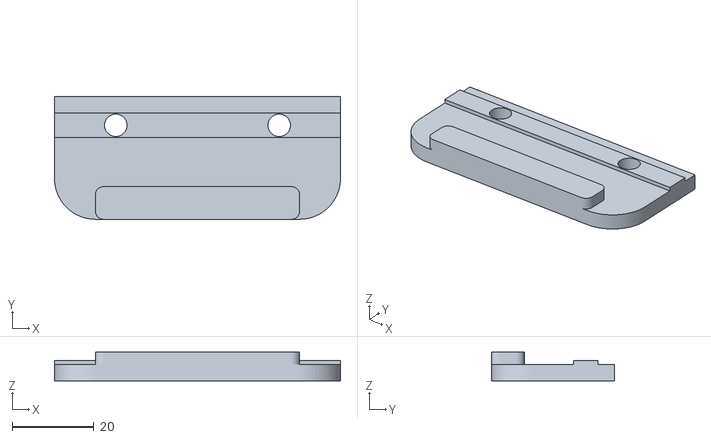
[picture p131: CAD file, 2021-06-30]
printer_mods/Triano/Ender_3Pro_Switchwire/STL/Electronics/[a]_ps_clamp.stl
70.0 x 30.0 x 7.00
