Yeriwyn/VoronUsers/printer_mods/Triano/Ender_3Pro_Switchwire/STL/Grill/grill_rear_left.stl

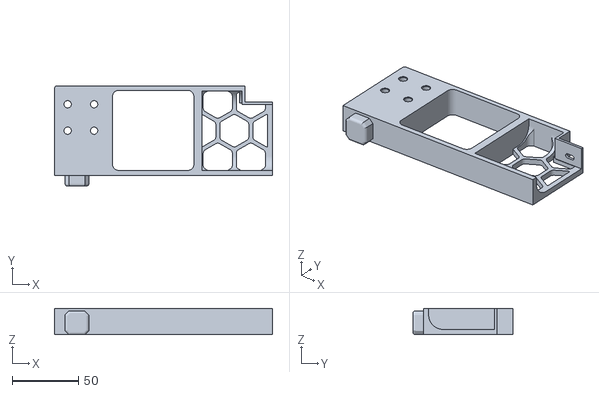
[picture p132: CAD file, 2021-06-30]
printer_mods/Triano/Ender_3Pro_Switchwire/STL/Grill/grill_rear_left.stl
164.9 x 76.0 x 20.0
