Yeriwyn/VoronUsers/printer_mods/Triano/Ender_3Pro_Switchwire/STL/XZ-Axis/xz_block_right_a.stl

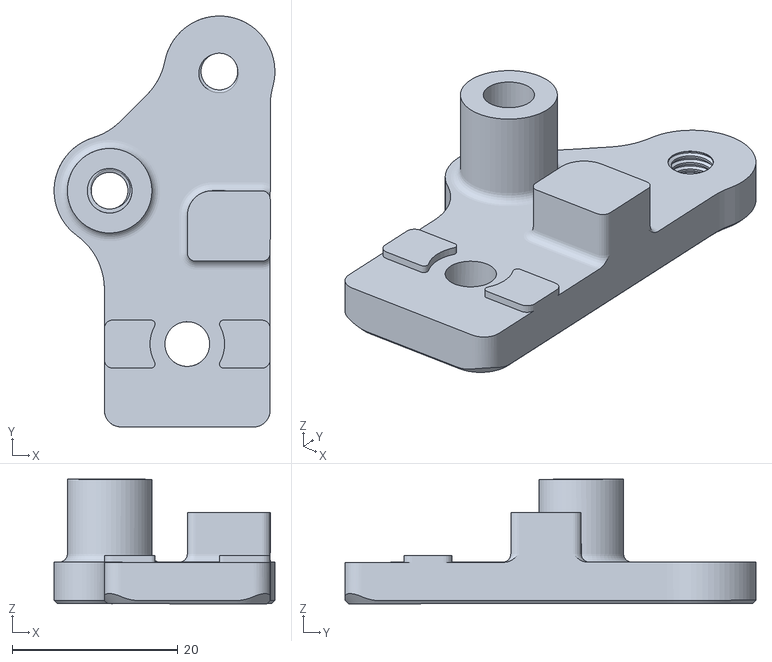
[picture p133: CAD file, 2021-06-30]
printer_mods/Triano/Ender_3Pro_Switchwire/STL/XZ-Axis/xz_block_right_a.stl
26.6 x 49.6 x 15.0
