Yeriwyn/VoronUsers/printer_mods/Triano/Ender_3Pro_Switchwire/STL/Y-Axis/[a]_y_axis_anchor_x2.stl

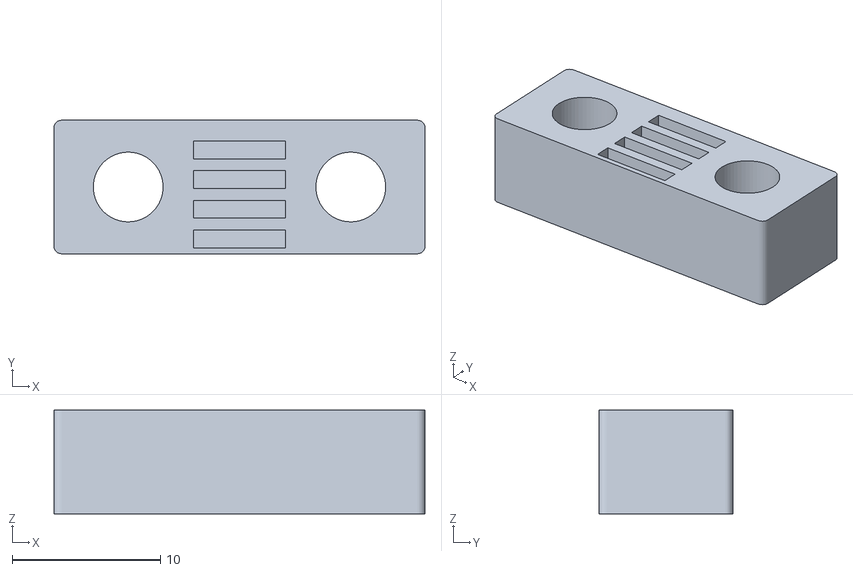
[picture p134: CAD file, 2021-06-30]
printer_mods/Triano/Ender_3Pro_Switchwire/STL/Y-Axis/[a]_y_axis_anchor_x2.stl
25.0 x 9.00 x 7.00
