Yeriwyn/VoronUsers/printer_mods/Ultrawaffles/Ender_3_to_SW/DXF/rear_panel.dxf

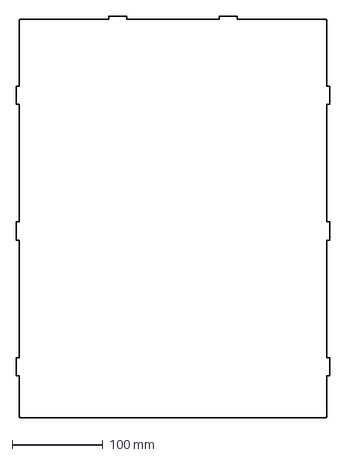
[picture p135: CAD file, 2021-07-27]
printer_mods/Ultrawaffles/Ender_3_to_SW/DXF/rear_panel.dxf
346.0 x 443.0 mm
