Yeriwyn/VoronUsers/printer_mods/Ultrawaffles/Ender_3_to_SW/STLs/Gantry/XZ_axis/Keyback_idler.stl

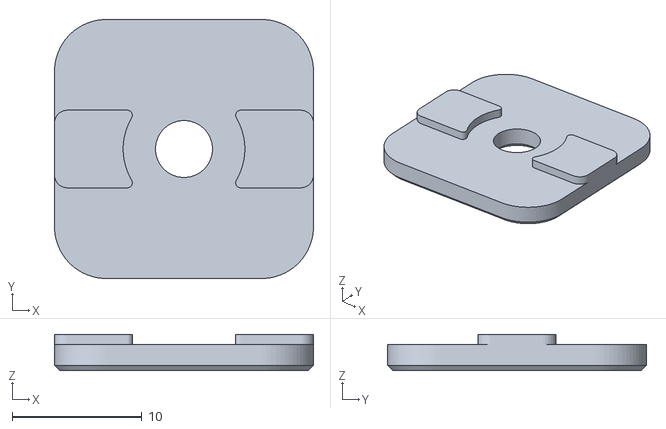
[picture p136: CAD file, 2021-07-27]
printer_mods/Ultrawaffles/Ender_3_to_SW/STLs/Gantry/XZ_axis/Keyback_idler.stl
20.0 x 20.0 x 2.80
