Yeriwyn/VoronUsers/printer_mods/yeri/V0_Magnetic_Panels/STL/One_Piece/Side Panel Mount.stl

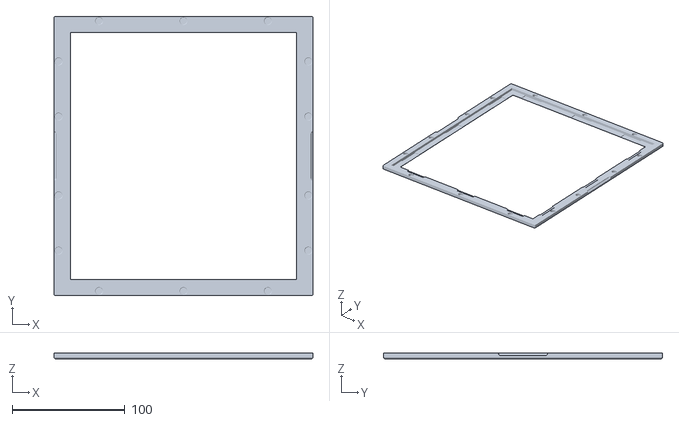
[picture p138: CAD file, 2021-05-28]
printer_mods/yeri/V0_Magnetic_Panels/STL/One_Piece/Side Panel Mount.stl
230.0 x 248.0 x 5.00
