Yeriwyn/VoronUsers/(list of files, cad)

Other CAD files:
printer_mods/rsheng118/BTT_octopus_DIN_vertical_mount/STL/spacer_x4.stl
printer_mods/yeri/V0_Magnetic_Panels/STL/One_Piece/Front Mounting Plate.stl
printer_mods/yeri/V1_V2_Magnetic_Panels/STL/V1/300/Side_Panel_for_270_Hinges/Top_Left_and_Bottom_Right_x1.stl
printer_mods/buzzdalf/ytension/STL/HEATSET.stl
printer_mods/Ch4rlesB/V0_Handles_Slim/V0_Handles_Slim_2.5_Panel_x2.stl
printer_mods/khay/micro_backplate/microback_right.stl
printer_mods/Ultrawaffles/Ender_3_to_SW/STLs/Gantry/XZ_axis/x_carriage/x_carriage_frame_left.stl
printer_mods/yeri/V1_V2_Magnetic_Panels/STL/V1/300/Top_Panel/Top_Left_and_Bottom_Right_x2.stl
printer_mods/DoubleT/afterburner_triple_bowden/STLs/Bowden_Triple_Adapter_igus.stl
printer_mods/Triano/Ender_3Pro_Switchwire/STL/Grill/grill_front_right.stl
printer_mods/Ultrawaffles/Ender_3_to_SW/STLs/Grill/grill_rear_left_filtered.stl
printer_mods/wile-e1/Deck_Panel_Support_Clips/wile.e-deck_panel_support_lower_adjustable(3-6mm).stp
printer_mods/yeri/V0_Magnetic_Panels/Side_Mounting_Plate.stl
printer_mods/yeri/V0_Magnetic_Panels/STL/One_Piece/Side Mounting Plate.stl
printer_mods/yeri/V1_V2_Magnetic_Panels/STL/V1/300/Side_Panel/Top_Left_and_Bottom_Right_x2_Side_Panel.stl
printer_mods/yeri/V1_V2_Magnetic_Panels/STL/V1/300/Top_Panel/Panel_Top_Left_and_Bottom_Right_x2.stl
printer_mods/yeri/V1_V2_Magnetic_Panels/STL/V1/300/Top_Panel_for_Handle_Mod/Top_Right_and_Bottom_Left_x2.stl
printer_mods/revnull/rpi_7in_display_mount/STL/voron_2.4_lcd_mount_foot_a.stl
printer_mods/Triano/Ender_3Pro_Switchwire/STL/Deck/deck_rear_right.stl
printer_mods/yeri/V0_Magnetic_Panels/Panel_Mount_v2.stl
printer_mods/mpfl/V0.1_skirt_OLED/v0.1-skirt-oled.scad
printer_mods/Andre/Mini_Afterburner_ADXL345_Mount/CAD/MiniAB_ADXL_Mount.f3d
printer_mods/Andre/Mini_Afterburner_Strain_Relief/CAD/Mini_Afterburner_Strain_Relief.f3d
printer_mods/Andre/V0_Neopixel_Front_Bed_Mount/CAD/V0_Neopixel_Front_Bed_Mount.f3d
printer_mods/BladeScraper-Designs/Horizontal-Spool-Holder/Holder.ipt
printer_mods/BladeScraper-Designs/Horizontal-Spool-Holder/Holder.stl
printer_mods/DoubleT/afterburner_triple_bowden/CAD/Bowden_Triple_Adapter.f3d
printer_mods/DoubleT/fysetc_spider_mount_extrusion/CAD/SpiderMount.f3d
printer_mods/DoubleT/input_shaper_mount/CAD/input_shaper_mount.f3d
printer_mods/DoubleT/switchwire_tft_display/CAD/switchwire_tft_display_mount.f3d
printer_mods/JosAr/Klicky-Probe/STL/KlickyProbe_AB_mount.stl
printer_mods/JosAr/Klicky-Probe/STL/KlickyProbe_Dock_Mount_Fixed.stl
printer_mods/JosAr/Klicky-Probe/STL/KlickyProbe_Dock_Mount_Variable_pt1.stl
printer_mods/JosAr/Klicky-Probe/STL/KlickyProbe_Dock_Mount_Variable_pt2.stl
printer_mods/JosAr/Klicky-Probe/STL/KlickyProbe_Dock_Side_Mount_Fixed_pt1.stl
printer_mods/MathematicalPotato/v0.1_belted_z_drive/STL/M4_80T_Gear.stl
printer_mods/MathematicalPotato/v0.1_belted_z_drive/STL/Printed-PulleySpacer-x2.stl
printer_mods/MathematicalPotato/v0.1_belted_z_drive/STL/V0-ZBelt-BeltClip-Top_MODIFIED_V0.1.stl
printer_mods/MathematicalPotato/v0.1_belted_z_drive/STL/V0-ZBelt-Deck-Panel-Rear.stl
printer_mods/MathematicalPotato/v0.1_belted_z_drive/STL/V0-ZBelt-FrontBottom-Bracket.stl
printer_mods/MathematicalPotato/v0.1_belted_z_drive/STL/V0-ZBelt-Top-Idler-Front.stl
printer_mods/Phalanx/Other-V2-Idlers/CAD/Other_Idler_V2.f3d
printer_mods/Printopal/Magnetic_top_panel/STEP/300_top_skirt_270.stp
printer_mods/Printopal/Magnetic_top_panel/STEP/panel_corner.stp
printer_mods/Printopal/Magnetic_top_panel/STEP/top_corner_skirt.stp
printer_mods/Printopal/Magnetic_top_panel/STL/250_top_skirt_220.stl
printer_mods/Printopal/Magnetic_top_panel/STL/300_top_skirt_270.stl
printer_mods/Printopal/Magnetic_top_panel/STL/350_top_skirt_320.stl
printer_mods/Printopal/Magnetic_top_panel/STL/frame_corner.stl
printer_mods/Printopal/Magnetic_top_panel/STL/panel_corner.stl
printer_mods/Printopal/Magnetic_top_panel/STL/top_corner_skirt.stl
printer_mods/Triano/Ender_3Pro_Switchwire/STL/Deck/deck_front_right.stl
printer_mods/Triano/Ender_3Pro_Switchwire/STL/Electronics/2020_ziptie_clip.stl
printer_mods/Triano/Ender_3Pro_Switchwire/STL/Electronics/[a]_rs_25_hanger.stl
printer_mods/Triano/Ender_3Pro_Switchwire/STL/Electronics/[a]_skr_mini_e3_mount.stl
printer_mods/Triano/Ender_3Pro_Switchwire/STL/Grill/grill_front_left.stl
printer_mods/Triano/Ender_3Pro_Switchwire/STL/XZ-Axis/[a]_xz_cable_cover.stl
printer_mods/Triano/Ender_3Pro_Switchwire/STL/XZ-Axis/keybak_mount_plate_a.stl
printer_mods/Triano/Ender_3Pro_Switchwire/STL/XZ-Axis/keybak_mount_plate_b.stl
printer_mods/Triano/Ender_3Pro_Switchwire/STL/XZ-Axis/x_motor_mount_a.stl
printer_mods/Triano/Ender_3Pro_Switchwire/STL/XZ-Axis/x_motor_mount_b.stl
printer_mods/Triano/Ender_3Pro_Switchwire/STL/XZ-Axis/xz_block_left_a.stl
printer_mods/Triano/Ender_3Pro_Switchwire/STL/XZ-Axis/xz_block_left_b.stl
printer_mods/Triano/Ender_3Pro_Switchwire/STL/XZ-Axis/z_bearing_block_left.stl
printer_mods/Triano/Ender_3Pro_Switchwire/STL/XZ-Axis/z_motor_mount_a.stl
printer_mods/Triano/Ender_3Pro_Switchwire/STL/XZ-Axis/z_motor_mount_b.stl
printer_mods/Triano/Ender_3Pro_Switchwire/STL/Y-Axis/[a]_y_axis_frame_chain_anchor.stl
printer_mods/Triano/Ender_3Pro_Switchwire/STL/Y-Axis/[a]_y_axis_ls_mount.stl
printer_mods/Triano/Ender_3Pro_Switchwire/STL/Y-Axis/[a]_y_front_belt_mount.stl
printer_mods/Triano/Ender_3Pro_Switchwire/STL/Y-Axis/[a]_y_motor_mount_a.stl
printer_mods/Ultrawaffles/Ender_3_to_SW/DXF/right_deck.dxf
printer_mods/Ultrawaffles/Ender_3_to_SW/DXF/side_rear_panel_R.dxf
printer_mods/Ultrawaffles/Ender_3_to_SW/STLs/Gantry/XZ_axis/Z_bearing block_left.stl
printer_mods/Ultrawaffles/Ender_3_to_SW/STLs/Gantry/XZ_axis/Z_bearing_block_right.stl
printer_mods/Ultrawaffles/Ender_3_to_SW/STLs/Gantry/XZ_axis/[a]_upper_idler_support_b_right.stl
printer_mods/Ultrawaffles/Ender_3_to_SW/STLs/Gantry/XZ_axis/[a]_z+chain_lower_mount.stl
printer_mods/Ultrawaffles/Ender_3_to_SW/STLs/Gantry/XZ_axis/keybak_gantry_anchor.stl
printer_mods/Ultrawaffles/Ender_3_to_SW/STLs/Gantry/XZ_axis/upper_idler_support_a_left.stl
printer_mods/Ultrawaffles/Ender_3_to_SW/STLs/Gantry/XZ_axis/upper_idler_support_a_right.stl
printer_mods/Ultrawaffles/Ender_3_to_SW/STLs/Gantry/XZ_axis/x_motor_mount_a.stl
printer_mods/Ultrawaffles/Ender_3_to_SW/STLs/Gantry/XZ_axis/x_motor_mount_b.stl
printer_mods/Ultrawaffles/Ender_3_to_SW/STLs/Gantry/XZ_axis/xz_block_left_a.stl
printer_mods/Ultrawaffles/Ender_3_to_SW/STLs/Gantry/XZ_axis/xz_block_left_b.stl
printer_mods/Ultrawaffles/Ender_3_to_SW/STLs/Gantry/XZ_axis/xz_block_right_b.stl
printer_mods/Ultrawaffles/Ender_3_to_SW/STLs/Gantry/XZ_axis/z_carriage_stop_x3.stl
printer_mods/Ultrawaffles/Ender_3_to_SW/STLs/Gantry/XZ_axis/z_motor_mount_a.stl
printer_mods/Ultrawaffles/Ender_3_to_SW/STLs/Gantry/XZ_axis/z_motor_mount_b.stl
printer_mods/Ultrawaffles/Ender_3_to_SW/STLs/Grill/[a]_grill_endcap_x4.stl
printer_mods/Ultrawaffles/Ender_3_to_SW/STLs/Grill/grill_front_right.stl
printer_mods/buzzdalf/ytension/CAD/y_tension.f3d
printer_mods/revnull/rpi_7in_display_mount/STL/swing_arm_lg_b.stl
printer_mods/revnull/rpi_7in_display_mount/STL/swing_arm_sm_x2.stl
printer_mods/rsheng118/BTT_octopus_DIN_vertical_mount/STL/BTT_octopus_DIN_mount_A.stl
printer_mods/rsheng118/BTT_octopus_DIN_vertical_mount/STL/BTT_octopus_DIN_mount_B.stl
printer_mods/wile-e1/Deck_Panel_Support_Clips/wile.e-deck_panel_support_lower_4mm.stl
printer_mods/wile-e1/Deck_Panel_Support_Clips/wile.e-deck_panel_support_lower_adjustable(3-6mm).stl
printer_mods/wile-e1/Deck_Panel_Support_Clips/wile.e-deck_panel_support_upper.stl
printer_mods/wrez/astrodyne-inlet/CAD/power-inlet-astrodyne.f3d
printer_mods/yeri/V0_Magnetic_Panels/STL/Split/Mount_Corner_x10.stl
printer_mods/yeri/V0_Magnetic_Panels/STL/Split/Mount_Horizontal_Frameless_x3.stl
printer_mods/yeri/V0_Magnetic_Panels/STL/Split/Mount_Vertical_Middle_x8.stl
printer_mods/yeri/V0_Magnetic_Panels/STL/Split/Plate_Corner_Frameless_Left_x3.stl
printer_mods/yeri/V0_Magnetic_Panels/STL/Split/Plate_Corner_Frameless_Right_x3.stl
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
