Yeriwyn/VoronUsers/printer_mods/sse018/Octopus_DIN_Rail_bracket/README.md

# A DIN Rail bracket for BTT Octopus board - Voron 2.4

This is a DIN Rail bracket for Bigtreetech Octopus board.

Use default pcb_din_clip.stl x2, and print two parts and secure with m2 self-tapping screw.

Octopus board can be secured to this bracket with M3 screw, without nuts.

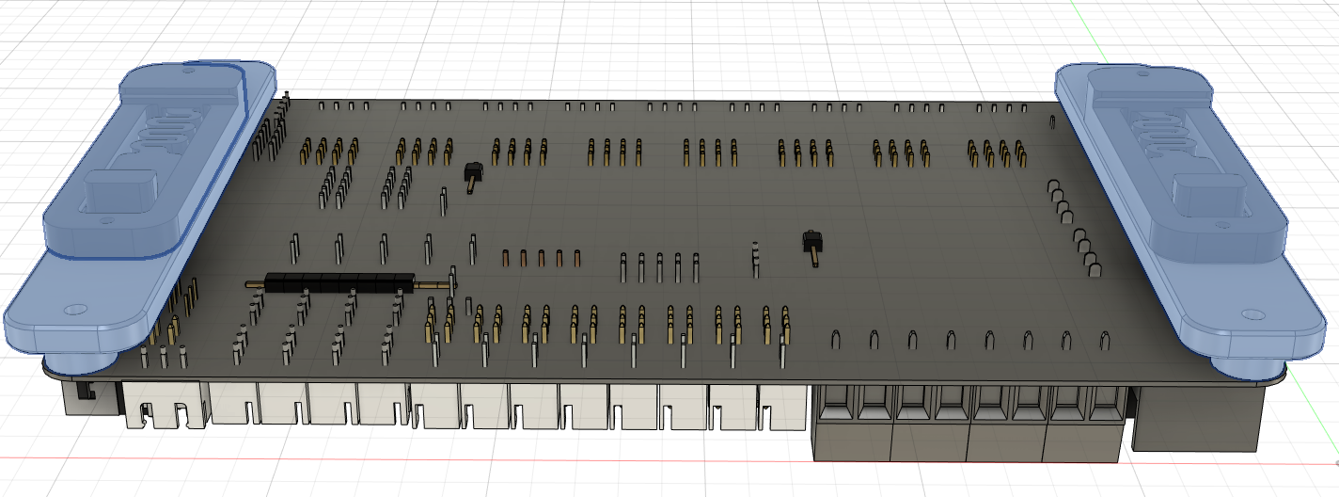
[picture p167: printer_mods/sse018/Octopus_DIN_Rail_bracket/img/octobk-00.png]


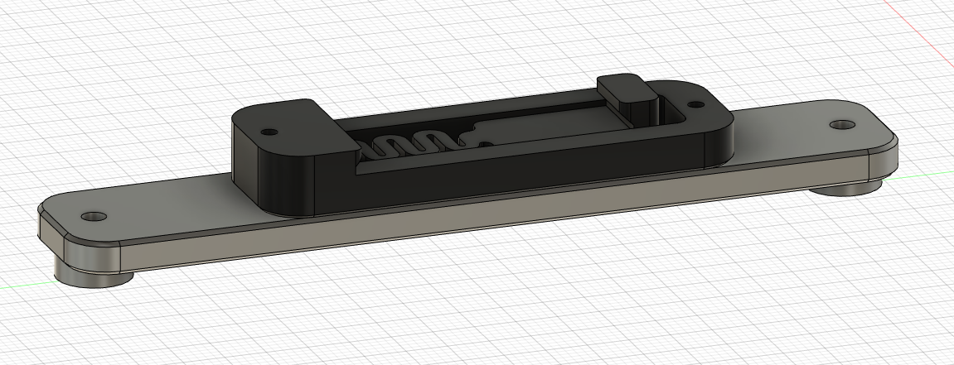
[picture p168: printer_mods/sse018/Octopus_DIN_Rail_bracket/img/octobk-01.png]


#### STL:
[STL](./STL/Octopus_DIN_bracket_x2.stl)

#### CAD:
[CAD](./CAD/octopus_din_bracket.step)
