Yeriwyn/VoronUsers/printer_mods/alanho/BTT_PITFT50_v2_Mount/README.md

# BTT PITFT50 v2 Mount

This work is based on [sttts's Waveshare 5.5inch mount](../../sttts/Waveshare-5.5-inch-HDMI-AMOLED). BTT PITFT50 v2 has a different layout than v1, featuing a brightless thumbwheel, an orientation switch and a JST XH port for unknown function. This design provide accessibility to the thumbwheel and switch.

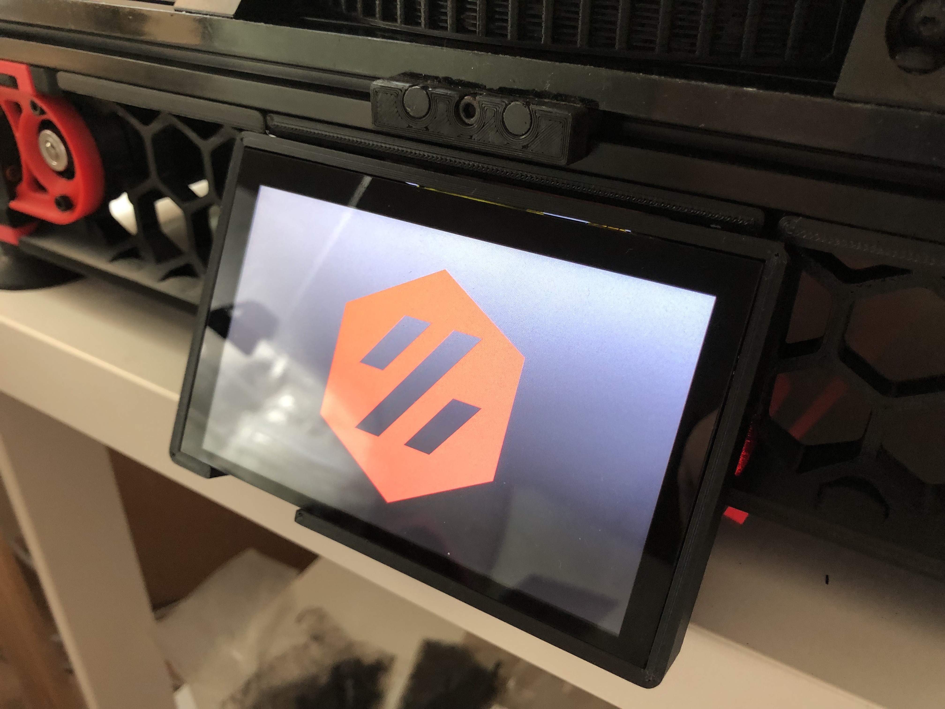
[picture p177: printer_mods/alanho/BTT_PITFT50_v2_Mount/images/IMG_6447.jpg]

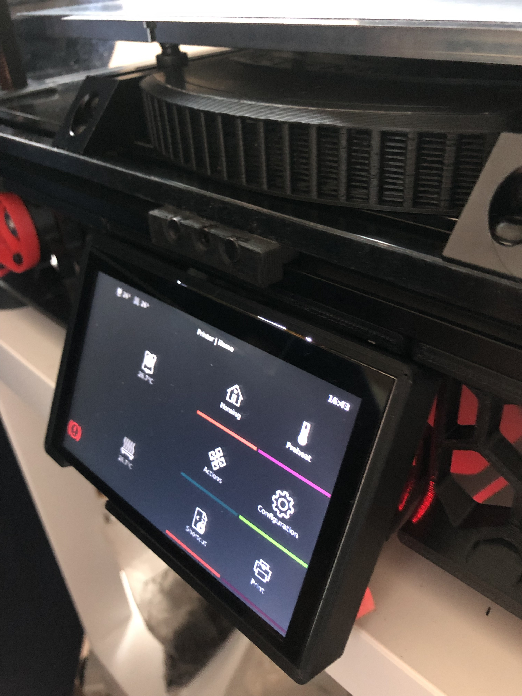
[picture p178: printer_mods/alanho/BTT_PITFT50_v2_Mount/images/IMG_6451.jpg]

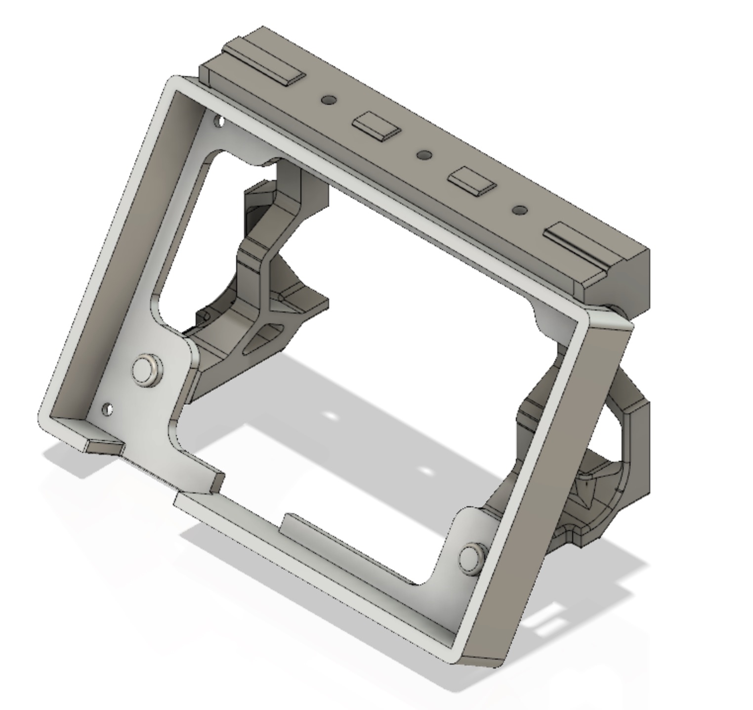
[picture p179: printer_mods/alanho/BTT_PITFT50_v2_Mount/images/f360.jpg]


## BOM

- 4x M3x6mm
- 4x M2.5x4mm (included in the BTT PITFT50 v2)
- 500mm ~ 600mm Ribbon Flat Cable for Raspberry Pi Camera (depends on the position of the Raspberry Pi. The included one is too short)

## Instructions

Please use the [mount in sttts's mods](../../sttts/Waveshare-5.5-inch-HDMI-AMOLED/STLs/Voron-2.4-Mount-Generisch-v6.stl) to amount this to the frame. No re-print of skirts is required!

## Print Settings

Standard Voron recommended print settings
