Yeriwyn/VoronUsers/printer_mods/DaGlo/Voron_V0_Duet_2_WiFi_Mounting_Brackets/README.md

# Duet 2 WiFi mounting bracket with and without RPi

## BOM:

- 6 x M3x12

- 4 x M3x5 heat inserts (should also work with the 4 mm heat inserts)

## for the RPi: 

- 4 x M2.5x8
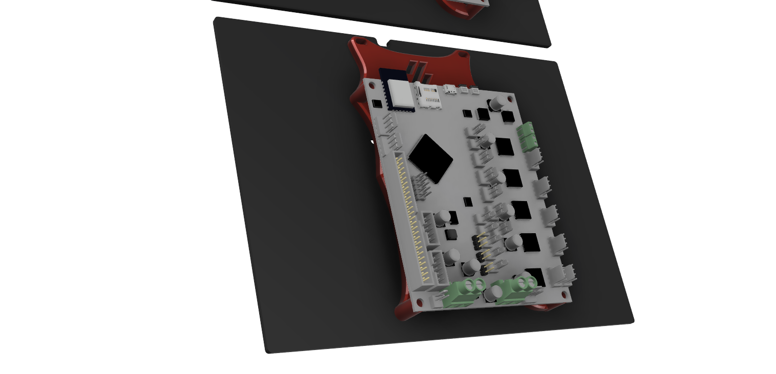
[picture p198: printer_mods/DaGlo/Voron_V0_Duet_2_WiFi_Mounting_Brackets/Voron_V0_Duet_2_Wifi_Bracket_v14.png]
No_RPi

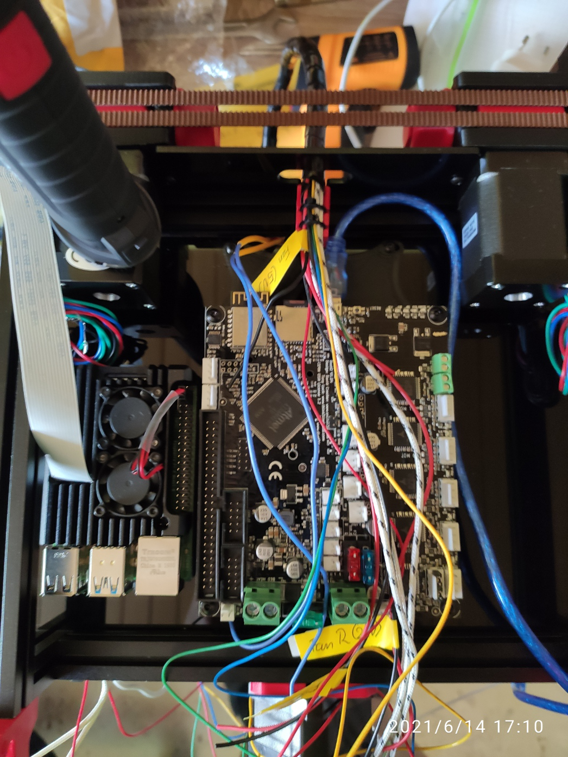
[picture p199: printer_mods/DaGlo/Voron_V0_Duet_2_WiFi_Mounting_Brackets/Duet2WifiMountingBracket.jpg]
Main View

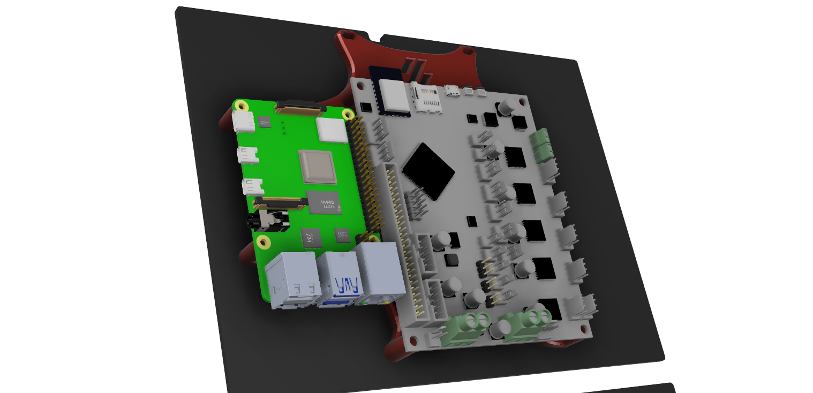
[picture p200: printer_mods/DaGlo/Voron_V0_Duet_2_WiFi_Mounting_Brackets/Voron_V0_Duet_2_Wifi_Bracket_with_RPi_v14.png]
With_RPi
