Yeriwyn/VoronUsers/printer_mods/DaGlo/Voron_V0_MW_PS_Bracket/README.md

# Voron V0 Mean Well power supply bracket (Funssor Kit)

This bracket works for the panel kit from Funssor from AliExpress, which has already some holes on the bottom bracket.

"Funssor upgrade Voron 0 V 0,1 acryl pannel kit für Voron 0,1 3D drucker DIY kit"
https://de.aliexpress.com/item/1005002596904062.html

## BOM:

- 3 x M3x5 heat inserts

- 3 x M3x6 (for the bracket to the panel)

- 2 x M3x3.5 (for the power supply to the bracket)

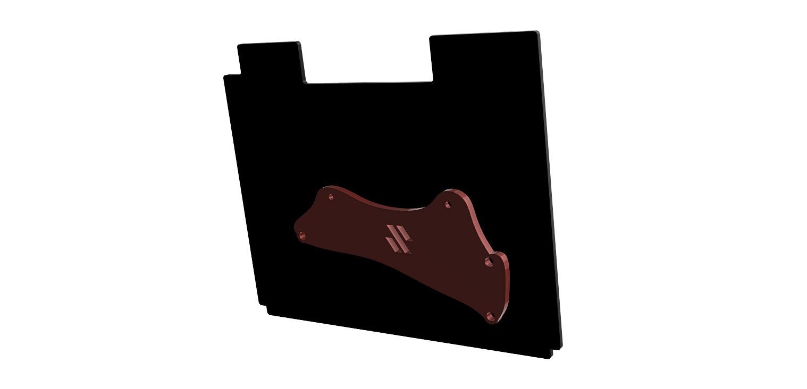
[picture p201: printer_mods/DaGlo/Voron_V0_MW_PS_Bracket/Voron_V0_MW_PS_Bracket_v7_1.png]
Bracket on the panel view

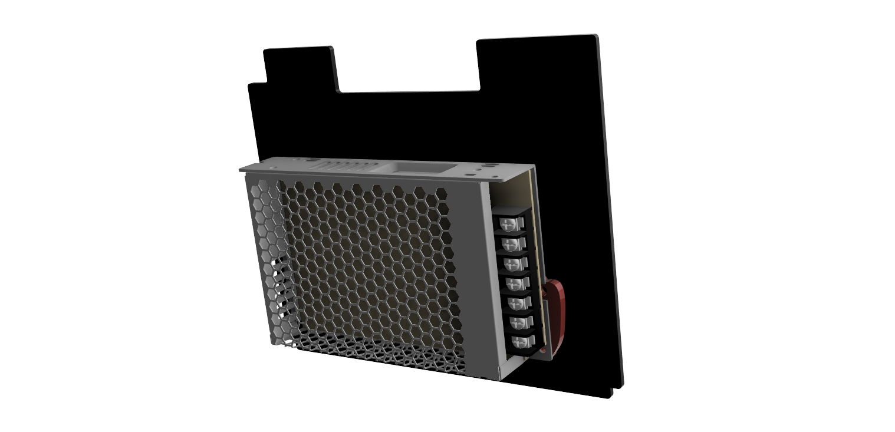
[picture p202: printer_mods/DaGlo/Voron_V0_MW_PS_Bracket/Voron_V0_MW_PS_Bracket_v7_2.png]
Assembled power supply to the panel

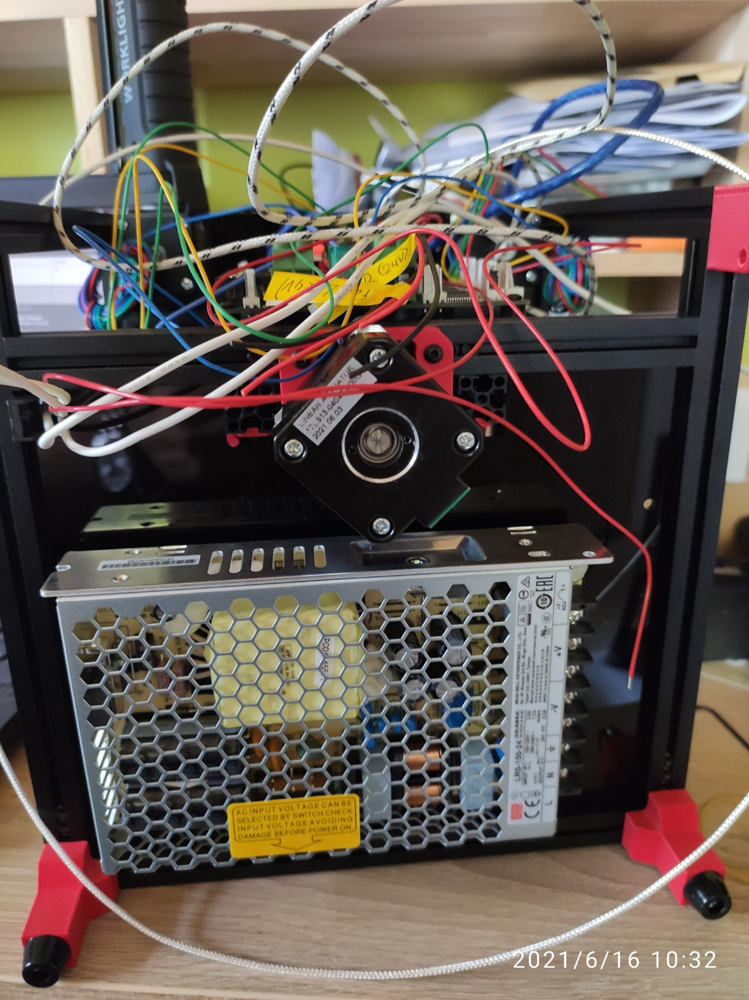
[picture p203: printer_mods/DaGlo/Voron_V0_MW_PS_Bracket/Voron_V0_MW_PS_Bracket.jpg]
Assembled power supply in real
