Yeriwyn/VoronUsers/printer_mods/DaGlo/Voron_V0_SSR_Mount/README.md

# Voron V0 SSR Mount

## BOM:

- 2 x M3x8 (to fix to the 1515 extrusion, the nuts are from the assembly instruction already available, instead of the 5V power supply)

- 2 x M4x12 (for the SSR to the bracket)

- 2 x M4 nuts

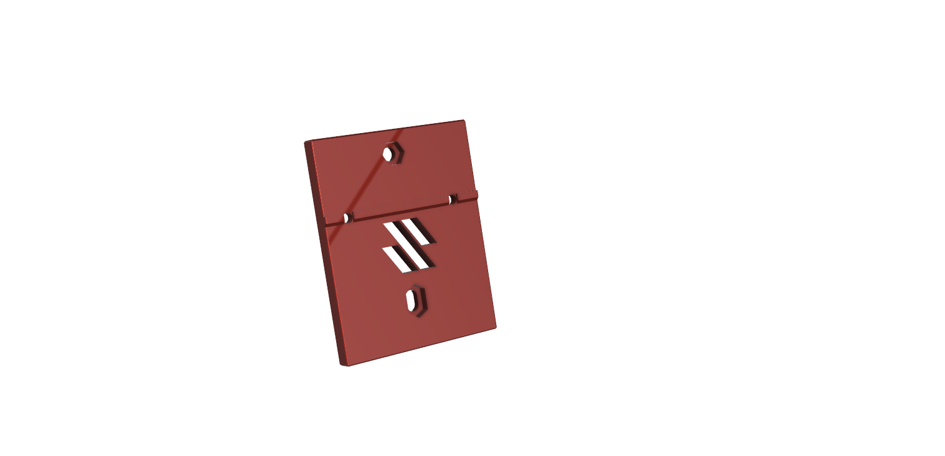
[picture p204: printer_mods/DaGlo/Voron_V0_SSR_Mount/Voron_V0_SSR_Mount_v5_Back.png]
Bracket Back

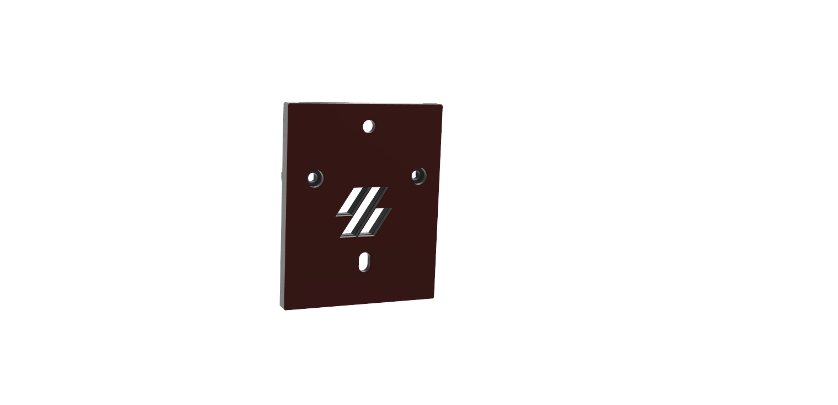
[picture p205: printer_mods/DaGlo/Voron_V0_SSR_Mount/Voron_V0_SSR_Mount_v5_Front.png]
Bracket Front

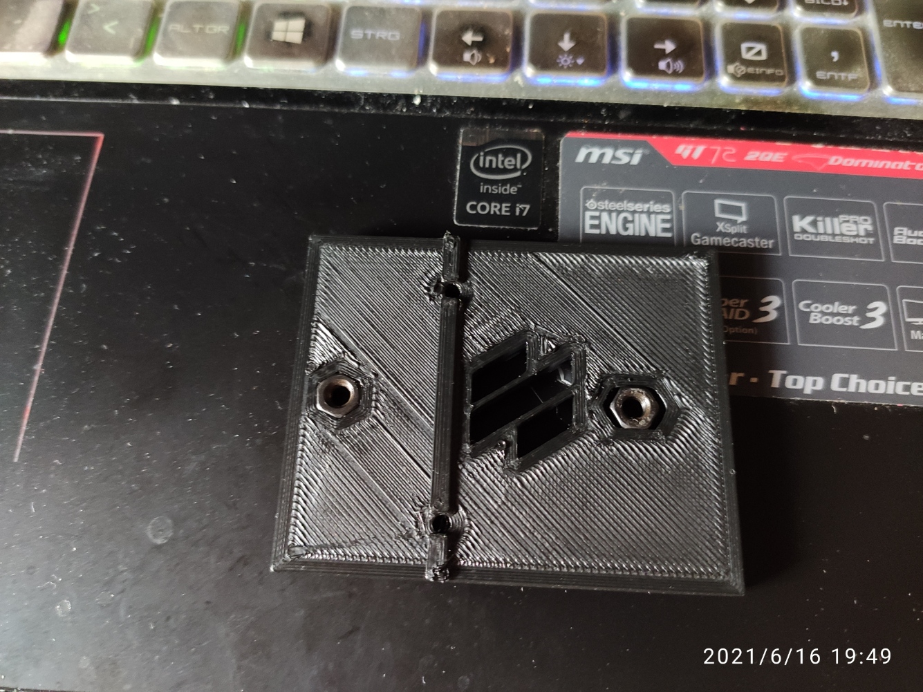
[picture p206: printer_mods/DaGlo/Voron_V0_SSR_Mount/Voron_V0_SSR_Mount_Install_Step_1.jpg]
Installation Step 1

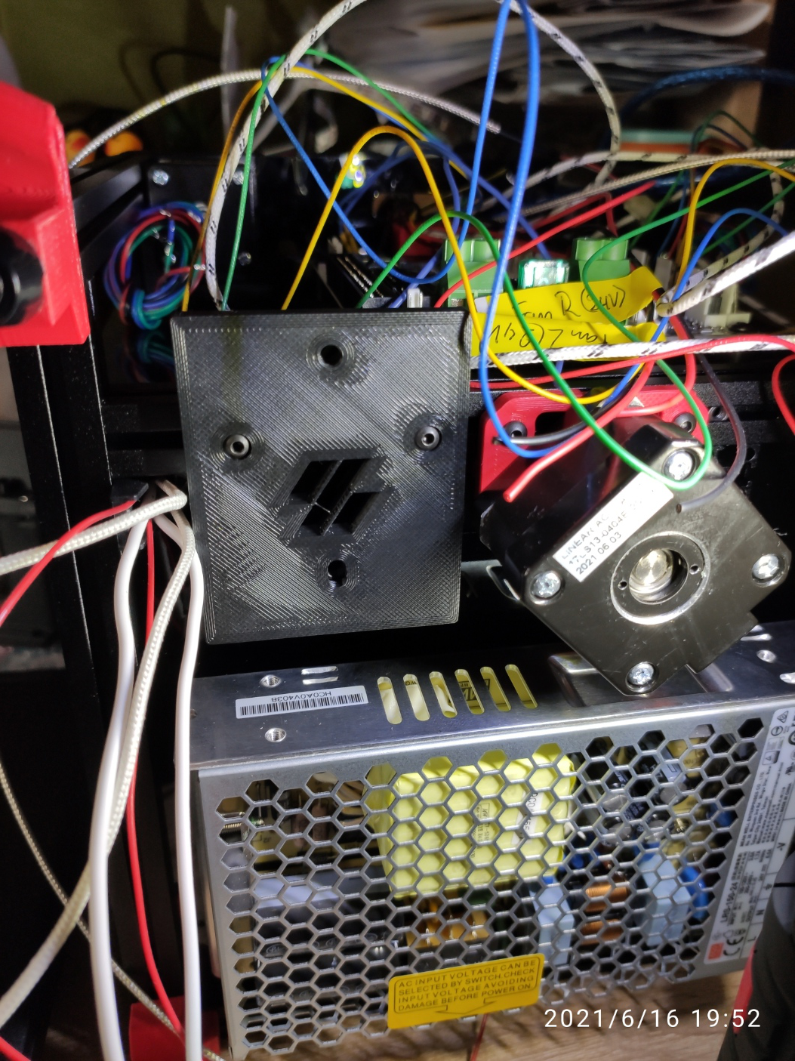
[picture p207: printer_mods/DaGlo/Voron_V0_SSR_Mount/Voron_V0_SSR_Mount_Install_Step_2.jpg]
Installation Step 2

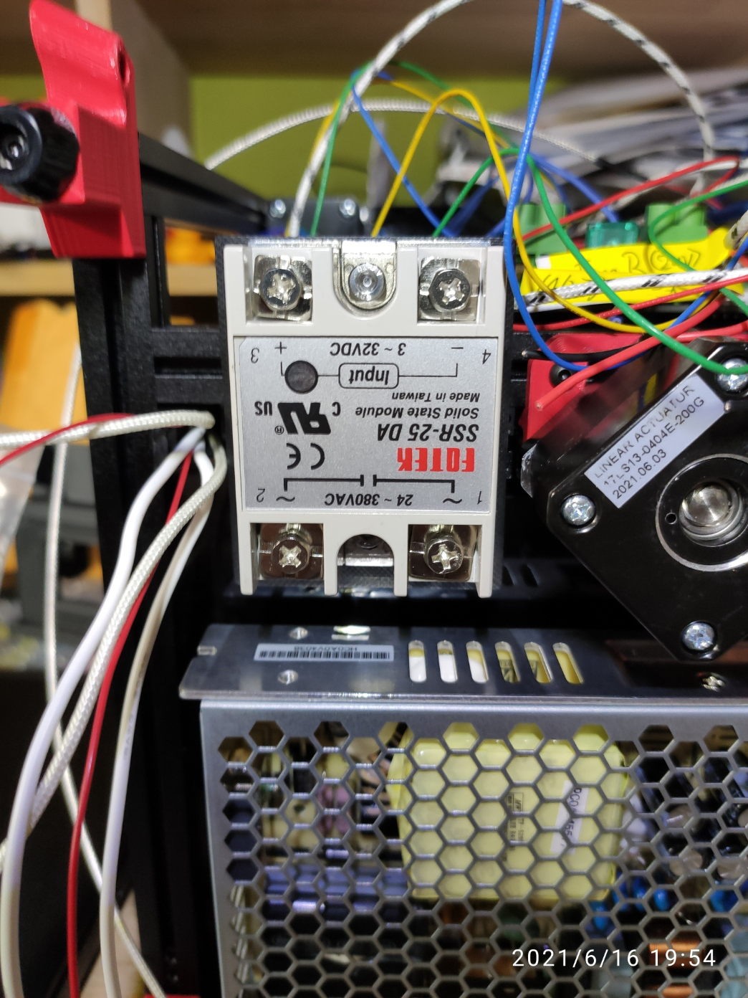
[picture p208: printer_mods/DaGlo/Voron_V0_SSR_Mount/Voron_V0_SSR_Mount_Install_Step_3.jpg]
Installation Step 3
