Yeriwyn/VoronUsers/printer_mods/DoubleT/afterburner_triple_bowden/readme.md

# Afterburner - Triple Bowden

This is a remix of the Dual Bowden but for filaments/extruders. M4 is the recommended extruder.

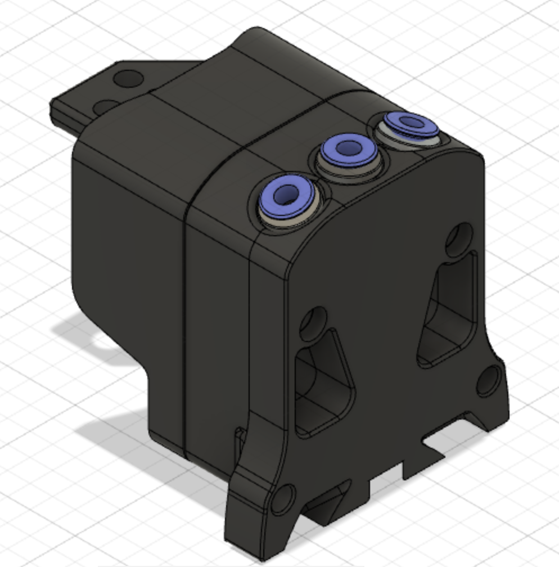
[picture p209: printer_mods/DoubleT/afterburner_triple_bowden/images/image1.png]
Triple Bowden 1


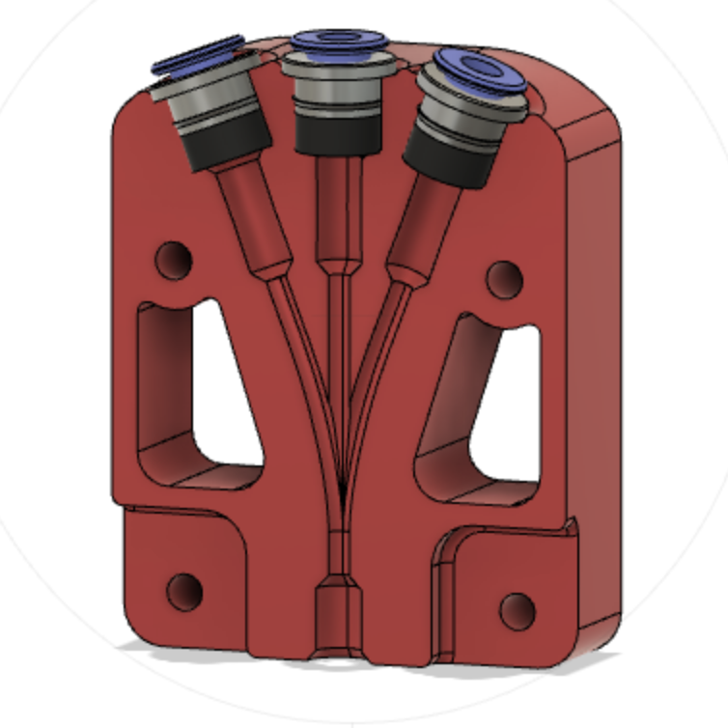
[picture p210: printer_mods/DoubleT/afterburner_triple_bowden/images/image2.png]
Triple Bowden 2


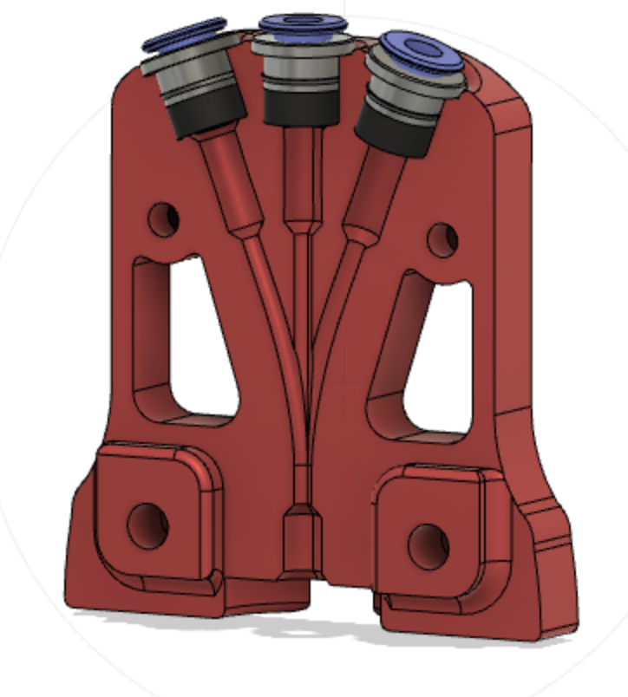
[picture p211: printer_mods/DoubleT/afterburner_triple_bowden/images/image3.png]
Triple Bowden 3
