Yeriwyn/VoronUsers/printer_mods/DoubleT/fysetc_spider_mount_extrusion/readme.md

# Spider Mount for Extrusion

This is a mount for the Fysetc Spider board to be mounted on 2020 or 3030 extrusions.

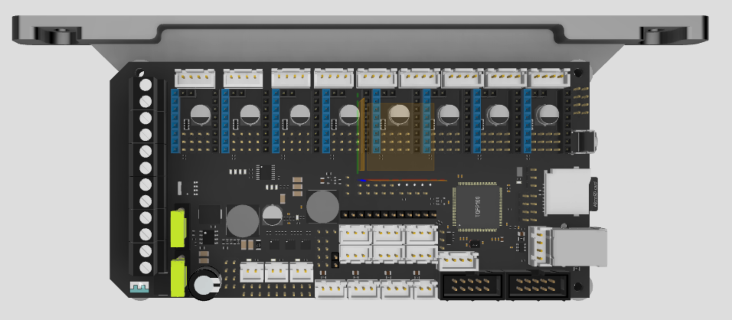
[picture p212: printer_mods/DoubleT/fysetc_spider_mount_extrusion/images/image1.png]
Spider Mount 1


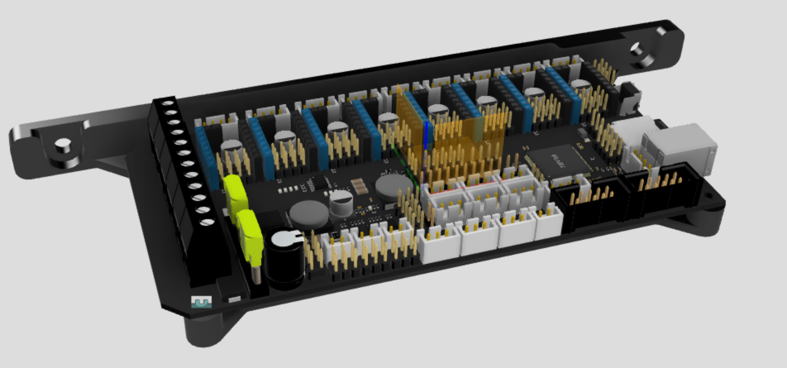
[picture p213: printer_mods/DoubleT/fysetc_spider_mount_extrusion/images/image2.png]
Spider Mount 2


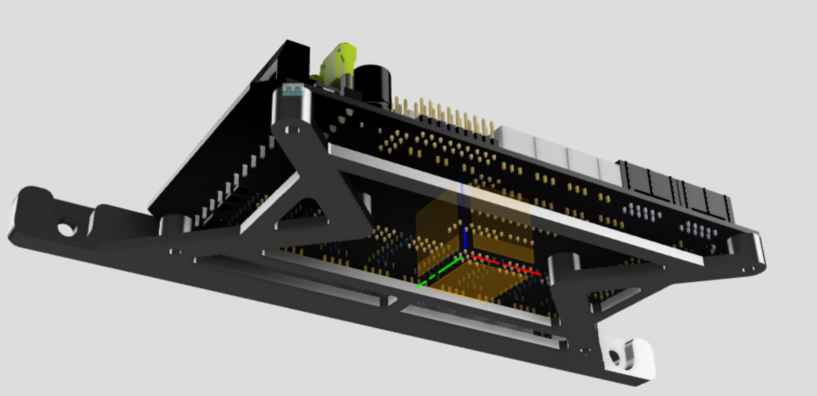
[picture p214: printer_mods/DoubleT/fysetc_spider_mount_extrusion/images/image3.png]
Spider Mount 3
