Yeriwyn/VoronUsers/printer_mods/DoubleT/input_shaper_mount/readme.md

# Input shaper mount for Afterburner

This mod is for mounting the input shaper printed part in front of the afterbuner, but also mounting on the bed for the SW using the magnets. The threaded inserts are for securing the input shaper on the printed part.

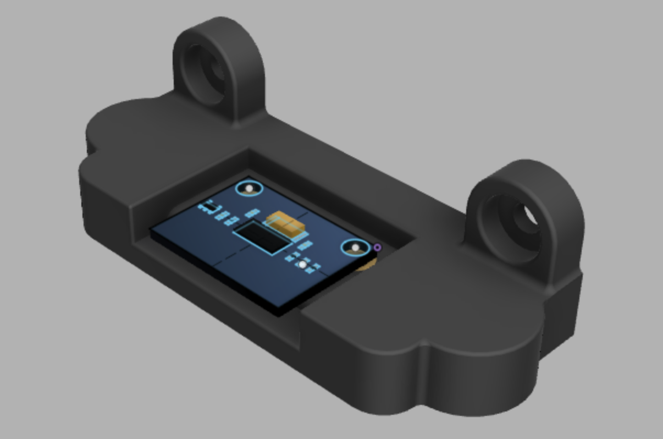
[picture p215: printer_mods/DoubleT/input_shaper_mount/images/image1.png]


## BOM

- 2 Threaded inserts (stock)
- 2 M3x16 BHCS or SHCS
- 2 M3x6 BHCS
- 2 round magnets 8x4
- Input Shaper [ADXL345](https://www.amazon.com/gp/product/B07DMZCGP9)
