Yeriwyn/VoronUsers/printer_mods/DoubleT/switchwire_tft_display/readme.md

# 3.5in TFT Display Front Skirt - Switchwire

This mod replaces the front middle skirt in order to mount a 3.5in touchscreen display for Klipperscreen. It has two printed parts: the main body and the front plate. Threaded inserts go into the main body and the M3x8 screws are used to mount the front plate onto the main body.

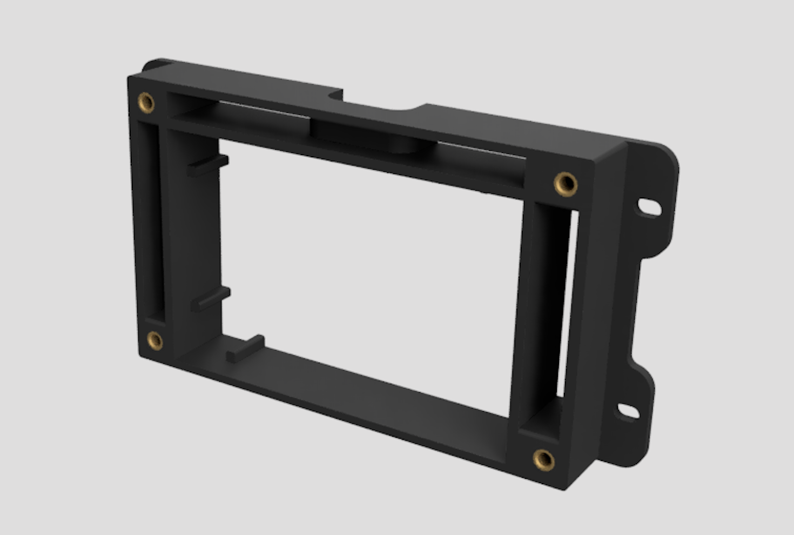
[picture p216: printer_mods/DoubleT/switchwire_tft_display/images/image1.png]


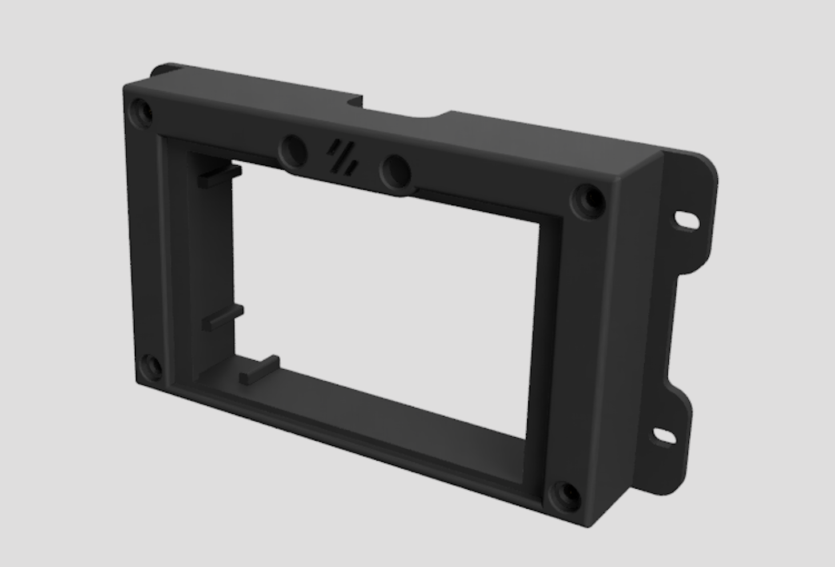
[picture p217: printer_mods/DoubleT/switchwire_tft_display/images/image2.png]


## BOM

- 5 threaded inserts (stock)
- 4 M3x8 BHCS
- [3.5in TFT Display](https://www.amazon.com/gp/product/B07KLDKM5D)

## Software

### Klipperscreen

Follow this [tutorial](https://github.com/jordanruthe/KlipperScreen/blob/master/docs/Installation.md) to install Klipperscreen on your Raspberry Pi.

### LCD Show

Ssh into your Raspberry Pi and execute the following commands

```
sudo rm -rf LCD-show
git clone https://github.com/Lcdwiki/LCD-show.git
chmod -R 755 LCD-show
cd LCD-show
sudo ./MHS35-show
```
