Yeriwyn/VoronUsers/printer_mods/hartk1213/Voron0_MGN9C_X_Axis/Readme.md

MGN9C X axis
============

This replaces the MGN7H rail on the V0.1 X axis with a single MGN9C
rail.

Required hardware
-----------------

In addition to things you can reuse from the stock build, these items are
required:
- 1x MGN9C-150mm linear rail 
- 7x M3x8 
- 7x M3 Nuts

Instructions
------------

Assembly is exactly the same as the stock V0.1 X axis 

Images
------

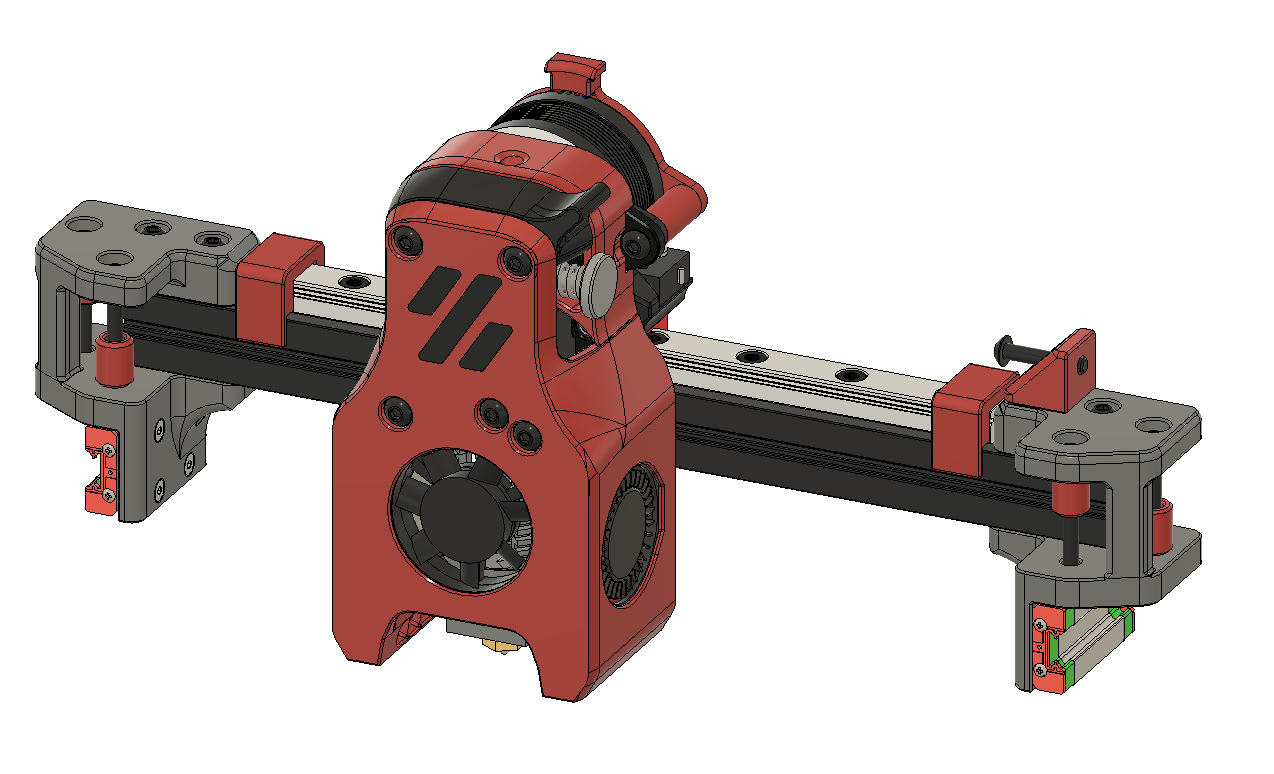
[picture p219: printer_mods/hartk1213/Voron0_MGN9C_X_Axis/Images/x_axis.png]
X-axis rendered


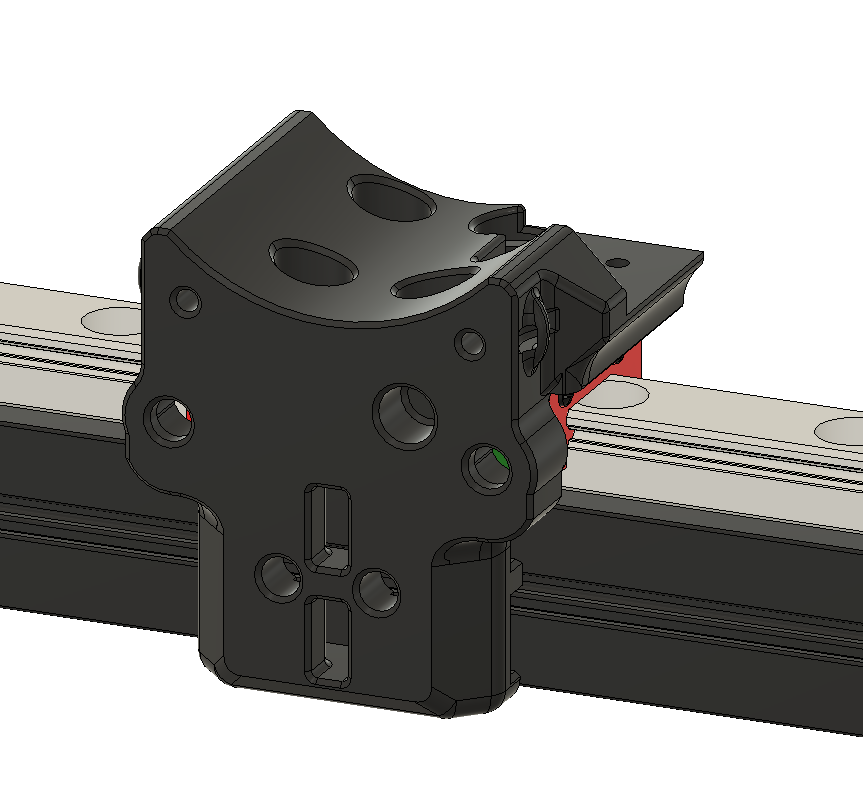
[picture p220: printer_mods/hartk1213/Voron0_MGN9C_X_Axis/Images/carraige.png]
Carriage rendered
