Yeriwyn/VoronUsers/printer_mods/LoCoCNC/ssr_strap/readme.md

SSR Strap for attaching the V0 SSR to a 1515 extrusion.

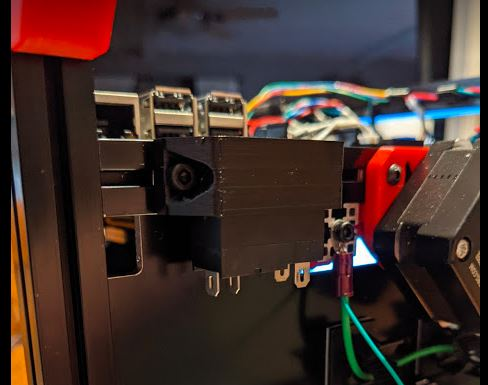
[picture p248: printer_mods/LoCoCNC/ssr_strap/ssr_strap.JPG]
Image of SSR_strap

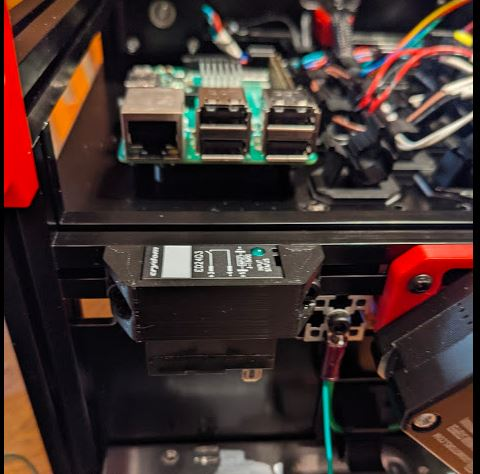
[picture p249: printer_mods/LoCoCNC/ssr_strap/ssr_strap2.JPG]
Image of SSR_strap2
