Yeriwyn/VoronUsers/printer_mods/LoCoCNC/Strain_Relief_w_Microfit/readme.md

Strain Relief to Mount a Microfit 10 pin panel mount connector. Pics have bent cable tie from previous iteration, for printability without supports the STL included prints without support in your slicer. The hole for the connector has a V shaped built-in support that must be cut away to insert connector. Easily snips away with your flush cutters.

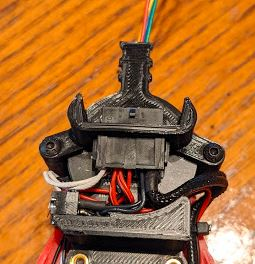
[picture p250: printer_mods/LoCoCNC/Strain_Relief_w_Microfit/Images/pic1.JPG]
Image of Strain Relief 1

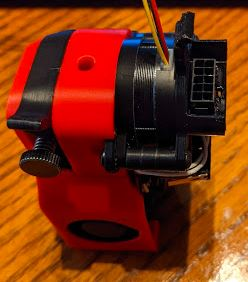
[picture p251: printer_mods/LoCoCNC/Strain_Relief_w_Microfit/Images/pic2.JPG]
Image of Strain Relief 2

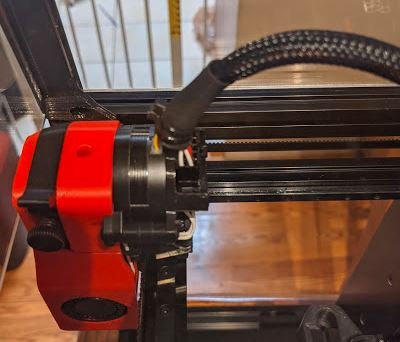
[picture p252: printer_mods/LoCoCNC/Strain_Relief_w_Microfit/Images/pic3.JPG]
Image of Strain Relief 3

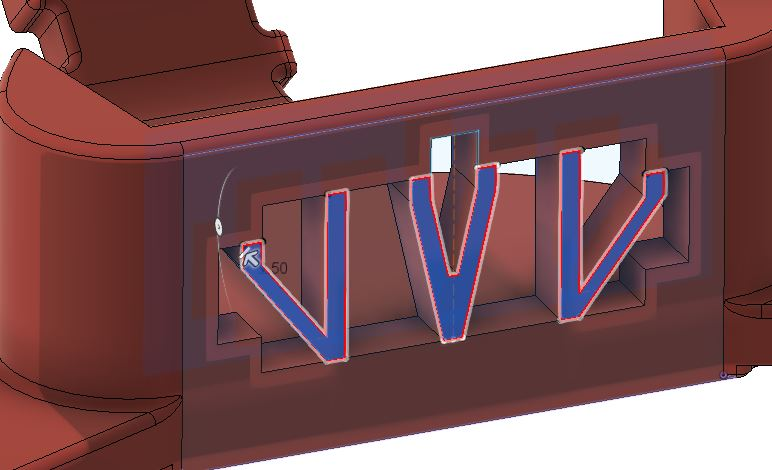
[picture p253: printer_mods/LoCoCNC/Strain_Relief_w_Microfit/Images/remove.JPG]
Image of Strain Relief 3
