Yeriwyn/VoronUsers/printer_mods/oxno/rbp_zero_braket/README.md

This is a bracket for a raspberry pi zero / w
the bracket mounts to the din rail using "pcb_din_clip_x3.stl"

To mount the rbp zero w, I used steel thread rolling screws for plastic pan head #3-24 thread size, 5/16" length.

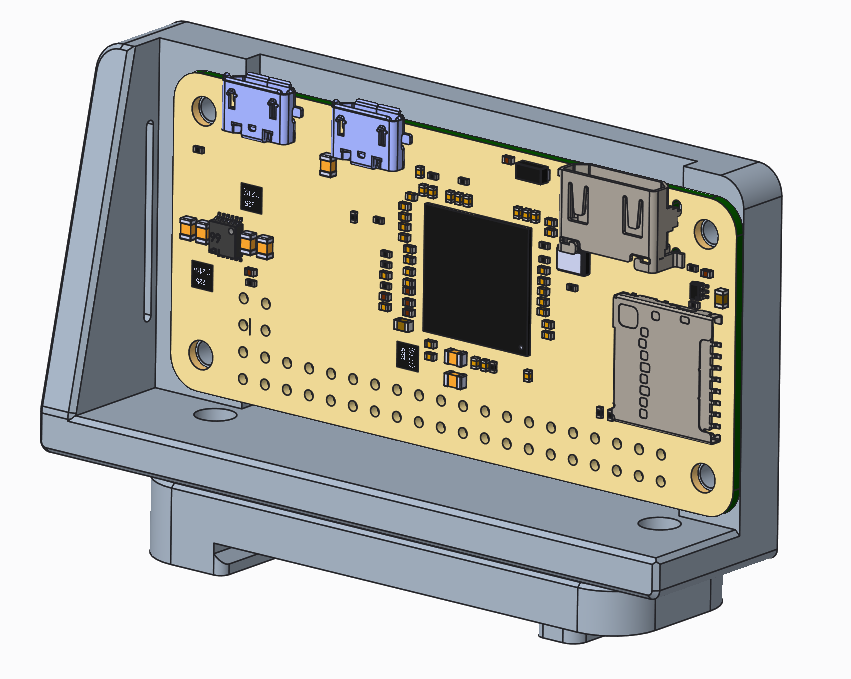
[picture p262: printer_mods/oxno/rbp_zero_braket/rbp_bracket_front.png]
rbp_bracket_front

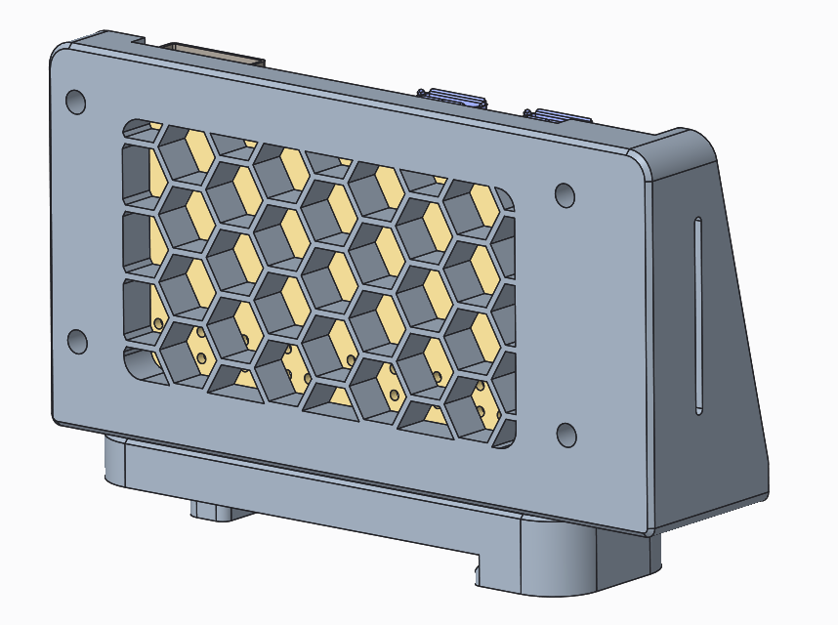
[picture p263: printer_mods/oxno/rbp_zero_braket/rbp_bracket_back.png]
rbp_bracket_back
