Yeriwyn/VoronUsers/printer_mods/wile-e1/Deck_Panel_Support_Clips/readme.md

### Deck Panel Support Clips

These are simple panel support clips to help better support the lower deck panels of a V2.4 and other similar models.  They sandwich the deck sheet between an upper and lower support and are held in with M3 SHCS or M3 BHCS.

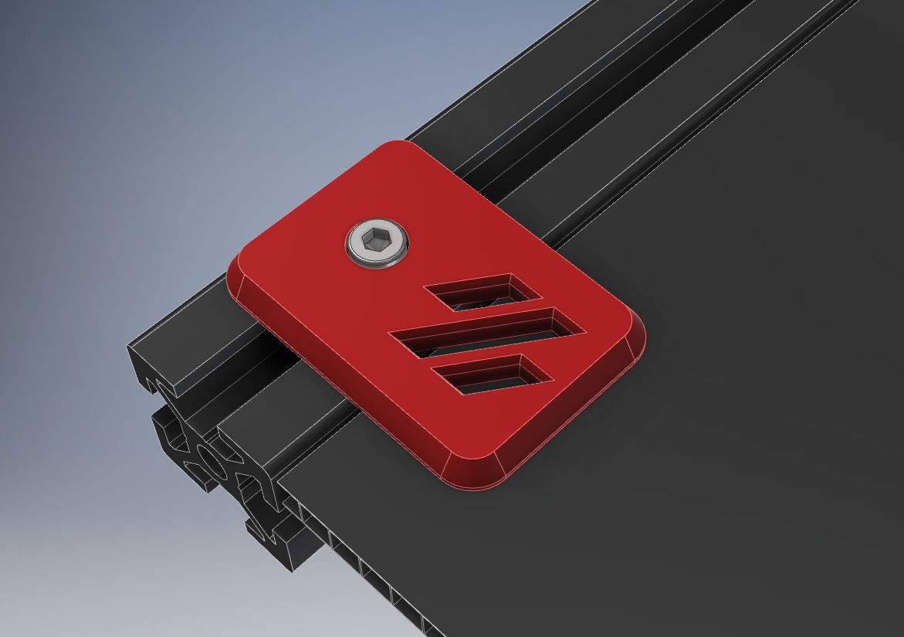
[picture p271: printer_mods/wile-e1/Deck_Panel_Support_Clips/deck_clip_top.png]
Top


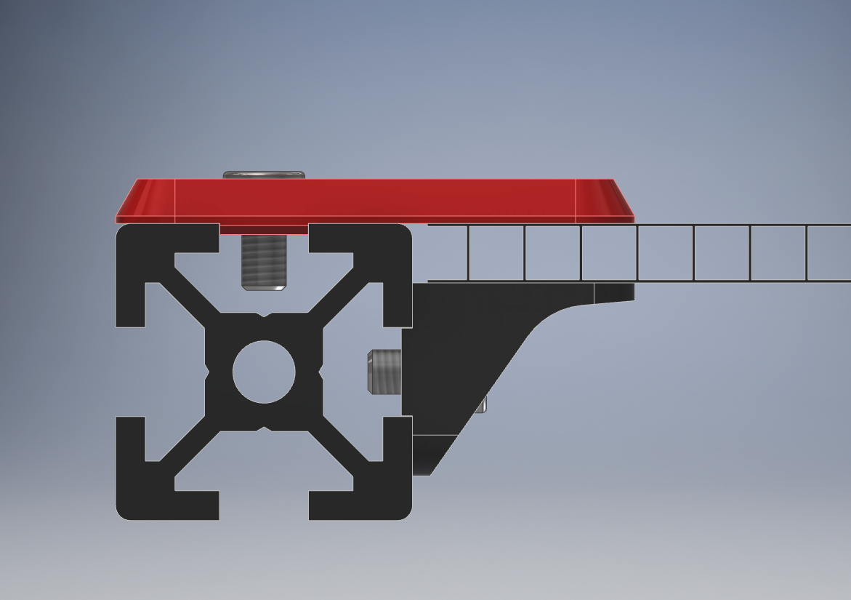
[picture p272: printer_mods/wile-e1/Deck_Panel_Support_Clips/deck_clip_side.png]
Side


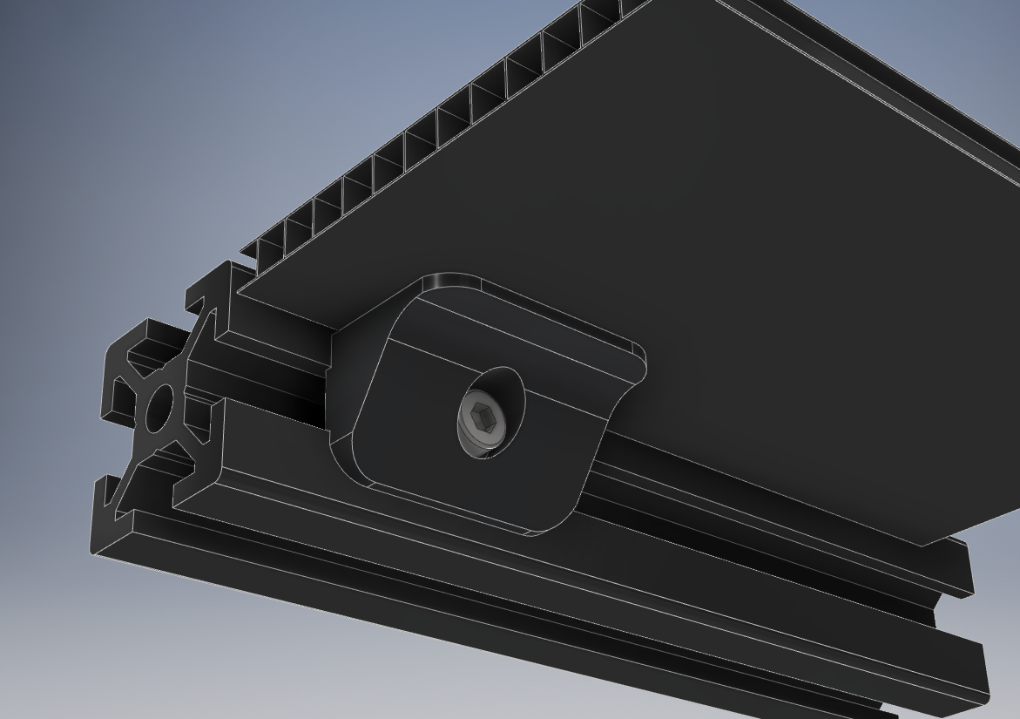
[picture p273: printer_mods/wile-e1/Deck_Panel_Support_Clips/deck_clip_bottom.png]
Bottom


And the optional slotted lower mount to accommodate panels between 2mm and 6mm.

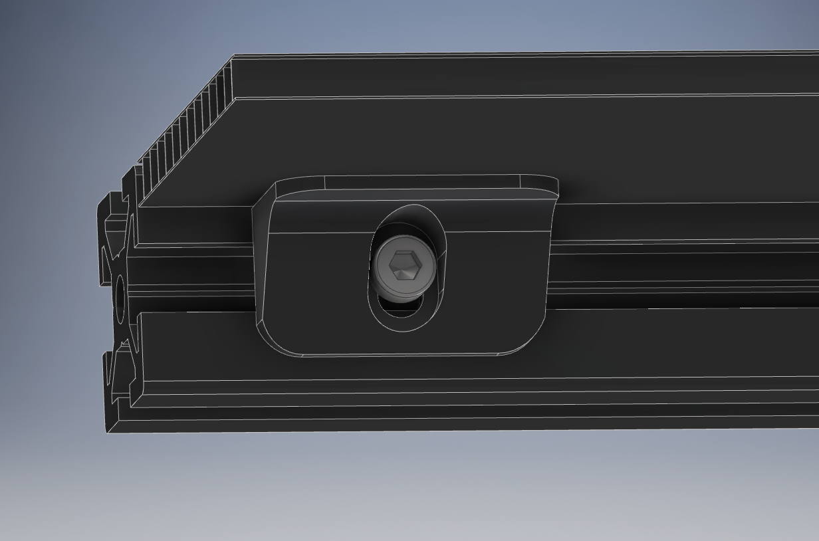
[picture p274: printer_mods/wile-e1/Deck_Panel_Support_Clips/deck_clip_adjustable.png]
Adjustable_Bottom
