Yeriwyn/VoronUsers/printer_mods/JosAr/Klicky-Probe/CAD/README.md

CAD files

- Version 0.1 - initial release
- Version 0.2 - Revised probe and dock to improve the docking fit, remaining components are compatible
  - Thanks to oc_geek for improving the probing of a badly tilted gantry (10º) and the probe and dock attachment, it's much better now
