Yeriwyn/VoronUsers/printer_mods/KevinAkaSam/VEFACH/STL_CAD/stlcad.md

All STL + CAD files.
Please take a look at the instructions listed in the main README before printing.
Feel free to modify the parts :)
