Yeriwyn/VoronUsers/printer_mods/JosAr/Klicky-Probe/Photos/AB_Mount_install_2.jpg

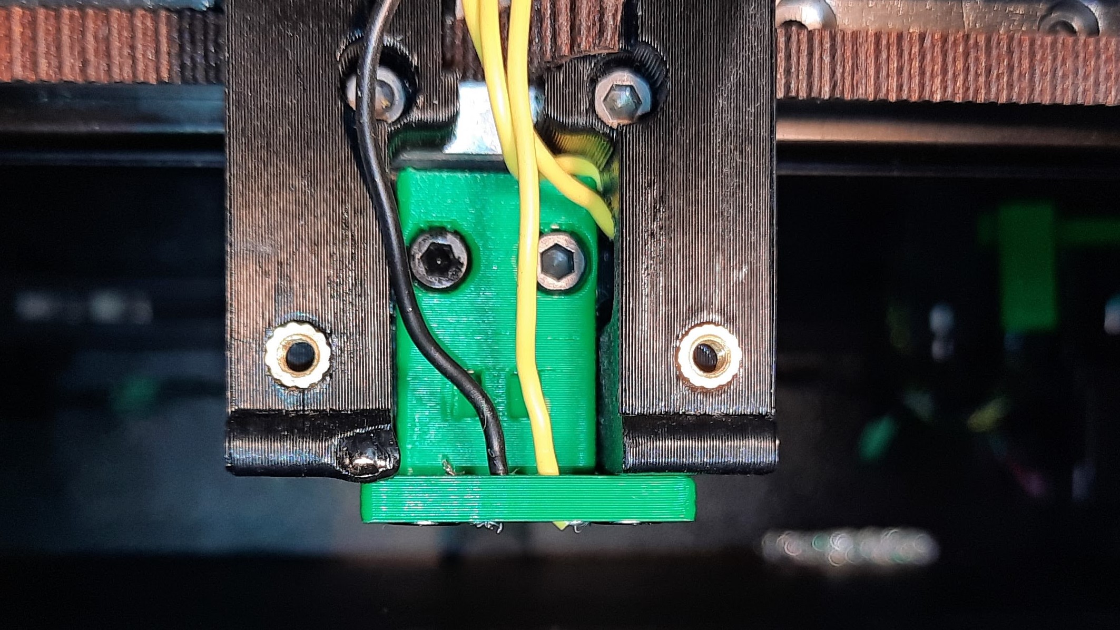
printer_mods/JosAr/Klicky-Probe/Photos/AB_Mount_install_2.jpg
