Yeriwyn/VoronUsers/printer_mods/JosAr/Klicky-Probe/Photos/AB_Mount_install_complete.jpg

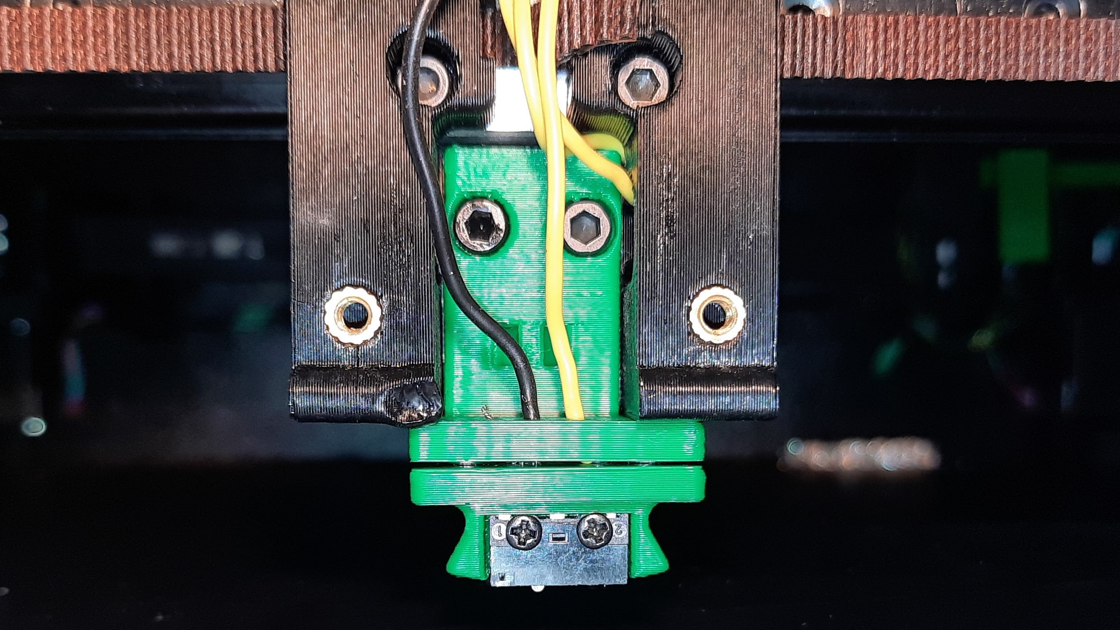
printer_mods/JosAr/Klicky-Probe/Photos/AB_Mount_install_complete.jpg
