Yeriwyn/VoronUsers/printer_mods/JosAr/Klicky-Probe/Photos/Klicky_Probe_installed.png

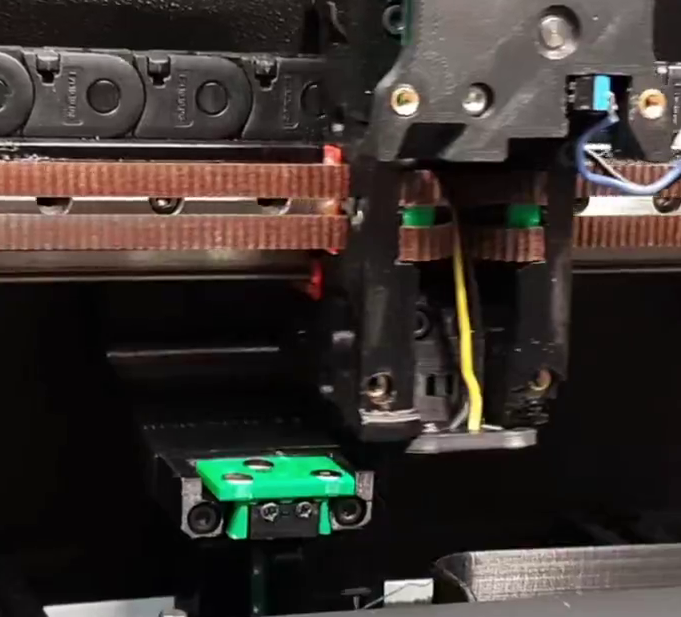
printer_mods/JosAr/Klicky-Probe/Photos/Klicky_Probe_installed.png
