Yeriwyn/VoronUsers/printer_mods/JosAr/Klicky-Probe/Photos/Klicky_Probe_recommended_printing_orientation.png

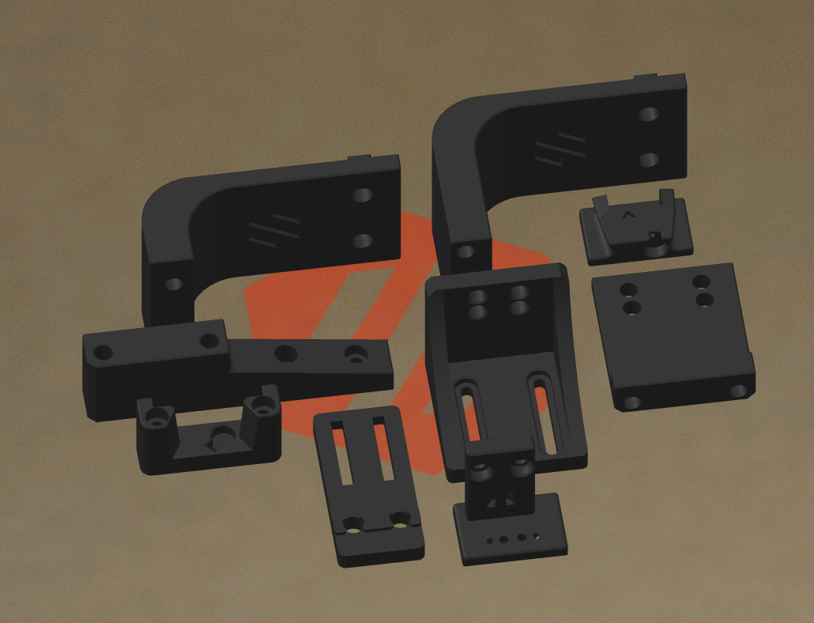
printer_mods/JosAr/Klicky-Probe/Photos/Klicky_Probe_recommended_printing_orientation.png
