Yeriwyn/VoronUsers/printer_mods/JosAr/Klicky-Probe/Photos/probe_dock_2.jpg

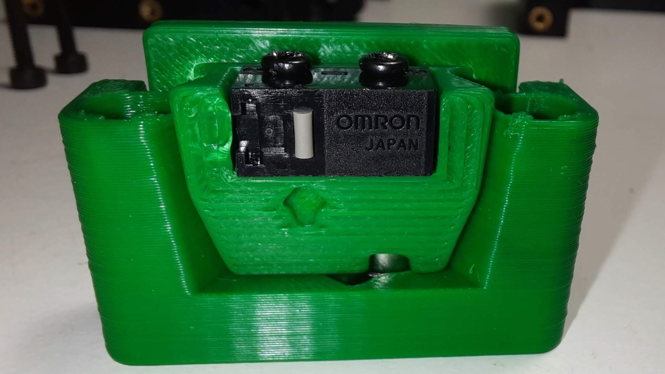
printer_mods/JosAr/Klicky-Probe/Photos/probe_dock_2.jpg
