Yeriwyn/VoronUsers/printer_mods/Phalanx/Other-V2-Idlers/Images/printset.JPG

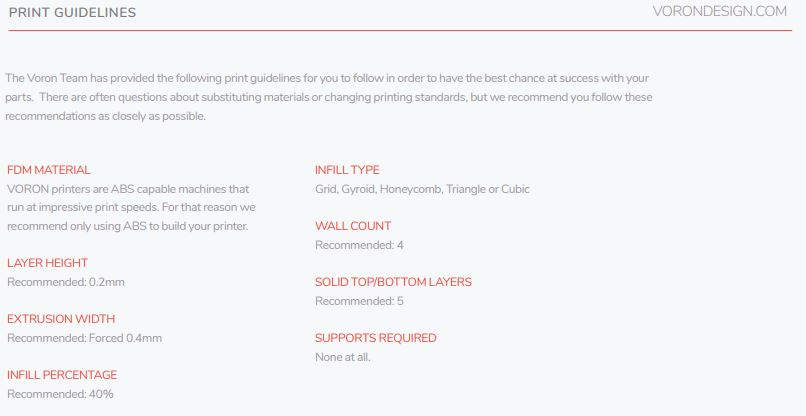
printer_mods/Phalanx/Other-V2-Idlers/Images/printset.JPG
