Yeriwyn/VoronUsers/printer_mods/yeri/V0_Magnetic_Panels/images/front_and_rear_panel_mount.png

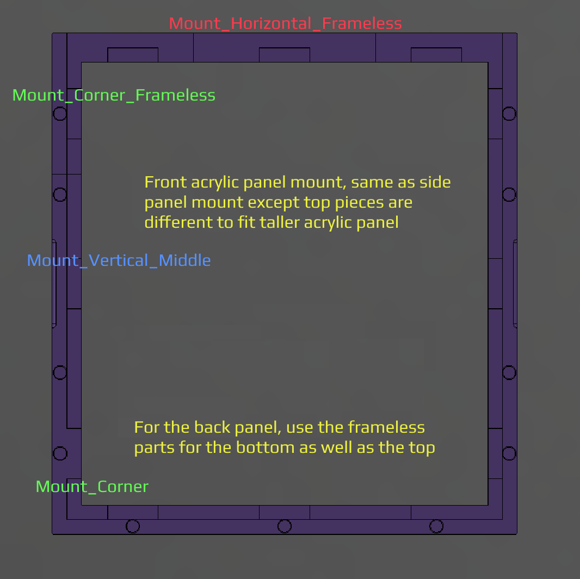
printer_mods/yeri/V0_Magnetic_Panels/images/front_and_rear_panel_mount.png
