Yeriwyn/VoronUsers/printer_mods/yeri/V0_Magnetic_Panels/images/front_and_rear_plate.png

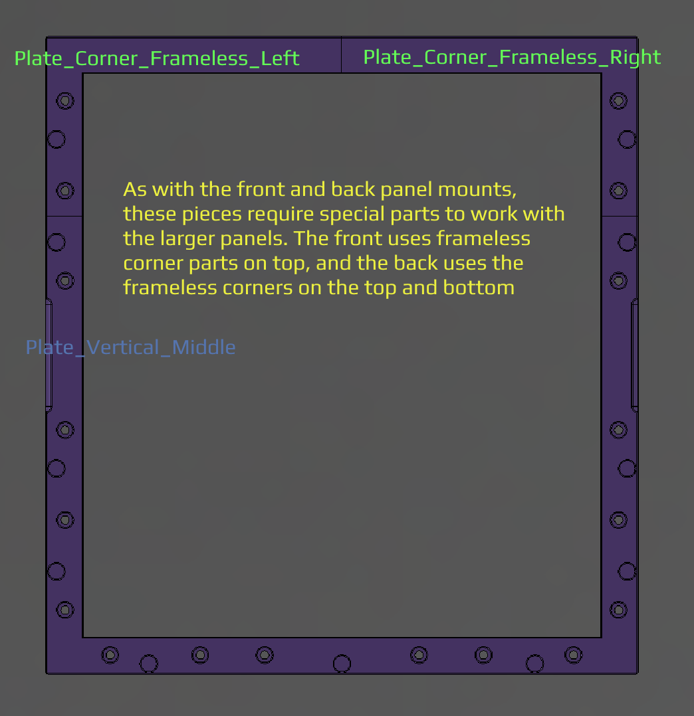
printer_mods/yeri/V0_Magnetic_Panels/images/front_and_rear_plate.png
