Yeriwyn/VoronUsers/printer_mods/yeri/V0_Magnetic_Panels/images/Side_panel_mount.png

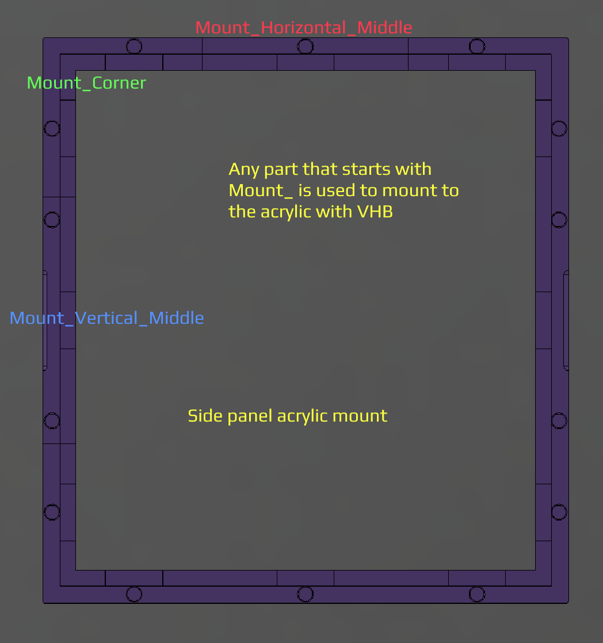
printer_mods/yeri/V0_Magnetic_Panels/images/Side_panel_mount.png
