Yeriwyn/VoronUsers/printer_mods/yeri/V0_Magnetic_Panels/images/Side_Plate.png

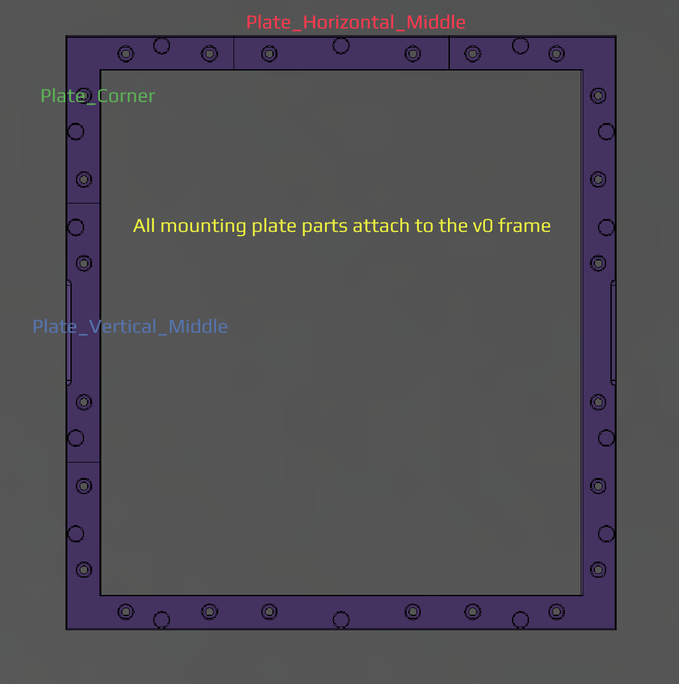
printer_mods/yeri/V0_Magnetic_Panels/images/Side_Plate.png
