Yeriwyn/VoronUsers/(commit log)

2021-05-28 Added all new panel stls, single piece and split
    [Front Mounting Plate.stl, Front Panel Mount.stl, Mount_Corner_frameless_x6.stl, Mount_Corner_x10.stl, Mount_Horizontal_Frameless_x3.stl, Mount_Horizontal_Middle_x5.stl, Mount_Vertical_Middle_x8.stl, Plate_Corner_Frameless_Left_x3.stl]
2021-05-28 Added plates from plater for convenience
    [plate_001.stl, plate_002.stl, plate_003.stl, plate_004.stl, plate_005.stl, plate_006.stl, plate_007.stl, plate_008.stl]
2021-05-28 Removed old files
    [Mounting_Plate_v2.stl, Panel_Mount_v2.stl, Side_Mounting_Plate.stl, Side_Panel_Mount.stl]
2021-05-28 Fixed typo in dimension causing a few magnets to not be symmetrical
    [Front Mounting Plate.stl, Front Panel Mount.stl, Mount_Corner_frameless_x6.stl, Mount_Corner_x10.stl, Mount_Vertical_Middle_x8.stl, Plate_Corner_Frameless_Left_x3.stl, Plate_Corner_Frameless_Right_x3.stl, Plate_Corner_x10.stl]
2021-05-28 Increased magnet hole size a little for better tolerance
    [Front Mounting Plate.stl, Front Panel Mount.stl, Mount_Corner_frameless_x6.stl, Mount_Corner_x10.stl, Mount_Horizontal_Frameless_x3.stl, Mount_Horizontal_Middle_x5.stl, Mount_Vertical_Middle_x8.stl, Plate_Corner_Frameless_Left_x3.stl]
2021-05-28 This is a combination of 4 commits.
    Increased magnet hole size a little for better tolerance
    Fixed dimension typo again, for real this time... fusion why you hate me?
    Cleanup
    Cleanup
    [Front Mounting Plate.stl, Front Panel Mount.stl, Mount_Corner_frameless_x6.stl, Mount_Corner_x10.stl, Mount_Horizontal_Frameless_x3.stl, Mount_Horizontal_Middle_x5.stl, Mount_Vertical_Middle_x8.stl, Plate_Corner_Frameless_Left_x3.stl]
2021-06-01 Added images, removed plates
    [plate_001.stl, plate_002.stl, plate_003.stl, plate_004.stl, plate_005.stl, plate_006.stl, plate_007.stl, plate_008.stl]
2021-06-04 Work in progress
    [Panel_Top_Left_and_Bottom_Right_x2.stl, Panel_Top_Right_and_Bottom_Left_x2.stl, Top_Left_and_Bottom_Right_x2.stl, Top_Right_and_Bottom_Left_x2.stl]
2021-06-11 Added side panel and organized directories
    [Panel_Top_Left_and_Bottom_Right_x2.stl, Panel_Top_Right_and_Bottom_Left_x2.stl, Top_Left_and_Bottom_Right_x2.stl, Top_Right_and_Bottom_Left_x2.stl]
2021-06-11 Added non-hinge parts to side panel
    [Panel_Top_Left_and_Bottom_Right_with_Hinge_x1.stl, Panel_Top_Left_and_Bottom_Right_x1.stl, Panel_Top_Right_and_Bottom_Left_with_Hinge_x1.stl, Panel_Top_Right_and_Bottom_Left_x1.stl, Top_Left_and_Bottom_Right_with_Hinge_x1.stl, Top_Left_and_Bottom_Right_x1.stl, Top_Right_and_Bottom_Left_with_Hinge_x1.stl, Top_Right_and_Bottom_Left_x1.stl]
2021-06-11 More re-org
    [Panel_Top_Left_and_Bottom_Right_with_Hinge_x1.stl, Panel_Top_Left_and_Bottom_Right_x1.stl, Panel_Top_Left_and_Bottom_Right_x2.stl, Panel_Top_Right_and_Bottom_Left_with_Hinge_x1.stl, Panel_Top_Right_and_Bottom_Left_x1.stl, Panel_Top_Right_and_Bottom_Left_x2.stl, Top_Left_and_Bottom_Right_with_Hinge_x1.stl, Top_Left_and_Bottom_Right_x1.stl]
2021-06-22 First release for v1-300 panels
    [Panel_Top_Left_and_Bottom_Right_with_Hinge_x1.stl, Panel_Top_Left_and_Bottom_Right_x1.stl, Panel_Top_Left_and_Bottom_Right_x2.stl, Panel_Top_Left_and_Bottom_Right_x2_Side_Panel.stl, Panel_Top_Left_and_Bottom_Right_x2_Top_Panel.stl, Panel_Top_Right_and_Bottom_Left_with_Hinge_x1.stl, Panel_Top_Right_and_Bottom_Left_x1.stl, Panel_Top_Right_and_Bottom_Left_x1_Side_Panel.stl]
2021-06-30 Added handle, cleaned up file names, tweaked magnet hole size
    [Handle_x2.stl, Panel_Top_Left_and_Bottom_Right_with_Hinge_x1.stl, Panel_Top_Left_and_Bottom_Right_x1.stl, Panel_Top_Left_and_Bottom_Right_x2.stl, Panel_Top_Left_and_Bottom_Right_x2_Side_Panel.stl, Panel_Top_Left_and_Bottom_Right_x2_Top_Panel.stl, Panel_Top_Right_and_Bottom_Left_with_Hinge_x1.stl, Panel_Top_Right_and_Bottom_Left_x1_Side_Panel.stl]
